Beiyiovo/stm32-infusion-monitor/README.md

# 基于单片机的输液状态 WiFi 监测装置

> 毕业设计 · 电子工程学院 · 物联网工程
> 状态：**硬件全功能打通，收尾中**（2026-10-27：13 段固件 + App v3，称重已达标 ±0.1g；PCB 待打样）

用 STM32 采集输液液体的**温度**与**剩余重量**，OLED 实时显示，超阈值时蜂鸣器 + LED 分级报警，
再通过 WiFi 把数据送到手机上查看。

---

> 📦 **接收方先看 [`交付说明.md`](交付说明.md)**——那里写清了目录结构、复现步骤、验证程度与已知限制。
> 本 README 是面向开发者的技术说明。

## 一、课题指标

| # | 要求 | 指标 | 实现手段 | 状态 |
|---|---|---|---|---|
| 1 | 液体温度采集 | 25~42℃，≤±0.5℃ | DS18B20（12 位） | ✅ 上板验证（34.2→35.2℃ 连续变化；探头接触故障已排除） |
| 2 | 液体重量采集 | ≤±2g | 1kg 悬臂梁 + HX711（24 位） | ✅ **达标**：741.6 counts/g 砝码标定，复核最大偏差 ±0.1 g（余量 20 倍） |
| 3 | 报警 | 按键自定义阈值 + 蜂鸣器 + LED | 4 键 UI + 黄/红两级 + 进阶阈值页 | ✅ 上板验证（常规/进阶阈值可改，声光动作正确） |
| 4 | 显示 | 实时显示温度与重量 | 0.96" OLED（SSD1306，I2C） | ✅ 上板验证（88 字中文界面：温度/重量/滴速） |
| 5 | WiFi 上传 | 手机查看 | ESP32-C3（AT 固件）TCP Server + 安卓 App | ✅ 上板验证（热点+TCP+App 收到数据） |
| 6 | 滴速采集 | 滴/min | 红外对射（分体式）+ 外部中断计数 | ⏳ 模块已接入，开机自检通过；整机滴速计数待最终联调 |

### 称重标定进度（2026-10-27，砝码组）

| 项 | 值 |
|---|---|
| 零点 ZERO | 765410（空秤实测；整机每次开机自动去皮重采） |
| 换算系数 SCALE | **741.6 counts/g**（KEY4 实测 742.35，按复测 -0.1 g 微调） |
| 标定基准 | 标准砝码组 5/10/20/20/50 g（锚定点 = 50+20+20+10 = 100 g） |
| 线性度 | 50g → 740.0、100g → 741.0 counts/g（0.14%） |
| 复核 | 5 / 10 / 50 / 105 g 全过，最大偏差 ±0.1 g（指标 ±2 g，余量 20 倍） |
| 历史教训 | 10-24 用水初标 802.0，秤架重装后实测 742（差 8%）——**装盒后必须重标** |

**复标公式**：`新系数 = 旧系数 × (装置读数 ÷ 砝码真实重量)`（`11_calib` 固件可直接输出）

**显示微调说明**：W = counts ÷ K，显示要往上、系数就往下；±0.1 g 已是 0.1g 分辨率的最小一格，到达噪声地板后不再追调。

## 二、硬件构成

| 器件 | 型号 / 规格 | 作用 | 备注 |
|---|---|---|---|
| 主控 | STM32F103C8T6 最小系统板 | 采集、显示、报警、数据打包 | 蓝板，**无板载 CH340** |
| 无线 | ESP32-C3 核心板（CORE-ESP32，4MB） | WiFi + TCP Server | 烧 AT 固件 V4.1.1.0 |
| 温度 | DS18B20 防水探头 | 液体温度 | 精度规格本身 ±0.5℃ |
| 称重 | 1kg 悬臂梁 + HX711 | 剩余药量 | 0.05%FS 估算 ≈ 0.5g |
| 滴速 | 红外对射（分体式）+ 遮光罩 | 数滴/分钟 | 夹滴壶两侧；槽型光耦装不上 |
| 显示 | 0.96 寸 OLED，I2C，4 针 | 人机界面 | 需 4.7kΩ 上拉 |
| 报警 | 有源蜂鸣器模块 + 红/黄 LED | 分级报警 | 蜂鸣器 VCC 必须 3.3V |
| 输入 | 轻触按键 6×6×5 ×4 | 设置/加/减/确认 | 内部上拉，另一端接 GND |

引脚分配与逐脚接线见 [`文档/502引脚分配与逐脚连线表.docx`](文档/)。

---

## 三、目录结构

```
.
├─ README.md            ← 本文件
├─ 代码/                ← Keil MDK 工程（分阶段，每段可单独编译烧录）
│   ├─ build.bat        ← 一键编译：build.bat 01_uart
│   └─ 01_uart/         ← 阶段 1：串口 + 心跳
├─ 文档/                ← 需求、选型、采购、接线、验证方案
├─ 测试记录/            ← 标定数据、串口日志、实物照片
├─ _工具/               ← 生成文档的 Python 脚本（改文档先改脚本）
└─ AGENTS.md            ← 开发过程记录（决策、踩坑、进度）
```

---

## 四、快速开始

### 编译

```powershell
代码\build.bat 01_uart
```

需要 Keil MDK 5.42（ARMCLANG V6.23）。产物：`代码\01_uart\Objects\502_01_uart.bin`。
> 本工程实测可在**含中文的路径**下编译（0 Error 0 Warning）。

### 烧录

蓝板无板载 CH340，只能串口 ISP：

1. USB-TTL 接 `TXD→PA10`、`RXD→PA9`、`GND→GND`
2. BOOT0 拨到 **1**，复位
3. 烧 `502_01_uart.bin`，**波特率 9600**（115200 实测从未成功）
4. 烧完 BOOT0 拨回 **0**，复位
5. 串口助手 115200 8N1 看打印

### 接线

按 `文档/502引脚分配与逐脚连线表.docx` 的「逐脚连线表」接，
接之前先过一遍「12 条硬约束」——尤其 I2C 上拉、蜂鸣器 3.3V、ESP32 独立供电。

---

## 五、设计决策（为什么这么做）

| 决策 | 选择 | 理由 |
|---|---|---|
| 主控方案 | STM32 + ESP32（AT 固件），不用 ESP32 单主控 | 可复用上一项目（个人健康助手）已验证的驱动框架；ESP32 不必重烧固件 |
| 数据怎么走 | ESP32 做 TCP Server，手机与它同一热点，安卓 App 直连 | 不依赖外网，答辩现场稳；上报层已隔离成单独文件，需要时整体换 MQTT |
| 称重量程 | 1kg（非 5kg） | 按 500ml 袋设计；0.05%FS 下 1kg≈0.5g、5kg≈2.5g，后者会吃掉整个 ±2g 余量 |
| 滴速传感器 | 红外对射（分体式） | 滴壶直径约 20mm，槽型光耦（约 5mm 槽）卡不进去，必须让光路横穿壶体 |
| 报警分级 | 黄灯预警 / 红灯+蜂鸣 | 课题任务书要求"分级报警" |

---

## 六、已知限制（诚实清单）

- **局域网直连 ≠ 云平台**：手机必须与 ESP32 在同一热点，离开就看不到；若验收按字面要求"上传平台"，需切 MQTT
- **现场 WiFi 有坑**：校园网要 Portal 认证，ESP32 过不去 → 演示要用手机热点或实验室路由器
- **开机自动去皮有 ±0.x g 残差**（时有时无）—— 必要时 K4 长按手动去皮
- 称重 ±0.1 g（达标）、温度已实测；**滴速 ±3 滴/min 尚无最终联调数据**
- 滴速在"液滴成线"时数不到 —— 光学方法的原理性局限，不是 bug

---

## 七、进度

| 阶段 | 内容 | 状态 |
|---|---|---|
| 01 | 串口 + 心跳 | ✅ 编译通过 |
| 02 | OLED 显示 | ✅ 编译通过 |
| 03 | DS18B20 温度 | ✅ 编译通过 |
| 04 | 4 键输入 | ✅ 编译通过 |
| 05 | 两级告警（黄/红） | ✅ 编译通过 |
| 06 | HX711 称重 | ✅ 编译通过 |
| 07 | 红外对射滴速 | ✅ 编译通过 |
| 08 | ESP32 AT + TCP 上报 | ✅ 编译通过（AT 序列未上板验证） |
| 09 | 整机固件 v1（**历史版本，已被 13 取代**） | ✅ 编译通过 |
| 10 | **接线自检**（一次上电验全部接线，不依赖称重） | ✅ **已上板跑通**（2026-10-22 收到心跳 `[HB]`） |
| 11 | **称重标定**（按键定零点 / 算换算系数） | ✅ 编译通过 |
| 12 | 面包板逐模块验证 | ✅ 完成（2026-10-27 全部模块上板验证通过） |
| 13 | 安卓 App（独立工程） | ✅ **已编译出 APK**（2026-10-22，`代码\android\apk\502-输液监测-debug.apk`） |

> ⚠️ 除 `10_selftest` 已在真机上跑出心跳外，其余各段仍只有"编译通过"，**没有逐项硬件验证**。
> Flash 占用：整机 `09_main` = Code 17924 + RO 2020 ≈ **19.9KB / 32KB**（61%），余量够。

---

## 八、当前状态（2026-10-27 更新）

✅ **已完成**：13 段固件全部编译通过并逐项上板验证（自检 / OLED / 温度 / 四键 / 分级报警 / 称重 / 热点+TCP+App）；
称重砝码标定达标（±0.1 g）；App v3（克重主视觉 + 趋势图 + 剩余时间估算）；
交付物打包（交付说明 / 固件 / 硬件 / 测试记录）；全部提交已推送 GitHub。

⏳ **进行中 / 待办**：

| 事项 | 状态 |
|---|---|
| 滴速整机联调 | 红外模块已接入（开机自检 + 电平监测通过），整机滴速计数待最终联调 |
| PCB 打样 | 已布完线，DRC 0 错误，待下单；**装盒后称重必须重标**（742→741.6 的教训） |
| 云平台 / 小程序（C3） | 决策未定：局域网 TCP 已稳；上云需切 `report_mqtt.c`（约 2~3 天） |
| 交付包客户化整理 | 进行中 |

（2026-10-22 版的五步推进清单已全部完成，历史版本见 git 记录。）

## 九、文档索引

| 文档 | 内容 |
|---|---|
| `文档/项目交接说明.docx` | 课题原文、需求分析、选型对比、技术风险 |
| `文档/502采购清单(可勾选).xlsx` | 买什么、为什么不能复用、到货怎么验、预算 |
| `文档/502引脚分配与逐脚连线表.docx` | 引脚分配、逐器件连线、12 条硬约束、排错对照 |
| `文档/502可行性验证方案.docx` | 8 阶段验收、称重/温度标定步骤、指标判定表 |
| `文档/代码移植计划.md` | 代码分段计划与依赖关系 |
| `AGENTS.md` | 开发过程记录：决策、踩坑、更正 |

---

## 十一、功能说明 v2.0（2026-10-22）

### 1. 四个按键

| 键 | 短按 | 长按 3 秒 |
|---|---|---|
| **KEY1** | 运行界面 ⇄ 系统面板 | — |
| **KEY2** | 静音 10 分钟 / 取消静音（**设置界面里改为「减一」**） | — |
| **KEY3** | 进入设置；设置里切换参数项（温度上限→重量下限→滴速上限） | 恢复默认阈值 |
| **KEY4** | 设置里：当前参数 **+1 档** | 称重去皮（HX711） |

设置界面的完整操作：`K3` 切换项目 → `K4` 加 / `K2` 减 → `K1` 退出。
开机/复位时蜂鸣器响 3 秒、红黄灯同时亮 3 秒，作为上电自检提示。

### 2. 红/黄灯与蜂鸣器

| 条件 | 等级 | 红灯 | 黄灯 | 蜂鸣器 |
|---|---|---|---|---|
| 全部正常 | OK | 灭 | 灭 | 静音 |
| 温度 41.5~42.0℃ | WARN | 灭 | **1Hz 慢闪** | 静音 |
| **温度 < 32.0℃** | WARN | 灭 | **1Hz 慢闪** | 静音 |
| 重量 50~100 g | WARN | 灭 | **1Hz 慢闪** | 静音 |
| 温度 ≥ 42.0℃ | ALARM | **2Hz 闪** | 灭 | **响 3 秒后自停** |
| 重量 < 50 g | ALARM | **2Hz 闪** | 灭 | **响 3 秒后自停** |
| **滴速 ≥ 120 滴/分** | ALARM | **4Hz 快闪** | 灭 | 响 3 秒（快闪区分于普通报警） |

- 蜂鸣器只在**从正常/预警 进入 报警的那一刻**响 3 秒，之后靠灯提示，不会一直吵
- KEY2 静音后蜂鸣器不再响，灯照常；10 分钟后自动恢复

### 3. OLED 显示

**开机自检页（约 3 秒）**

```
   开机自检
TEMP  OK
HX711 --
IR    --
NET   OK
v2.0 3s...
```

**主页**（默认，显示温度/重量/滴速）

```
   输液监测
温度   34.2C
重量  480.0g
滴速     60
```

报警时标题行自动变成「报警 温度过高」/「预警 温度过低」，正文数据不变。

**系统状态页**（KEY1 进入）：静音 是/否、网络 已连/待机/异常、状态 正常/预警/报警

**参数设置**（KEY3 进入）：温度上限 / 重量下限 / 滴速上限三行，`>` 标当前项

### 4. 上报帧

```
T=34.2,W=480,D=60,L=0,R=0
```

`L`：0 正常 / 1 预警 / 2 报警；`R`：位掩码 1=温度过高 2=温度过低 4=药液将尽 8=滴速过快
16=重量异常 32=滴速过慢（v2.2 进阶预警，只黄不红）。
App 会按 `L` 变色、按 `R` 显示原因（旧版 App 遇到 16/32 显示为通用预警）。

---

### 5. v2.1 / v2.2 更新（2026-10-27，覆盖上文对应描述）

| 项 | v2.2 行为 |
|---|---|
| 开机提示 | 「滴滴」两声（80ms×2）+ 红黄灯亮 1.5 秒（原 3 秒长鸣） |
| 报警蜂鸣 | 进入报警响 **3 声短促哔**（120ms×3）后自停；预警仍只闪黄灯不响 |
| 按键 K3 | **松手判定**：运行页短按进「参数设置」、**长按 2 秒进「设置2」**；设置页内短按下一项、长按 2 秒恢复全部默认 |
| 进阶阈值「设置2」 | 温度下限（默认 20.0℃，可调 15.0~38.0℃）/ 重量上限（默认 1000g）/ 滴速下限（默认 0=关）；只做黄色预警，不红不响 |
| 上报 R 位 | 新增 16=重量异常、32=滴速过慢 |
| 字库 | 88 字（补「待」「慢」） |
| 称重滤波 | 10Hz 非阻塞采样 + 15 点去极值中均值 |

---

## 十二、致谢

硬件框架与部分驱动沿用作者上一项目《基于 STM32 的个人健康助手》的已验证成果。
