Beiyiovo/stm32-infusion-monitor/00_客户必读.md

# ⭐ 客户必读（从这里开始）

> **基于单片机的输液状态 WiFi 监测装置** · 谢玲 2352500401 · 交付版本 v2.2（2026-10-28）
>
> 📄 **要看排版好的总说明书，直接打开 `00_客户交付说明书.docx`（10 页，含按键表、参数表、文件夹导览、验证清单、FAQ）。**
> 本文件是同一份内容的纯文本速查版。
>
> 本文件是交付包的入口。3 分钟看完，你就知道每个文件夹是什么、怎么把装置跑起来、
> 哪些功能已经实测达标、哪些还没有。

---

## 一、这套装置是什么（30 秒版）

```
液袋 → 称重传感器(1kg) → HX711 ─┐
     温度探头(DS18B20) ──────────┤→ STM32F103C8T6 ─→ OLED(0.96" 中文界面)
     红外数滴 ───────────────────┘        │
                                          ├→ 蜂鸣器 + 红/黄灯（两级报警）
                                          └→ ESP32-C3 → WiFi 热点 → 手机 App
```

- **测什么**：液体温度（25~42℃）、剩余重量（±2g 指标）、滴速（滴/分）
- **怎么报警**：超阈值红灯闪 + 蜂鸣 3 声；接近阈值黄灯慢闪；阈值可用按键改
- **怎么看**：OLED 本地看；手机连热点 `502-Infusion`（密码 `12345678`）用 App 看

---

## 二、目录地图（每个文件夹一句话）

| 位置 | 是什么 | 你什么时候用 |
|---|---|---|
| `交付说明.md` | **交付总说明**（结构/复现/验证程度/限制） | 第二个看 |
| `文档/502使用说明与文件导览.docx` | **Word 版手册**：按键功能 × 界面矩阵、代码地图、文件夹导览 | 查按键/查文件时 |
| `README.md` | 开发者视角的技术文档（设计决策、功能细节） | 想深入时看 |
| `固件/` | 13 个阶段的 .bin/.hex，**不装 Keil 也能烧** | 复现时用 |
| `代码/` | 全部 Keil 工程（01_uart…13_ui）+ 安卓 App 工程 | 改代码时用 |
| `代码/android/apk/` | **现成的手机 App 安装包**（debug 版） | 装到手机 |
| `文档/` | 10 份设计文档（交接/采购/引脚/验证/PCB…） | 按需查阅 |
| `文档/502面包板连线与调试指南.docx` | **42 根线逐根接线表** | 复现接线时 |
| `测试记录/` | 实测数据（标定、串口、问题清单） | 查证据 |
| `硬件/` | 原理图网表 + PCB 图 | 打样/改板时 |
| `CHANGELOG.md` | 每个问题的「现象→原因→修复→验证」 | 查历史 |
| `AGENTS.md` | 开发过程完整记录（决策、踩坑、教训） | 想知道"为什么这么做" |
| `_工具/` | 生成文档/字库的 Python 脚本 | 改文档后重新生成 |

---

## 三、5 分钟跑起来

1. **接线**：照 `文档/502面包板连线与调试指南.docx` 逐根接（先读开头的 12 条硬约束）
2. **烧固件**：把 `固件/13_整机v2(当前).bin` 烧进 STM32（ST-Link 或串口 ISP 均可，
   串口法：BOOT0=1 → 复位 → 烧 → BOOT0=0 → 复位；烧录工具 `代码/flash_any.bat`）
3. **本地看**：上电 → OLED「滴滴」两声自检 → 主页显示温度/重量/滴速
4. **手机看**：WiFi 连 `502-Infusion`（12345678）→ 装 `代码/android/apk/502-输液监测-debug.apk`
   → App 点「连接设备」（192.168.4.1:8080）

---

## 四、验证到什么程度（诚实清单，2026-10-27）

| 功能 | 状态 |
|---|---|
| 温度采集 | ✅ 上板验证（34.2→35.2℃ 连续变化） |
| **称重采集** | ✅ **达标**：741.6 counts/g 砝码标定，五点复核最大偏差 **±0.1g**（指标 ±2g） |
| 分级报警（红/黄/蜂鸣/阈值自定义） | ✅ 上板验证 |
| OLED 中文显示 | ✅ 上板验证（88 字字库） |
| WiFi + TCP + 手机 App | ✅ 上板验证（热点 + App v3 收数） |
| 滴速采集 | ⏳ 红外模块已接入（开机自检通过）；整机滴速计数待最终联调 |
| PCB | 🔄 已布线 DRC 0 错，待打样 |

**没验证的没有写成"已达标"**——细节见 `交付说明.md` 第四节和 `测试记录/502测试记录.docx`。

---

## 五、常见问题（FAQ）

| 问题 | 答案 |
|---|---|
| 烧不进去？ | 串口法波特率用 **9600/38400**（115200 实测从未成功）；ST-Link 法无需拨 BOOT0 |
| 温度读不到？ | 先查探头三根线（VCC 3.3V / GND / **DQ→PA0**）+ 4.7kΩ 上拉；本套件 10-27 出过一次 DQ 接触不良 |
| 重量不准？ | 开机自动去皮有 ±0.x g 残差属正常，**K4 长按 2 秒手动去皮**；换称架/装盒后必须重标（`11_calib`） |
| 想改报警阈值？ | 运行页 K3 短按 = 常规（温度上限/重量下限/滴速上限）；**K3 长按 2 秒 = 进阶**（温度下限/重量上限/滴速下限） |
| 静音？ | K2 短按静音 10 分钟 |
| 校园网能直接用吗？ | 热点模式不依赖外网，任何环境可用；上云（MQTT）是预留能力，切换见 `交付说明.md` 第七节 |
| 液滴成线数不到滴速？ | 光学方法原理性局限，报告里已如实说明 |

---

## 六、素材位（拍摄后放进 `交付素材/`）

`交付素材/` 目录已建好并有**拍摄清单**（拍什么、拍多久、怎么命名、放哪里）。
拍完放进去即可，不需要改任何文档——清单里写好了每条素材对应文档的哪个章节。

---

*本交付包 2026-10-27 由开发过程直接打包；git 历史完整保留（含每个 bug 的修复过程）。*
