Beiyiovo/stm32-infusion-monitor/交付说明.md

# 交付说明（先看这个）

> **502 输液状态监测装置** · 谢玲 2352500401 · 2026-10-27
>
> 本文件夹是这套装置的**完整交付物**：源代码、可烧录固件、全部设计文档、
> 测试记录、原理图网表与 PCB 图。用它可以从零复现整个装置。

---

## 一、30 秒了解这套东西

```
液袋 → 称重传感器(1kg) → HX711 ─┐
     温度探头(DS18B20) ──────────┤→ STM32F103C8T6 ─→ OLED(0.96" 中文)
     红外数滴 ───────────────────┘        │
                                          ├→ 蜂鸣器 + 红/黄双色灯（分级报警）
                                          └→ ESP32-C3(AT) → WiFi 热点 → 手机 App
```

- **测什么**：液体温度、剩余重量、滴速
- **怎么报警**：超阈值时蜂鸣器响 + 红灯闪；预警时黄灯慢闪（阈值可按键自定义）
- **怎么看**：OLED 本地看，手机 App 远程看（同一热点内 TCP）

---

## 二、目录结构

| 目录 | 里面是什么 | 怎么用 |
|---|---|---|
| **`固件/`** | 13 个阶段的 `.bin` / `.hex` | 不装 Keil 也能直接烧（推荐先烧 `10_接线自检`） |
| **`代码/`** | 13 个 Keil 工程 + 安卓 App 工程 | 用 Keil 打开 `*.uvprojx`；App 工程用 Android Studio |
| **`文档/`** | 10 份 Word 文档 | 交接说明、采购清单、引脚表、验证方案、面包板连线、PCB 规范… |
| **`测试记录/`** | 实测记录 Word | 含串口原始数据、标定数据、问题与修复清单 |
| **`硬件/`** | 原理图网表 + PCB 图 | 立创EDA 专业版工程可据此重建 |
| **`_工具/`** | 生成文档与字库的 Python 脚本 | 改文档后重新生成用 |

---

## 三、从零复现（照着做）

### 第 1 步：接线

打开 `文档/502面包板连线与调试指南.docx`，按 42 根线的表接面包板。

### 第 2 步：烧录

```powershell
代码\flash_any.bat          # 自动编译 + 找串口 + 烧录
```

或者直接烧现成的：把 `固件/13_整机v2(当前).bin` 用任意 STM32 烧录工具写入。

**串口 ISP 接法**：USB-TTL 的 TXD→PA10、RXD→PA9、GND→GND，BOOT0=1 烧完拨回 0。

### 第 3 步：验证

```powershell
代码\serial.bat             # 打开串口助手（115200）
```

先烧 `固件/10_接线自检.bin`，一次验完 I2C、温度、按键、声光、红外。

### 第 4 步：手机端

1. 手机 WiFi 连 `502-Infusion`（密码 `12345678`）
2. 安装 `代码/android/apk/502-输液监测-debug.apk`
3. 打开 App → 点「连接设备」（地址 `192.168.4.1:8080`）

---

## 四、验证到什么程度（诚实清单）

| 功能 | 状态 |
|---|---|
| 温度采集 | ✅ 上板验证（34.2~35.2℃ 连续变化） |
| 称重采集 | ✅ **达标**：741.6 counts/g（砝码组标定），复核最大偏差 ±0.1 g（余量 20 倍） |
| 滴速采集 | ⏳ 红外模块已接入（开机自检+电平监测）；整机滴速计数待最终联调 |
| 分级报警 | ✅ 上板验证（阈值可改、声光动作正确） |
| OLED 显示 | ✅ 上板验证（中文界面：温度/重量/滴速） |
| WiFi + App | ✅ 上板验证（热点、TCP、App 收到数据） |
| PCB | 🔄 已布完线，DRC 0 错误，待打样 |

**未验证的地方没有写成"已达标"**，详见 `测试记录/502测试记录.docx` 第五节。

---

## 五、硬件清单

| 件 | 型号/规格 | 数量 |
|---|---|---|
| 主控 | STM32F103C8T6 最小系统板 | 1 |
| 无线 | ESP32-C3 CORE（AT 固件 V4.1.1.0） | 1 |
| 显示 | 0.96" OLED SSD1306（I2C，0x3C） | 1 |
| 温度 | DS18B20 防水探头 | 1 |
| 称重 | 1 kg 电阻应变式 + HX711 模块 | 1 |
| 数滴 | 红外对射/槽型模块 | 1 |
| 报警 | 有源蜂鸣器 + 红/黄 LED | 1 套 |
| 输入 | 6×6 轻触按键 | 4 |
| 其他 | 4.7kΩ×3、220Ω×2、杜邦线、面包板 | — |
| 烧录 | CH340 USB-TTL | 1 |

---

## 六、几个关键约定（改代码前必读）

| 项 | 值 | 在哪改 |
|---|---|---|
| WiFi 热点名 / 密码 | `502-Infusion` / `12345678` | `代码/_common/report_tcp.h` |
| TCP 端口 | 8080 | 同上 |
| 称重换算系数 | `741.6f` counts/g | `代码/_common/hx711.h` |
| 温度阈值 | 预警 41.5℃ / 报警 42.0℃ / 过低 20.0℃（进阶页可调 15~38℃） | `代码/_common/alert502.h` |
| 进阶阈值 | 重量上限默认 1000g / 滴速下限默认 0=关（运行页 K3 长按 2 秒进「设置2」） | `代码/_common/alert502.h` |
| 重量阈值 | 预警 100g / 报警 50g | 同上 |
| 滴速阈值 | 120 滴/分 | 同上 |
| OLED 字库 | 88 字，`_工具/gen_cnfont.py` 生成 | 加字后重新生成 |

---

## 七、已知限制（答辩时要自己先说）

1. **"远程"其实是同一局域网** —— 手机与 ESP32 连同一热点，不是真正的云平台。
   上报层已隔离（`report_tcp.c`），换 `report_mqtt.c` 即可上云，约 2~3 天工作量。
2. **滴速在"成线"时数不到** —— 流速过快时液滴连成液柱，光学方法无离散跳变。
3. **开机自动去皮有 ±0.x g 残差** —— 必要时 K4 长按手动去皮；称重复核偏差 ±0.1 g（±2g 指标达标）。
4. **iOS 无原生 App** —— 协议层开放，任何 TCP 客户端可读；后续可改 ESP32 内置 HTTP 服务做网页版。

---

## 八、文档索引

| 想了解 | 看哪份 |
|---|---|
| **按键功能 / 代码在哪 / 文件夹导览** | `文档/502使用说明与文件导览.docx` |
| 整体交接、进度、决策 | `文档/项目交接说明.docx` |
| 怎么接线（面包板） | `文档/502面包板连线与调试指南.docx` |
| 每个引脚接哪 | `文档/502_STM32逐脚接线顺序表.docx` |
| 买什么 | `文档/502采购清单(可勾选).xlsx` |
| 怎么验证 | `文档/502可行性验证方案.docx` |
| 画 PCB | `文档/502_PCB设计与布线规范.docx` |
| 网络标签怎么起名 | `文档/502网络标签总表.docx` |
| 实测数据 | `测试记录/502测试记录.docx` |
| 改了什么 bug | `CHANGELOG.md` |

---

*本交付物由谢玲整理，代码与文档在 2026-10 期间逐版迭代，全部测试数据来自真实硬件。*
