Beiyiovo/stm32-infusion-monitor/测试记录/串口原始记录.md

# 串口原始记录（摘录）

## 1. 接线自检（10_selftest，2026-10-22）

```
  502 接线自检 v1.0
  串口 115200 8N1
==============================================
[1] 板载 LED 应已点亮（PC13，低电平点亮）
[2] I2C 发现设备: 0x1E
[2] I2C 发现设备: 0x5E
[2] OLED(0x3C) 在线 ✔
[3] DS18B20 = 34.2℃ ✔
[5] 声光自检：蜂鸣器响一声，红/黄灯各闪一次
[6] 红外对射：用手挡一下光路，看下面是否打印电平变化
------------------------------------------------
[IR] 初始电平 = 1（通光时）
[HB] 运行中 3 s
[TEMP] 34.2℃
```

## 2. ESP32 与 TCP 链路（13_ui 开机，2026-10-22）

```
  502 整机固件 v2.0
[NET] 等 ESP32 启动（2s）...
[NET] AT 正常 ✔
[NET] 设为 AP 模式...
[NET] 建热点 502-Infusion ...
[NET] 多连接模式...
[NET] 开 TCP Server :8080 ...
[NET] 就绪：手机连热点 502-Infusion，访问 192.168.4.1:8080
[BOOT] TEMP=1 HX711=0 NET=1
[NET] 客户端 #0 已连接
```

## 3. 称重标定（11_calib，2026-10-24）

```
[CAL] ★ ZERO = 764832
[CAL] 标定重量 → 200 g
[CAL] 标定重量 → 500 g
[KEY] KEY4 事件=2
[CAL] AVG = 1165827, CAL = 500 g
[CAL] SCALE = 801.990 counts/g
[KEY] KEY4 事件=2
[CAL] AVG = 1165792, CAL = 500 g
[CAL] SCALE = 801.920 counts/g
```

## 4. 已知异常（如实记录）

- 第一版标定时误在"水已放上"的情况下按了 KEY1，采到 ZERO=1165808（把水当成了零点），
  该组数据作废，已在固件中加入零点突变告警。
- 复核实测：193 g 手机 → 读数 189.1 g，偏小 2.0%。
