Beiyiovo/stm32-infusion-monitor/文档/代码移植计划.md

# bishei502 代码工程 · 移植计划

> 建立：2026-10-21（2026-10-21 晚更新：改到中文路径下、量程改 1kg）
> 源工程：`T:\AS\bishe501\`（项目1，24 个分段工程，全部已在硬件上跑通）
> 目标：`T:\AS\毕业设计\毕业设计2\代码\`
> ★ 2026-10-21 实测：**这个中文路径下 Keil 能正常编译**（V6.23，0 错 0 警），
>   所以代码不再单独放 `T:\AS\bishei502\`，交付时整个 `毕业设计2\` 文件夹搬走即可。

---

## 一、为什么可以照搬

项目2 与项目1 的**硬件骨架同源**：同一块 STM32F103C8T6、同样的 OLED(I2C)、DS18B20、蜂鸣器、按键、
同样的 ESP32-C3 AT 链路（USART2 / PA2-PA3）。引脚表见 `..\文档\502引脚分配与逐脚连线表.docx`。

**只有 3 处是新的**：PB5 黄灯、PB10/PB11 HX711、PA6 第四按键。

---

## 二、阶段划分（每段单独可烧、单独验）

| 502 阶段 | 从 501 搬哪个 | 要改什么 | 验收判据 | 依赖待定项？ |
|---|---|---|---|---|
| `01_uart` | `01_uart` | ✅ 已建，只改打印内容 | 串口能看到开机计数 | ❌ |
| `02_oled` | `04_oled`（可参考 `11/13/18/19`） | 显示内容改成"温度/重量/状态"布局 | 屏幕亮、字清楚 | ❌ |
| `03_ds18b20` | `05_ds18b20` | 换 PA0 | 室温读数合理，丢掉上电首值 85 | ❌ |
| `04_key` | `24_key_test` | 按键数 3→4，加 PA6 | 4 个键消抖稳定 | ❌ |
| `05_alert` | `08_alert` | 加 PB5 黄灯，做黄/红两级 | 分级报警按预期 | ❌ |
| `06_hx711` | **无，新写** | 24 位读取、去皮、滑动平均 | 按压时数值变化，不是 0xFFFFFF | ❌ |
| `07_at_link` | `02_esp_link` | 仅改注释 | 发 AT 回 OK | ❌ |
| `08_http` 或 `08_mqtt` | **无，新写** | 二选一，见第四节 | 手机能看到页面 / 云端能看到数据 | ✅ **等导师** |
| `09_ui` | 部分参考 `09_main` | 菜单、阈值设置、阈值下发到报警层 | 按键改阈值后报警生效 | ⚠️ 半依赖 |
| `10_main` | `09_main` | 整合全部 | 端到端跑 2 小时 | ✅ 依赖前面全部 |

**前 7 个阶段与"滴速/上传平台"两个待定项完全无关**，货到就能一路推上去。

---

## 三、搬运时必改的 3 个地方（项目1 的踩坑）

1. **宏定义里的引脚**（`bsp_*.h` 或 `main.c` 顶部）—— PB6/PB7/PA0/PB0/PB1/PA2/PA3/PA9/PA10 不变，
   但项目1 里若把 MPU6050/MAX30102 的引脚也写进去了，要删掉。
2. **`-O2` 与 Flash 上限**：项目1 最终 27400 字节 / 32768。项目2 去掉两个大模块后约 20~22KB，
   但如果把整张 HTML 页面写进常量，注意别超。
3. **烧录**：这块蓝板没有板载 CH340，只能 USB-TTL 串口 ISP，且**实测 9600 才稳**。
   参考 `T:\AS\bishe501\flash_any.bat` 的握手探测逻辑，改成扫本工程目录。

---

## 四、`08` 这一层怎么做到"两种方案都能换"

**把"数据上报"做成一个函数（弱符号/函数指针）**，两套实现各自一个 .c 文件：

```
   report.h        →  void report_publish(float t, float w, uint8_t state);
   report_http.c   →  AP 模式：CIPMUX/CIPSERVER，收到 +IPD 就回一张固定 HTML
   report_mqtt.c   →  STA 模式：AT+CWJAP 连路由 + AT+MQTTCONN + AT+MQTTPUB
```

`main.c` 只调 `report_publish()`。**导师定哪一种，就编译哪一个 .c，另一个不加入工程。**

---

## 五、待定项（等导师回复）

| # | 待定 | 影响 |
|---|---|---|
| 1 | 滴速做不做 | 要不要加 `drop_rate.c` + 红外对射（PB12 已预留 3P 排针） |
| 2 | 上传平台还是手机直连 | 决定 `08` 用 http 还是 mqtt |
| 3 | 要不要打 PCB | 决定要不要买排母/洞洞板 |

---

## 六、编译方法

```powershell
T:\AS\毕业设计\毕业设计2\代码\build.bat 01_uart
```

产出：`代码\01_uart\Objects\502_01_uart.bin`（当前 4272 字节，Code 3212 + RO 1052）。
