Beiyiovo/stm32-infusion-monitor/文档/502使用说明与文件导览.docx

502 输液状态 WiFi 监测装置 · 使用说明与文件导览

按键功能 · 代码地图 · 文件夹里都有什么

对应固件 v2.2 · 2026-10-28 · 谢玲 2352500401

先看这里

这份文档回答三个问题：①四个按键分别在什么界面下干什么；②实现代码放在哪个文件夹、

要改东西去哪个文件；③整个「毕业设计2」文件夹里每样东西是干什么用的。

数据与行为描述全部对应当前固件 v2.2（2026-10-27 定稿），与实际代码逐条核对过。

# 一、装置 30 秒介绍

液袋挂在称重台上，装置实时测量三个量：液体温度（DS18B20）、剩余重量（1kg 悬臂梁 + HX711）、滴速（红外对射计数）。OLED 用中文界面本地显示；任何一项越过阈值就声光分级报警（黄灯预警 / 红灯 + 蜂鸣报警）；同时通过 ESP32-C3 开出 WiFi 热点，手机连上热点后用安卓 App 实时查看（TCP 直连，不依赖外网）。

# 二、开机过程（上电后你会看到什么）

阶段 | 时长 | 现象
① 上电提示 | 约 1.5 秒 | 蜂鸣器「滴滴」两声，红黄灯同时亮 1.5 秒（同时完成红外模块自检）
② 开机自检页 | 约 1.5 秒 | 屏幕显示 温度 / 称重 / 网络 三项「通过」或「失败」
③ 运行页 | 持续 | 标题「输液监测」+ 温度 / 重量 / 滴速 三行实时数据；报警时标题行自动变成「报警 原因」或「预警 原因」

注：空秤状态下重量为 0g，低于 50g 报警线，属于正常的「药液将尽」报警——放上液袋或砝码即解除。

# 三、按键功能详解（核心章节）

四个按键的功能与「当前在哪个界面」有关。先记住一条总规则：

按键判定规则

K1 / K2：按下立即生效。

K3 / K4：松手时才判定——按住不到 2 秒算短按，按住满 2 秒算长按（K4 的长按阈值是 0.8 秒）。

K3 的事件在程序里只读取一次，这是 10-27 修复过的重要 bug（详见 CHANGELOG）。

## 3.1 按键总览（四个界面 × 四个键）

按键 | 运行页（主页） | 系统面板页 | 参数设置页 | 设置2（进阶）
K1 短按 | 切到系统面板页 | 回运行页 | 退出，回运行页 | 退出，回运行页
K2 短按 | 静音 10 分钟 / 取消静音 | 静音 10 分钟 / 取消静音 | 当前项 −1 步 | 当前项 −1 步
K3 短按 | 进入「参数设置」 | —（无动作） | 切换到下一参数项 | 切换到下一参数项
K3 长按 2 秒 | 进入「设置2」进阶 | —（无动作） | 恢复全部默认阈值 | 恢复全部默认阈值
K4 短按 | —（无动作） | —（无动作） | 当前项 +1 步 | 当前项 +1 步
K4 长按 ≥0.8 秒 | 称重去皮 | 称重去皮 | 称重去皮（不会误触发 +1） | 称重去皮（不会误触发 +1）

## 3.2 参数项与调节范围

「参数设置页」（常规）三项——日常使用主要改这里：

参数项 | 作用 | 可调范围 | 步进 | 默认值
温度上限 | 温度 ≥ 此值红色报警；低 0.5℃ 内黄色预警 | 40.0 ~ 45.0 ℃ | 0.5℃ | 42.0℃
重量下限 | 低于 2 倍此值黄色预警；低于此值红色报警 | 10 ~ 200 g | 10 g | 50 g
滴速上限 | 滴速 ≥ 此值红色报警（红灯 4Hz 快闪） | 60 ~ 200 滴/分 | 10 | 120

「设置2」（进阶）三项——只做黄色预警，永远不会触发红色报警和蜂鸣，默认值放宽到「基本不误报」：

参数项 | 作用 | 可调范围 | 步进 | 默认值
温度下限 | 低于此值黄色预警「温度过低」 | 15.0 ~ 38.0 ℃ | 0.5℃ | 20.0℃
重量上限 | 高于此值黄色预警「重量异常」；0 = 关闭 | 0 或 50~1000 g | 50 g | 1000 g（实际不报）
滴速下限 | 低于此值黄色预警「滴速过慢」；0 = 关闭 | 0 或 10~100 滴/分 | 10 | 0（关闭）

所有阈值在「设置页内 K3 长按 2 秒」一键恢复默认。数值都会写进上报数据帧，App 端同步可见。

# 四、显示与报警行为

## 4.1 OLED 的三个界面

界面 | 进入方式 | 内容
运行页（默认） | 上电即在此；从其它页 K1 返回 | 温度 / 重量 / 滴速三行；报警时标题行显示原因
系统面板页 | 运行页按 K1 | 静音状态 / 网络状态（异常·待机·已连）/ 当前等级（正常·预警·报警）
参数设置页 | 运行页 K3 短按 | 温度上限 / 重量下限 / 滴速上限，「>」标当前项
设置2（进阶） | 运行页 K3 长按 2 秒 | 温度下限 / 重量上限 / 滴速下限，「----」表示关闭

## 4.2 报警矩阵

条件 | 等级 | 红灯 | 黄灯 | 蜂鸣器
全部正常 | 正常 | 灭 | 灭 | 静音
温度 41.5~42.0℃ | 预警 | 灭 | 1Hz 慢闪 | 不响
重量 50~100 g | 预警 | 灭 | 1Hz 慢闪 | 不响
温度 ≥ 42.0℃ | 报警 | 2Hz 闪 | 灭 | 响 3 声后自停
重量 < 50 g | 报警 | 2Hz 闪 | 灭 | 响 3 声后自停
滴速 ≥ 120 滴/分 | 报警 | 4Hz 快闪 | 灭 | 响 3 声后自停
进阶项越限（重量>上限 / 滴速<下限） | 预警 | 灭 | 1Hz 慢闪 | 不响

蜂鸣器只在「从正常/预警 进入 报警」的那一刻响 3 声（每声 120ms），之后靠灯提示不持续吵；K2 静音 10 分钟后蜂鸣器不再响，灯照常闪。

# 五、代码地图（实现代码放在哪）

全部代码在「毕业设计2\代码\」里，采用分阶段工程：每个 01~13 文件夹是一个可以独立编译烧录的 Keil 工程，共享代码全部抽在「_common」里——改任何共享文件，重新编译对应工程即可生效。

## 5.1 分阶段工程（「代码」下的 01~13）

工程 | 内容 | 状态
01_uart | 串口 + 心跳：最小验证环境（时钟/延时/printf） | ✅
02_oled | SSD1306 驱动 + 中文界面显示 | ✅
03_ds18b20 | 温度采集 | ✅
04_key | 按键扫描 / 消抖 / 事件 | ✅
05_alert | 两级告警（红/黄/蜂鸣） | ✅
06_hx711 | 称重读数 | ✅
07_drop | 红外滴速计数 | ✅（整机联调中）
08_tcp | ESP32 AT + WiFi 热点 + TCP 上报 | ✅
09_main | 整机固件 v1（历史版本，已被 13 取代） | —
10_selftest | 接线自检：一次上电验全部接线 | ✅
11_calib | 称重标定：KEY1 定零点 / KEY4 定系数 | ✅
12_led | 红黄灯 / 蜂鸣器专项测试 | ✅
13_ui | ★ 整机固件 v2.2（当前交付版，改功能改这里） | ✅

## 5.2 共享代码（「代码/_common」目录，被各工程共同引用）

文件 | 干什么
bsp.c / bsp.h | 时钟、延时、millis、按键 1~3 扫描与事件、蜂鸣器、红灯
app502.c / app502.h | 黄灯、KEY4 消抖与短/长按事件
i2c.c + oled.c/h | I2C 与 OLED 驱动（显示缓冲 + 逐页刷新，不阻塞按键）
cnfont*.c/h | 88 字中文字库（由 _工具/gen_cnfont.py 自动生成，勿手改）
ds18b20.c / h | 温度传感器（1-Wire，全程关中断保护时序）
hx711.c / h | 称重 ADC：去皮、换算系数（741.6）、克×10 输出
drop.c / h | 滴速：外部中断计数 + 10 秒窗口结算 + 电平自检
alert502.c / h | 分级告警判定 + 蜂鸣状态机 + 全部阈值宏（TH_*）
report_tcp.c / h | ESP32 AT 初始化 + WiFi 热点 + TCP Server + 数据帧

## 5.3 「想改 X → 去改 Y」速查表

想改什么 | 去哪里改
报警阈值默认值 | 代码/_common/alert502.h（TH_TEMP_ALARM、TH_W_WEIGHT、TH_RATE_HIGH、TH_W_HIGH、TH_RATE_LOW 等）
称重换算系数 | 代码/_common/hx711.h（HX711_DEFAULT_SCALE = 741.6f）
WiFi 热点名 / 密码 / 端口 | 代码/_common/report_tcp.h（502-Infusion / 12345678 / 8080）
OLED 增加汉字 | _工具/gen_cnfont.py 的 CHARS 字表 → 重新运行生成
界面布局 / 按键行为 / 主流程 | 代码/13_ui/main.c
报警动作与判定逻辑 | 代码/_common/alert502.c
文档内容 | 先改 _工具/ 下对应生成脚本，再运行重新生成 docx

## 5.4 编译与烧录

编译（命令行）： 代码\build.bat 13_ui ← 产物 代码\13_ui\Objects\502_13_ui.bin
烧录（推荐）： ST-Link + Keil 打开工程按 F8；或 UV4 -f 502_13_ui.uvprojx -j0
烧录（备用）： 代码\flash_any.bat ← 串口 ISP：BOOT0=1 → 复位 → 烧 → BOOT0=0
看串口： 代码\serial.bat（115200，自动找 CH340）

13 个工程当前全部 0 Error / 0 Warning；整机 13_ui 占用 29,480 字节 / 32KB（90%）。

## 5.5 安卓 App

项 | 说明
工程位置 | 代码\android\（Android Studio 打开）
现成安装包 | 代码\android\apk\502-输液监测-debug.apk
连接方式 | 手机 WiFi 连 502-Infusion（12345678）→ App 点「连接设备」（192.168.4.1:8080）
界面 | 克重大字 + 状态色 + 趋势折线 + 剩余时间估算（v3）

# 六、文件夹导览（每样东西都能干什么）

## 6.1 顶层文件

文件 | 干什么用
00_客户必读.md | ★ 交付包入口：3 分钟了解全部内容 + 快速上手 + FAQ
交付说明.md | 交付总说明：目录结构 / 复现步骤 / 验证程度 / 已知限制
README.md | 开发者技术文档：课题指标、设计决策、功能细节
CHANGELOG.md | 修复日志：每个问题按「现象→原因→修复→验证」记录
AGENTS.md | 开发过程完整记录（决策、踩坑、教训、待办）

## 6.2 目录（总大小 41.6 MB，交付预算 2 GB 以内）

目录 | 里面是什么 | 什么时候用
代码\ | 13 个 Keil 工程 + _common 共享代码 + 安卓 App 工程 + 烧录/串口工具 | 开发、改功能、复现
固件\ | 13 套现成 .bin/.hex（中文名），不装 Keil 也能烧 | 直接烧录复现
文档\ | 10 份设计 docx（交接/采购/引脚/接线/验证/PCB…）+ 接线图 PNG | 接线、验收、写论文
测试记录\ | 502测试记录.docx（v1.1，全部实测数据）+ 串口原始记录 | 查证据、答辩
硬件\ | 原理图网表 + PCB 图（立创EDA 可重建） | 打样、改板
交付素材\ | 拍摄清单（照片 P1~P8 / 视频 V1~V5），拍完放这里 | 答辩演示材料
参考文献\ | 课题参考文献 | 写论文
_工具\ | 文档与字库的生成脚本（改文档先改脚本再重新生成） | 维护文档

_工具/ 常用脚本：gen_cnfont.py（字库）、gen_502_testlog.py（测试记录 docx）、gen_502_userguide.py（本文档）、gen_502_bom / gen_502_pinmap / gen_502_wiring / gen_502_verify（采购/引脚/接线/验证文档）。

# 七、5 分钟复现（从零把装置跑起来）

步骤 | 操作 | 判据
1 接线 | 按 文档/502面包板连线与调试指南.docx 逐根接（先读 12 条硬约束） | 对照验收单
2 烧录 | 烧 固件/13_整机v2(当前).bin（ST-Link 或串口 ISP） | Verify OK
3 开机 | 上电：滴滴两声 → 自检页 → 主页 | 温度/称重「通过」
4 报警自测 | 空秤触发「药液将尽」报警，放 100g 砝码解除 | 红灯闪 3 声蜂鸣 → 放砝码解除
5 手机看 | 连热点 502-Infusion → 装 APK → 连接 192.168.4.1:8080 | App 数据与 OLED 一致

# 八、常见问题

问题 | 处理
烧不进去 | 串口法波特率用 9600/38400（115200 实测不通）；ST-Link 法无需拨 BOOT0
温度读不到 | 查探头三根线（VCC 3.3V / GND / DQ→PA0）+ 4.7kΩ 上拉；10-27 出过一次 DQ 接触不良
重量有 ±0.x g 漂移 | 开机自动去皮的正常残差，K4 长按手动去皮；换称架/装盒后必须重新标定（11_calib）
K3 没反应 | K3 只在运行页进设置（面板页无功能）；确认固件为 v2.2 以上（10-27 修复过事件消费 bug）
滴速显示「未接」 | 红外模块 OUT 接 PB12；正常接入后开机自检/运行监测会自动识别
App 连不上 | 手机必须连装置热点 502-Infusion；地址 192.168.4.1:8080

502 输液状态监测装置 · 使用说明与文件导览 v1.0 · 第 页
