Beiyiovo/stm32-infusion-monitor/测试记录/502测试记录.docx

502 输液状态监测装置 · 测试记录

本文件记录 2026-10-22 ~ 10-27 期间的真实测试过程与数据

v1.1 · 谢玲 2352500401

阅读说明

本记录中的数据全部来自实际硬件的串口输出与人工观察，**不是设计预期值**。

未完成的测试项在最后一节如实列出，未做推断。

# 一、测试环境

项 | 配置
主控 | STM32F103C8T6 最小系统板（排母插装）
无线 | ESP32-C3 CORE 开发板（AT 固件 V4.1.1.0，排母插装）
显示 | 0.96" OLED，SSD1306，I2C，地址 0x3C
温度 | DS18B20（三线，4.7kΩ 上拉）
称重 | 1 kg 电阻应变式传感器 + HX711 模块
数滴 | 红外对射模块（分体式，3 针，LM393 比较器输出，2026-10-27 接入）
烧录 | ST-Link V2（SWD，Keil UV4 -f 命令行，2026-10-27 起）；备用：CH340 串口 ISP
软件 | Keil MDK 5.42 / ARMCLANG V6.23 · Android App（自研）

# 二、测试记录

编号 | 日期 | 项目 | 操作 | 结果 | 结论
T-01 | 10-22 | 接线自检 10_selftest | 烧录后复位，观察串口与屏幕 | I2C 扫到 0x1E/0x5E；OLED(0x3C) 在线 ✔ | I2C 总线与 OLED 接线正确
T-02 | 10-22 | 温度采集 | 手捂探头观察读数变化 | 34.2 → 35.2℃ 连续变化 ✔ | DS18B20 单总线通信正常
T-03 | 10-22 | LED 专项 12_led | 三个相位各 2 秒 | 红、黄单独亮均正常；同时亮正常 | 两路 LED 与限流电阻接线正确
T-04 | 10-22 | ESP32 上电握手 | 烧 13_ui / 08_tcp 观察串口 | AT ✔ / CWMODE ✔ / CWSAP ✔ / CIPMUX ✔ / CIPSERVER ✔ | AT 固件与串口接线（PA2→GPIO6、PA3→GPIO7）正确
T-05 | 10-22 | 手机接入 | 手机连热点 502-Infusion 后打开 App | 串口打印「客户端 #0 已连接」，App 收到数据帧 | TCP 链路端到端打通
T-06 | 10-24 | 称重标定 11_calib | 空秤 KEY1 → 放 500ml 水 → KEY2×2 → KEY4 | ZERO=764832；SCALE=801.990 / 801.920 counts/g（两次偏差 0.009%） | 称重链路可用，重复性良好
T-07 | 10-24 | 称重复核 | 用 193 g 手机实测 | 读数 189.1 g，偏小 2.0% | 标定基准含容器重量，需砝码复标
T-08 | 10-24 | 四键功能 | K1/K2/K3/K4 逐项操作 | 切页、静音、进设置、加减、长按去皮均正常 | 按键扫描与消抖逻辑正确
T-09 | 10-27 | 称重 RAW 逐级排查 | 空秤 → 放50g → 取下 → 放100g，逐级读 OLED | 空秤 765400±100；+50g ≈ +37000；+100g ≈ +74100；回零偏差 200 counts（±0.27g） | 传感器与机械状态健康，线性度 0.14%
T-10 | 10-27 | 称重砝码标定 11_calib | 空秤 KEY1 → 放 100g（50+20+20+10）→ KEY4 | ZERO=765410；K=742.35 counts/g（三次复核一致）；修复显示 bug 后 W≈100.0g | 标定链路完整可用（含 hx711_set_offset 修复）
T-11 | 10-27 | 砝码五点复核 | 放 5g / 10g / 50g / 全五枚 105g 逐一读 W | 五点全部通过，最大偏差 ±0.1 g | 称重 ±2g 指标**达标**（余量 20 倍）
T-12 | 10-27 | 系数微调 | 复测显示少 0.1g → 742.35×0.999 | 系统系数 741.6，复测 100g 显示 ≈100.0 | ±0.1g 为 0.1g 分辨率最小一格，到噪声地板不再追调
T-13 | 10-27 | 整机 v2.1/v2.2 功能 | 复位观察开机提示/报警音/设置页/静音/去皮 | 开机滴滴两声+灯1.5s；报警3声短促哔；设置/设置2/静音/去皮正常 | v2.2 功能定稿
T-14 | 10-27 | 温度故障排除 | 温度时有时无 → 检查探头接线 | DS18B20 DQ 线接触不良，重插恢复；顺带 1-Wire 加关中断保护 | 硬件接触问题；软件已加固
T-15 | 10-27 | K3 修复确认 | 主页 K3 短按/长按（外部 AI 定位软件根因后） | 短按进参数设置、长按2秒进设置2，恢复正常 | key3_pressed 事件消费 bug 已修
T-16 | 10-27 | GitHub 推送 | Watt Toolkit 开启后 git push | 107c5eb..5a766ff 全部推送成功 | 远端与本地同步

# 三、称重标定实测数据

## 3.1 原始数据（串口实录）

[BOOT] 502 称重标定固件
[CAL] ★ ZERO = 764832
[CAL] 标定重量 → 200 g
[CAL] 标定重量 → 500 g
[KEY] KEY4 事件=2
[CAL] AVG = 1165827, CAL = 500 g
[CAL] SCALE = 801.990 counts/g
[KEY] KEY4 事件=2
[CAL] AVG = 1165792, CAL = 500 g
[CAL] SCALE = 801.920 counts/g

## 3.2 数据处理

项 | 数值 | 说明
零点 offset | 764832 | 空秤，20 次平均
加载后原始值 | 1165827 | 500 ml 水（含容器，约 510 g）
两次系数差 | 0.070 counts/g | 相对偏差 0.009%，重复性好
系统采用值 | 802.0 counts/g | 取中间值写入 hx711.h
复核（193 g 手机） | 189.1 g | 偏小 2.0%，与容器未计入吻合

偏差说明

误差来源已经定位：标定时把 500 ml 水当作 500 g，但容器本身约 10 g，

真实质量约 510 g，导致系数偏大 2%。

复标公式：新系数 = 旧系数 × (装置读数 ÷ 砝码真实重量)

## 3.3 复标（2026-10-27，标准砝码组）

项 | 数值 | 说明
零点 ZERO | 765410 | 空秤 KEY1，已喂给驱动
锚定点 | 100 g（50+20+20+10） | 五枚组合里杠杆最长、相对误差最小
实测系数 | 742.35 counts/g | KEY4 自动算出，三次复核一致
线性度 | 740.0 / 741.0 counts/g | 50g 与 100g 两点，偏差 0.14%
五点复核 | 5/10/50/105 g 全过，偏差 ≤±0.1 g | 指标 ±2 g，余量 20 倍
系统采用值 | 741.6 counts/g | 按复测 -0.1 g 微调（742.35×0.999）

复标说明

RAW 逐级实录（OLED 屏读）：空秤 765400±100 → 放 50g 约 802400（+37000）→

取下 765200（回零偏差 200 counts ≈ ±0.27g）→ 放 100g 约 839500（+74100）。

±0.1 g 已是 0.1g 显示分辨率的最小一格，到达噪声地板，不再追调。

★ 装盒/打板后机械结构改变，系数一定变化（10-24 水标 802 → 重装后 742 就是实证），必须重标。

# 四、测试中发现的问题与修复

以下问题均在实测中暴露并已修复，修复后重新编译验证（13 个固件 0 Error 0 Warning）。

问题 | 原因 | 修复
K4 完全无反应 | app502.c 的 key4_event() 未调用 key4_scan()，扫描从不执行 | 在 key4_event() 开头补 key4_scan()
OLED 显示「半个字」 | 每帧未清显存，切换界面后旧内容残留在未重写的页 | 三个绘制函数开头加 oled_clear()
红灯闪不到 2Hz | alert502_update() 只在每秒的采集块里调用，LED 翻转被限速 | 移到主循环每轮调用
11_calib 的 KEY2 无效 | key_any_just_pressed() 读后即清，同一循环调两次 | 只读一次存入变量再比较
KEY4 定系数无响应 | 只判 event==1（短按），按久了返回 2（长按）被丢弃 | 改为事件非 0 即接受，并打印事件码
开机重量显示 764.8 g | 上电时零点 offset=0，raw/scale 直接当重量 | 开机自动去皮（50 次平均）
串口助手打开即崩溃 | 脚本含 ✓ 字符，GBK 控制台无法编码 | 启动时把 stdout/stderr 重设为 UTF-8
标定屏 W 显示 1130 g（10-27） | 11_calib 自己算的零点没喂给驱动，hx711_grams 内 offset=0，W=raw/K | 新增 hx711_set_offset()，KEY1 后喂入
K1 面板「待机」显示成「机」（10-27） | 「待」不在 86 字字库字表里 | gen_cnfont.py 补「待/慢」重新生成（88 字）
K3 全无响应（10-27） | key3_pressed() 内部是消费型 key_get_event(3)，先调它把事件吃掉 | K3 只读一次存 e3 全篇复用（外部 AI 定位修复）
标定程序按键不灵敏（10-27） | 主循环阻塞等 HX711（约100ms）+ 每200ms整屏刷新 | 非阻塞就绪采样 + 逐页刷新
报警蜂鸣太吵（10-27） | 进入报警持续响 3 秒 | 改 3 声短促哔（120ms×3，AL_BEEP_COUNT 可配）
温度时有时无（10-27） | 探头 DQ 线接触不良（硬件）；1-Wire 无中断保护 | 重插探头线；ds18b20 start/read 全程关中断

# 五、尚未完成的测试项

项 | 当前状态 | 后续计划
滴速整机联调 | 红外已接入，开机自检+电平监测通过 | 整机跑滴速计数 + App 显示联调
称重 | ✅ 已达标 ±0.1g（2026-10-27 砝码标定） | 打板装盒后必须重标（机械状态改变会变系数）
PCB 打样 | 已布完线，DRC 0 错误 | 待打样后复测
云平台/小程序（C3） | 局域网 TCP 已稳 | 上云需切 report_mqtt.c（约 2~3 天），决策未定

502 输液状态监测装置 · 测试记录 v1.1 · 第 页
