Beiyiovo/stm32-infusion-monitor/文档/502网络标签总表.docx

502 · 网络标签总表（画原理图用）

不用拉线：同名网络标签自动连通。这里写清每个标签挂在哪几个脚上

v1.0 · 2026-10-22 · 配合《502原理图与PCB设计要点》使用

怎么用（30 秒）

在立创EDA 里：快捷键 N（或左侧工具栏"网络标签"）放置标签，输入名称即可。

两个脚挂同一个名字，就自动连在一起 —— 原理图上不用画长线，画出来也清爽。

3V3 与 GND 建议直接用"电源符号"（VCC/GND 符号），比网络标签更规范。

# 一、网络标签总表（19 条）

网络标签 | 类型 | 挂这个标签的所有引脚
3V3 | 电源 | STM32 右排第3、左排第20；OLED VCC；DS18B20 红线；蜂鸣器 VCC；HX711 VCC；红外 VCC；3 个 4.7kΩ 的一端
GND | 电源 | STM32 右排第1、第2、左排第19；OLED GND；DS18B20 黑线；蜂鸣器 GND；HX711 GND；红外 GND；红/黄 LED 负极；4 个按键的公共端；USB-TTL GND；ESP32 GND
I2C_SCL | 信号 | STM32 PB6（左排第14）；OLED SCL；4.7kΩ 一端
I2C_SDA | 信号 | STM32 PB7（左排第15）；OLED SDA；4.7kΩ 一端
DS_DQ | 信号 | STM32 PA0（右排第16）；DS18B20 黄线；4.7kΩ 一端
BUZZ | 信号 | STM32 PB0（右排第8）；蜂鸣器 I/O
LED_R | 信号 | STM32 PB1（右排第7）；220Ω 一端（另一端接红 LED 正极）
LED_Y | 信号 | STM32 PB5（左排第13）；220Ω 一端（另一端接黄 LED 正极）
KEY1 | 信号 | STM32 PA1（右排第15）；按键 1 一端
KEY2 | 信号 | STM32 PA4（右排第12）；按键 2 一端
KEY3 | 信号 | STM32 PA5（右排第11）；按键 3 一端
KEY4 | 信号 | STM32 PA6（右排第10）；按键 4 一端
HX_SCK | 信号 | STM32 PB10（右排第6）；HX711 SCK
HX_DT | 信号 | STM32 PB11（右排第5）；HX711 DT
IR_OUT | 信号 | STM32 PB12（左排第1）；红外模块 OUT
USART2_TX | 信号 | STM32 PA2（右排第14）；ESP32 GPIO6（模块 RX）
USART2_RX | 信号 | STM32 PA3（右排第13）；ESP32 GPIO7（模块 TX）
USART1_TX | 信号 | STM32 PA9（左排第6）；USB-TTL RXD
USART1_RX | 信号 | STM32 PA10（左排第7）；USB-TTL TXD

★ 交叉线怎么挂标签（最容易搞混的地方）

TX/RX 的命名规则：标签名按 STM32 这边看。

USART2_TX = STM32 发出去的线 → 所以它接的是 ESP32 的 GPIO6（模块的 RX）。

USART2_RX = STM32 接收的线 → 接 ESP32 的 GPIO7（模块的 TX）。

USB-TTL 同理：USART1_TX 接模块的 RXD，USART1_RX 接模块的 TXD。

# 二、STM32 每个脚挂什么标签（40 位）

序 | 位置 | 板丝印 | 芯片脚 | 网络标签 | 备注
1 | 右排 1 | GND | GND | GND
2 | 右排 2 | GND | GND | GND
3 | 右排 3 | 3V3 | 3V3 | 3V3
4 | 右排 4 | R | RESET | — | 不接
5 | 右排 5 | B11 | PB11 | HX_DT
6 | 右排 6 | B10 | PB10 | HX_SCK
7 | 右排 7 | B1 | PB1 | LED_R
8 | 右排 8 | B0 | PB0 | BUZZ
9 | 右排 9 | A7 | PA7 | — | 不接
10 | 右排 10 | A6 | PA6 | KEY4
11 | 右排 11 | A5 | PA5 | KEY3
12 | 右排 12 | A4 | PA4 | KEY2
13 | 右排 13 | A3 | PA3 | USART2_RX
14 | 右排 14 | A2 | PA2 | USART2_TX
15 | 右排 15 | A1 | PA1 | KEY1
16 | 右排 16 | A0 | PA0 | DS_DQ
17 | 右排 17 | C15 | PC15 | — | 不接
18 | 右排 18 | C14 | PC14 | — | 不接
19 | 右排 19 | C13 | PC13 | — | 板载 LED，不用
20 | 右排 20 | Vbt | VBAT | — | 不接
21 | 左排 1 | B12 | PB12 | IR_OUT
22 | 左排 2 | B13 | PB13 | — | 不接
23 | 左排 3 | B14 | PB14 | — | 不接
24 | 左排 4 | B15 | PB15 | — | 不接
25 | 左排 5 | A8 | PA8 | — | 不接
26 | 左排 6 | A9 | PA9 | USART1_TX
27 | 左排 7 | A10 | PA10 | USART1_RX
28 | 左排 8 | A11 | PA11 | — | 不接
29 | 左排 9 | A12 | PA12 | — | 不接
30 | 左排 10 | A15 | PA15 | — | 不接
31 | 左排 11 | B3 | PB3 | — | 不接（JTAG）
32 | 左排 12 | B4 | PB4 | — | 不接（JTAG）
33 | 左排 13 | B5 | PB5 | LED_Y
34 | 左排 14 | B6 | PB6 | I2C_SCL
35 | 左排 15 | B7 | PB7 | I2C_SDA
36 | 左排 16 | B8 | PB8 | — | 不接
37 | 左排 17 | B9 | PB9 | — | 不接
38 | 左排 18 | 5V | 5V | — | ★ 绝对不接
39 | 左排 19 | GND | GND | GND
40 | 左排 20 | 3V3 | 3V3 | 3V3

# 三、各模块那一头挂什么标签

模块 | 模块引脚 | 网络标签
OLED | VCC | 3V3
OLED | GND | GND
OLED | SCL | I2C_SCL
OLED | SDA | I2C_SDA
DS18B20 | 红线 | 3V3
DS18B20 | 黑线 | GND
DS18B20 | 黄线 | DS_DQ
蜂鸣器 | VCC | 3V3
蜂鸣器 | GND | GND
蜂鸣器 | I/O | BUZZ
按键 1 | 一端 | KEY1
按键 2 | 一端 | KEY2
按键 3 | 一端 | KEY3
按键 4 | 一端 | KEY4
按键 1~4 | 另一端 | GND
红 LED | 正极（经 220Ω） | LED_R
红 LED | 负极 | GND
黄 LED | 正极（经 220Ω） | LED_Y
黄 LED | 负极 | GND
HX711 | VCC | 3V3
HX711 | GND | GND
HX711 | SCK | HX_SCK
HX711 | DT | HX_DT
称重传感器 | 红 E+ | 接 HX711 的 E+
称重传感器 | 黑 E− | 接 HX711 的 E−
称重传感器 | 白 A+ | 接 HX711 的 A+
称重传感器 | 绿 A− | 接 HX711 的 A−
红外模块 | VCC | 3V3
红外模块 | GND | GND
红外模块 | OUT | IR_OUT
ESP32-C3 | GPIO6（RX） | USART2_TX
ESP32-C3 | GPIO7（TX） | USART2_RX
ESP32-C3 | GND | GND
ESP32-C3 | 电源脚 | ★ 不接，自己走 Type-C
USB-TTL | RXD | USART1_TX
USB-TTL | TXD | USART1_RX
USB-TTL | GND | GND
USB-TTL | VCC | ★ 不接

# 四、画原理图的顺序建议

- ① 先把 5 个模块的排母符号摆出来（STM32 2×1×20P、ESP32 2×1×16P、OLED 1×4P、HX711 1×4P×2、红外 1×3P、蜂鸣器 1×3P）
- ② 给每个要用的脚挂网络标签（照第二节、第三节）
- ③ 放 5 个电阻（3 个 4.7kΩ、2 个 220Ω），两端也挂对应标签
- ④ 放电源符号：3V3 与 GND
- ⑤ 检查：原理图的网络统计里，每个标签的节点数应与第一节一致

画完怎么自检

第一节的"挂这个标签的所有引脚"就是**节点数**。画完在立创EDA 里点某个标签看它连了几个脚，

对不上就说明漏挂了。这是最快查出漏接的方法。
