Beiyiovo/stm32-infusion-monitor/文档/502_STM32逐脚接线顺序表.docx

502 · STM32 逐脚接线顺序表

按实物板丝印：右排 20 个从上到下 → 左排 20 个从上到下（共 40 位）

v2 · 2026-10-22 · 已按用户实测丝印更正（v1 漏了 R、整体错位一格）

实物板丝印顺序（先对一遍）

这块板的实际顺序（用户 2026-10-22 核对）：

右排：GND GND 3V3 R B11 B10 B1 B0 A7 A6 A5 A4 A3 A2 A1 A0 C15 C14 C13 Vbt

左排：B12 B13 B14 B15 A8 A9 A10 A11 A12 A15 B3 B4 B5 B6 B7 B8 B9 5V GND 3V3

★ 注意：这里第 4 位是 R（复位）、最后一位是 Vbt（电池），网上很多图没有这两个，别照抄。

接的时候按丝印找（B1、A0 这种字），不要按位置数错。

# 一、按顺序接线（40 个位置）

序 | 位置 | 板丝印 | 芯片脚 | 接什么 | 必接?
1 | 右排 第 1 个 | GND | GND | 面包板负极轨（公共地） | 必接
2 | 右排 第 2 个 | GND | GND | 面包板负极轨（和上一根接同一条） | 必接
3 | 右排 第 3 个 | 3V3 | 3V3 | 面包板正极轨（全系统电源） | 必接
4 | 右排 第 4 个 | R | RESET | 不接（板上有复位按键） | 不接
5 | 右排 第 5 个 | B11 | PB11 | HX711 的 DT（DOUT） | 必接
6 | 右排 第 6 个 | B10 | PB10 | HX711 的 SCK | 必接
7 | 右排 第 7 个 | B1 | PB1 | 红 LED 正极（中间串 220Ω），负极接 GND | 必接
8 | 右排 第 8 个 | B0 | PB0 | 蜂鸣器模块的 I/O（低电平响） | 必接
9 | 右排 第 9 个 | A7 | PA7 | 不接（悬空） | 不接
10 | 右排 第 10 个 | A6 | PA6 | 按键 4 的一端（另一端接 GND） | 必接
11 | 右排 第 11 个 | A5 | PA5 | 按键 3 的一端（另一端接 GND） | 必接
12 | 右排 第 12 个 | A4 | PA4 | 按键 2 的一端（另一端接 GND） | 必接
13 | 右排 第 13 个 | A3 | PA3 | ESP32 的 GPIO7（模块 TX）★ 交叉 | 必接
14 | 右排 第 14 个 | A2 | PA2 | ESP32 的 GPIO6（模块 RX）★ 交叉 | 必接
15 | 右排 第 15 个 | A1 | PA1 | 按键 1 的一端（另一端接 GND） | 必接
16 | 右排 第 16 个 | A0 | PA0 | DS18B20 黄线（并 4.7kΩ 到 3V3） | 必接
17 | 右排 第 17 个 | C15 | PC15 | 不接（板上接 32.768k 晶振） | 不接
18 | 右排 第 18 个 | C14 | PC14 | 不接（同上） | 不接
19 | 右排 第 19 个 | C13 | PC13 | 不接（板载 LED，板上已焊） | 不用
20 | 右排 第 20 个 | Vbt | VBAT | 不接（电池备份脚） | 不接
21 | 左排 第 1 个 | B12 | PB12 | 红外计数模块的 OUT | 必接
22 | 左排 第 2 个 | B13 | PB13 | 不接 | 不接
23 | 左排 第 3 个 | B14 | PB14 | 不接 | 不接
24 | 左排 第 4 个 | B15 | PB15 | 不接 | 不接
25 | 左排 第 5 个 | A8 | PA8 | 不接 | 不接
26 | 左排 第 6 个 | A9 | PA9 | USB-TTL 的 RXD ★ 交叉 | 必接
27 | 左排 第 7 个 | A10 | PA10 | USB-TTL 的 TXD ★ 交叉 | 必接
28 | 左排 第 8 个 | A11 | PA11 | 不接（USB D−） | 不接
29 | 左排 第 9 个 | A12 | PA12 | 不接（USB D+） | 不接
30 | 左排 第 10 个 | A15 | PA15 | 不接 | 不接
31 | 左排 第 11 个 | B3 | PB3 | 不接（JTAG 的 JTDO，被占用） | 不接
32 | 左排 第 12 个 | B4 | PB4 | 不接（JTAG 的 JNTRST，被占用） | 不接
33 | 左排 第 13 个 | B5 | PB5 | 黄 LED 正极（中间串 220Ω），负极接 GND | 必接
34 | 左排 第 14 个 | B6 | PB6 | OLED 的 SCL（并 4.7kΩ 到 3V3） | 必接
35 | 左排 第 15 个 | B7 | PB7 | OLED 的 SDA（并 4.7kΩ 到 3V3） | 必接
36 | 左排 第 16 个 | B8 | PB8 | 不接 | 不接
37 | 左排 第 17 个 | B9 | PB9 | 不接 | 不接
38 | 左排 第 18 个 | 5V | 5V | ★ 绝对不接！板子已由 Micro USB 供电 | 不接
39 | 左排 第 19 个 | GND | GND | 面包板负极轨 | 必接
40 | 左排 第 20 个 | 3V3 | 3V3 | 面包板正极轨（与右排第 3 个同一条） | 必接

# 二、底部独立的 SWD 小排针（4 针）

板子底部中间还有一个 4 针小排针，是 SWD 调试口，本项目全部不接（我们用串口 ISP 烧录）。

丝印 | 位置 | 怎么处理
3V3 | SWD 小排针 | 不接
SWDIO（PA13） | SWD 小排针 | 不接（留给 ST-Link / 调试）
SWCLK（PA14） | SWD 小排针 | 不接
GND | SWD 小排针 | 不接

# 三、三个最容易接错的地方

脚 | 有几处 | 在哪 | 注意
GND | 3 处 | 右排第 1、2 个 + 左排第 19 个 | 三个都要接到负极轨
3V3 | 2 处 | 右排第 3 个 + 左排第 20 个 | 两处都接正极轨（内部连通）
5V | 1 处 | 左排第 18 个 | ★ 绝对不接，会和 Micro USB 供电打架

★ 这三条看错会烧板子

① 5V（左排第 18 个）绝对不要接线。板子已经由 Micro USB 供电。

② GND 有三处（右排 1、2 与左排 19），全部接到负极轨。

③ 3V3 有两处（右排 3 与左排 20），都接正极轨。

# 四、接完这 40 个位置，模块那端怎么接

- OLED：VCC→3V3、GND→GND、SCL→B6、SDA→B7；SCL/SDA 各要一个 4.7kΩ 到 3V3
- DS18B20：红→3V3、黑→GND、黄→A0；DQ 要一个 4.7kΩ 到 3V3
- 蜂鸣器：VCC→3V3（不是 5V）、GND→GND、I/O→B0
- 按键 ×4：一端→A1/A4/A5/A6，另一端→GND
- LED ×2：正极经 220Ω → B1（红）/ B5（黄），负极→GND
- HX711：VCC→3V3、GND→GND、SCK→B10、DT→B11；传感器 4 线接 E+/E−/A+/A−
- 红外模块：VCC→3V3、GND→GND、OUT→B12
- ESP32：GPIO6←A2、GPIO7→A3、GND↔GND；电源自己走 Type-C
- USB-TTL：RXD←A9、TXD→A10、GND→GND；VCC 不接

这版改了什么

v1 的错误：我按网上常见的 Blue Pill 引脚图排，把 B1 当成第 4 个，漏掉了 R，

导致第 4 位以后整体错一格、Vbt 也没列。v2 已按实物丝印逐个核对。

以后凡是"位置/顺序"类信息，以你板子上的丝印为准，我不再凭常见图推断。

502 STM32 逐脚接线顺序表 v2 · 第 页
