Beiyiovo/stm32-infusion-monitor/文档/502逐器件接线总表.docx

502 逐器件接线总表（全引脚版）

每个元器件单独一节：它的每一个脚接哪里、哪些不用接、哪些绝对不能接

v1.0 · 2026-10-22 · 按此表逐个接，接完在"必接"列打勾

先读这四句

① 用法：从第一节 STM32 开始，一个器件一节，接完一个再接下个。每节最后都有核对项。

② 表里"必接"= 不接就不工作；"不接"= 明确不要接（接了可能烧）；"—"= 无所谓。

③ 所有 3V3 都从面包板正极轨取、所有 GND 都从负极轨取，不要一个模块一个来源。

④ 本表完全沿用项目1 已验证的接法（I2C 上拉、蜂鸣器 3V3、ESP32 独立供电），

只有 HX711 与红外模块是本项目新增、尚未上板验证。

# 一、STM32F103C8T6（主控）—— 全部 40 个脚

板上排针旁的丝印是 A0/B6 这种简写，对应芯片的 PA0/PB6。按丝印找脚，别按位置数。

芯片脚 | 板丝印 | 用途 | 接到 | 必接?
PA0 | A0 | ★ 温度数据 DQ | DS18B20 黄线（中间加 4.7kΩ 到 3V3） | 必接
PA1 | A1 | KEY1 设置 | 按键 1 的一端（另一端接 GND） | 必接
PA2 | A2 | USART2_TX | ESP32 的 GPIO6（RX）★ 交叉 | 必接
PA3 | A3 | USART2_RX | ESP32 的 GPIO7（TX）★ 交叉 | 必接
PA4 | A4 | KEY2 加 | 按键 2 的一端（另一端接 GND） | 必接
PA5 | A5 | KEY3 减 | 按键 3 的一端（另一端接 GND） | 必接
PA6 | A6 | KEY4 确认/去皮 | 按键 4 的一端（另一端接 GND） | 必接
PA7 | A7 | 空闲 | 不接 | —
PA8 | A8 | 空闲 | 不接 | —
PA9 | A9 | USART1_TX | USB-TTL 的 RXD ★ 交叉 | 必接
PA10 | A10 | USART1_RX | USB-TTL 的 TXD ★ 交叉 | 必接
PA11 | A11 | 空闲（USB D−） | 不接 | —
PA12 | A12 | 空闲（USB D+） | 不接 | —
PA13 | — | SWDIO | 在板上独立的 4 针 SWD 小排针上，不接 | 不接
PA14 | — | SWCLK | 同上，不接 | 不接
PA15 | A15 | 空闲（JTDI） | 不接 | —
PB0 | B0 | ★ 蜂鸣器 | 蜂鸣器模块的 I/O（低电平响） | 必接
PB1 | B1 | ★ 红 LED | 红 LED 正极经 220Ω（负极接 GND） | 必接
PB2 | B2 | BOOT1 | 不接（板上有跳线） | 不接
PB3 | B3 | 空闲（JTDO） | 不接，★ 不要用 | —
PB4 | B4 | 空闲（JNTRST） | 不接，★ 不要用 | —
PB5 | B5 | ★ 黄 LED | 黄 LED 正极经 220Ω（负极接 GND） | 必接
PB6 | B6 | ★ I2C_SCL | OLED 的 SCL（中间接 4.7kΩ 到 3V3） | 必接
PB7 | B7 | ★ I2C_SDA | OLED 的 SDA（中间接 4.7kΩ 到 3V3） | 必接
PB8 | B8 | 空闲 | 不接 | —
PB9 | B9 | 空闲 | 不接 | —
PB10 | B10 | ★ HX711 SCK | HX711 的 SCK | 必接
PB11 | B11 | ★ HX711 DT | HX711 的 DT / DOUT | 必接
PB12 | B12 | ★ 红外 OUT | 红外计数模块的 OUT | 必接
PB13 | B13 | 空闲 | 不接 | —
PB14 | B14 | 空闲 | 不接 | —
PB15 | B15 | 空闲 | 不接 | —
PC13 | C13 | 板载 LED | 板上自带，不用外接 | 不用
PC14 | C14 | 晶振脚 | 板上已接 32.768kHz 晶振，不接 | 不接
PC15 | C15 | 晶振脚 | 同上，不接 | 不接

## STM32 的电源与特殊脚

丝印 | 芯片脚 | 用途 | 接到 | 必接?
3V3 | 3V3 | ★ 整个系统的电源输出 | 接面包板正极轨，所有模块 VCC 都从这取 | 必接
GND | GND | ★ 公共地 | 接面包板负极轨 | 必接
GND | GND | ★ 第二根地（板上有两根） | 同上，接到同一条负极轨 | 必接
5V | 5V | ★ 不要接任何东西 | 板子自己由 Micro USB 供电，5V 脚不外供 | 不接
VBAT | VB | 电池备份 | 不接 | 不接
R | R | 复位 | 不接（板上已有复位键） | 不接

STM32 三个容易接错的地方

★ 千万注意：5V 脚只进不出，不要把 5V 接到任何 IO 上。

★ PA13/PA14 在板上是独立的 4 针 SWD 小排针，不在 40 针排母上 —— 找的时候别找错。

★ PB3/PB4 默认被 JTAG 占用，本方案避开不用。

# 二、0.96 寸 OLED（I2C，4 针）

4 个脚全用。VCC 接 3V3；两条信号线各要一个 4.7kΩ 上拉。

引脚（按丝印） | 接到 | 必接? | 说明 / 坑
VCC | 3V3 | 必接 | ★ 不能接 5V
GND | GND | 必接 | —
SCL | PB6 | 必接 | ★ 这条线上要有 4.7kΩ 到 3V3
SDA | PB7 | 必接 | ★ 这条线上要有 4.7kΩ 到 3V3

# 三、DS18B20 温度探头（3 线）

防水探头三根线：红=电源、黑=地、黄=数据。

引脚（按丝印） | 接到 | 必接? | 说明 / 坑
红线 VDD | 3V3 | 必接 | —
黑线 GND | GND | 必接 | —
黄线 DQ | PA0 | 必接 | ★ 黄线与 3V3 之间加 4.7kΩ
（屏蔽层/多余线） | 不接 | — | 若探头带屏蔽网，悬空即可

# 四、有源蜂鸣器模块（3 针）

★ 这是项目1 踩过的坑：VCC 接 3V3，不是 5V。

引脚（按丝印） | 接到 | 必接? | 说明 / 坑
VCC | 3V3 | 必接 | ★★ 项目1 实测：接 5V 时 S8550 PNP 关不断，会一直响
GND | GND | 必接 | —
I/O（有的丝印 SIG） | PB0 | 必接 | 低电平触发

# 五、轻触按键 ×4

每个按键两个脚，一个接 GPIO，另一个接 GND。

引脚（按丝印） | 接到 | 必接? | 说明 / 坑
按键 1 一端 | PA1 | 必接 | 另一端 → GND
按键 2 一端 | PA4 | 必接 | 另一端 → GND
按键 3 一端 | PA5 | 必接 | 另一端 → GND
按键 4 一端 | PA6 | 必接 | 另一端 → GND
4 个按键的另一端 | GND | 必接 | 可以共用一条地线
（不需要外部上拉） | — | — | STM32 内部 40kΩ 上拉已够（项目1 实测）

# 六、红色 / 黄色 LED

长脚是正极，短脚是负极；正极必须串 220Ω。

引脚（按丝印） | 接到 | 必接? | 说明 / 坑
红 LED 长脚（+） | PB1 经 220Ω | 必接 | ★ 必须串电阻
红 LED 短脚（−） | GND | 必接 | —
黄 LED 长脚（+） | PB5 经 220Ω | 必接 | ★ 必须串电阻
黄 LED 短脚（−） | GND | 必接 | —

# 七、HX711 模块（MCU 侧 4 针）

用 3.3V 供电，DT 接 PB11、SCK 接 PB10。

引脚（按丝印） | 接到 | 必接? | 说明 / 坑
VCC | 3V3 | 必接 | ★ 用 3.3V，DOUT 电平天然匹配
GND | GND | 必接 | 必须共地
DT（有的丝印 DOUT） | PB11 | 必接 | 数据，代码带超时
SCK | PB10 | 必接 | 时钟

# 八、称重传感器（1kg 悬臂梁，4 线）

四根线接 HX711 的 E+/E−/A+/A−，不直接接 STM32。

引脚（按丝印） | 接到 | 必接? | 说明 / 坑
红线 E+ | HX711 的 E+ | 必接 | ★ 颜色以传感器说明为准
黑线 E− | HX711 的 E− | 必接 | —
白线 A+ | HX711 的 A+ | 必接 | ★ 若加负载读数变负 → 交换 A+/A−
绿线 A− | HX711 的 A− | 必接 | —

# 九、红外计数模块（15mm 槽型，3 针）

VCC/GND/OUT 三根，OUT 接 PB12。

引脚（按丝印） | 接到 | 必接? | 说明 / 坑
VCC | 3V3 | 必接 | 模块标 3.3~5V；本项目用 3.3V
GND | GND | 必接 | —
OUT（有的标 DO） | PB12 | 必接 | 若模块是开漏输出且板上无上拉，加 10kΩ 到 3V3
（AO 脚，如果有） | 不接 | — | 模拟输出不用

# 十、ESP32-C3 核心板

★ 只接 3 根线（GPIO6 / GPIO7 / GND），电源自己走 Type-C。

引脚（按丝印） | 接到 | 必接? | 说明 / 坑
GPIO6（模块 RX） | PA2 | 必接 | ★ 交叉：STM32 的 TX 接模块的 RX
GPIO7（模块 TX） | PA3 | 必接 | ★ 交叉：STM32 的 RX 接模块的 TX
GND | GND | 必接 | ★ 必须共地，否则收不到数据
5V / 3V3（模块电源脚） | ★ 不接主板 | 不接 | 自己用 Type-C 接 5V 适配器
其余 GPIO | 不接 | — | 全部悬空

# 十一、USB-TTL（CH340）

只接 3 根（TXD / RXD / GND），VCC 不接。

引脚（按丝印） | 接到 | 必接? | 说明 / 坑
TXD | PA10 | 必接 | ★ 交叉：模块 TX → STM32 RX
RXD | PA9 | 必接 | ★ 交叉：模块 RX → STM32 TX
GND | GND | 必接 | 不接会乱码
3V3 / VCC | 不接 | 不接 | ★ 双电源顶牛会烧

# 十二、电源（一共两套）

引脚（按丝印） | 接到 | 必接? | 说明 / 坑
5V 适配器 A | STM32 的 Micro USB 口 | 必接 | 全系统 3V3 的唯一来源
3V3 排针 | 面包板正极轨 | 必接 | 所有模块 VCC 从这里取
GND 排针 | 面包板负极轨 | 必接 | 所有模块 GND 到这里
5V 适配器 B | ESP32-C3 的 Type-C 口 | 必接 | 独立供电，只与主板共地

# 十三、电阻电容：一共 5~6 个，全部列清楚

元件 | 数量 | 装在哪两个点之间 | 作用
4.7kΩ | 1 | OLED 的 SCL —— 3V3 | I2C 上拉（★ 必须有）
4.7kΩ | 1 | OLED 的 SDA —— 3V3 | I2C 上拉（★ 必须有）
4.7kΩ | 1 | DS18B20 的 DQ —— 3V3 | 单总线上拉（★ 必须有）
220Ω | 1 | PB1 —— 红 LED 正极 | 限流
220Ω | 1 | PB5 —— 黄 LED 正极 | 限流
10kΩ | 1（备用） | 红外 OUT —— 3V3 | 只有模块开漏且无上拉时才装
100µF | 1（可选） | 3V3 —— GND | 去耦，抗蜂鸣器/ESP32 干扰

# 十四、哪些是项目1 验证过的、哪些是新加的

结论 | 依据 | 要求
I2C 必须加 4.7kΩ 上拉 | 项目1 实测：缺上拉时屏幕全黑，加后正常 | ★ 必做
蜂鸣器 VCC 必须 3.3V | 项目1 实测：接 5V 时 S8550 PNP 关不断，一直响 | ★ 必做
ESP32 独立供电、只共地 | 项目1 实测：接主板 3V3 会掉压重启（WiFi 尖峰 350mA） | ★ 必做
按键不需要外部上拉 | 项目1 实测：内部 40kΩ 上拉够用 | 可省
I2C 用软件模拟、约 25kHz | 项目1 实测：硬件 I2C 扫不到设备；软件 I2C 放慢后正常 0x3C | ★ 已写进代码
烧录用 9600 波特率 | 项目1 实测：115200 从未成功 | ★ 记住
DS18B20 要 4.7kΩ 上拉 | datasheet 要求；项目1 按此接法可用 | ★ 必做
HX711 用 3.3V 供电 | 本项目新增，未在项目1 验证过 | ⚠ 待实测
红外模块 3.3V 供电 | 本项目新增，未验证；若不灵敏可试 5V（OUT 需确认电平） | ⚠ 待实测

一句话：能用现成结论的，绝不重新试错

上面标 ★ 的 6 条，都是项目1 在真实硬件上踩出来的结论，本项目原样照搬，不重新发明。

标 ⚠ 的 2 条（HX711、红外模块）没有上板验证过，到货后按《面包板接线与通电验收单》先验。

# 十五、接线顺序（照这个来，别一次全插）

- ① 3V3 与 GND 引到面包板两条电源轨 → 万用表量 3.2~3.4V
- ② USB-TTL（PA9/PA10/GND）→ 烧 01_uart 看心跳
- ③ OLED + 两个 4.7kΩ → 烧 02_oled，屏亮
- ④ DS18B20 + 4.7kΩ → 烧 03_ds18b20，温度正常
- ⑤ 4 个按键 → 烧 04_key，四键都有反应
- ⑥ 蜂鸣器 + 两个 LED（含 220Ω）→ 烧 05_alert，声光对
- ⑦ 红外模块 → 烧 07_drop，挡 20 次 = 20 滴
- ⑧ ESP32（3 根线）→ 烧 08_tcp，AT 全 OK
- ⑨ HX711 + 传感器（到货后）→ 烧 06_hx711 / 11_calib 标定
