Beiyiovo/stm32-infusion-monitor/文档/面包板接线与通电验收单.docx

502 面包板接线与通电验收单

照着接、接完就量、量完再上电 —— 每一步都有判据

v1.0 · 2026-10-22 · 适用：手头已有 STM32/OLED/DS18B20/蜂鸣器/LED/按键/ESP32

先读这三句

① 现在的物料缺口：**称重传感器 + 砝码还没到** → 今天可以接完除 HX711 以外的全部电路，

并跑通 01~05、07 六个固件。HX711（06）与整机（09）等传感器到了再验。

② 每接完一个模块，**先断电再动线**，上电前用万用表量一次 3V3 与 GND 不短路。

③ 判据写死的部分不要"差不多就行"——面包板接触不良是最常见的假故障。

# 一、今天要用的东西

类别 | 清单 | 数量 | 备注
主控 | STM32F103C8T6 最小系统板 | 1 块 | ★ 无板载 CH340，烧录靠 USB-TTL
显示 | 0.96 寸 OLED（I2C 4 针） | 1 个 | 新买的
温度 | DS18B20 防水探头 | 1 个 | 项目1 剩的第 2 个
报警 | 有源蜂鸣器模块 + 红/黄 LED | 各 1~2 | 蜂鸣器 VCC 必须 3V3
输入 | 轻触按键 | 4 个 | 内部上拉，另一端接 GND
无线 | ESP32-C3 核心板 | 1 块 | 烧 AT 固件后才能用
滴速 | 红外对射模块（带比较器小板） | 1 套 | ★ 本文第三节重点
基础 | 面包板 830 / 杜邦线 / 4.7kΩ×3 / 220Ω×2 | — | 上拉与限流
工具 | USB-TTL（CH340）+ 万用表 | 各 1 | 烧录与量电压
缺 | 称重传感器 + HX711 + 砝码 | — | 未到，今天跳过

# 二、接线顺序（★ 一定按这个顺序，别一次全插上去）

原则：先把"电源轨"立起来并量准，再一个模块一个模块加。每加一个就上电验一次，出问题立刻知道是谁。

步 | 接什么 | 接到哪 | 接完立刻自检
1 | 两条电源轨 | STM32 的 3V3 排针 → 面包板红线（正极轨）；GND → 蓝线（负极轨） | 万用表量：红蓝之间 3.2~3.4V；电阻档量不短路
2 | USB-TTL 调试口 | TXD→PA10，RXD→PA9，GND→GND（VCC 不接） | 烧 `01_uart`，串口 115200 能看到 "[RUN] 第 N 次心跳"
3 | OLED + 上拉 | VCC→3V3，GND→GND，SCL→PB6，SDA→PB7；SCL、SDA 各经 4.7kΩ 到 3V3 | 烧 `02_oled`，屏亮并显示「输液监测」
4 | DS18B20 + 上拉 | 红→3V3，黑→GND，黄(DQ)→PA0；DQ 经 4.7kΩ 到 3V3 | 烧 `03_ds18b20`，串口打印室温，不是 85℃
5 | 4 个按键 | PA1/PA4/PA5/PA6 各接一键，另一端全部接到 GND 轨 | 烧 `04_key`，按哪个键串口打哪个号
6 | 蜂鸣器 + 红/黄 LED | 蜂鸣器 VCC→3V3，GND→GND，I/O→PB0；红 LED 串 220Ω 到 PB1，黄 LED 串 220Ω 到 PB5 | 烧 `05_alert`，KEY1 切工况看灯与响声
7 | 红外对射（滴速） | 模块 VCC→3V3，GND→GND，DO→PB12（详见第三节） | 烧 `07_drop`，手挡一次计数 +1
8 | ESP32-C3 链路 | PA2→GPIO6，PA3→GPIO7，GND↔GND；ESP32 自己 Type-C 供电 | 烧 `08_tcp`，串口依次出现 AT/CWMODE/CWSAP/CIPMUX/CIPSERVER 全 OK
9 | HX711（等传感器到） | VCC→3V3，GND→GND，SCK→PB10，DT→PB11 | 烧 `06_hx711`，读数随按压变化

# 三、★ 滴速（红外对射）专项 —— 这是最容易翻车的一块

## 3.1 先说清楚：这套东西到底行不行

可行，而且这就是商用输液监测仪的做法：一对红外发射/接收管横跨滴壶，液滴落下时遮断光路，接收端输出翻转一次，计一次数。前提是三个条件同时满足：光路对准、遮光到位、壶体是透明塑料。

条件 | 为什么必须满足 | 不满足会怎样
两头正对、间距 15~25mm | 滴壶直径约 20mm，光路要横穿壶体 | 光打不到接收头 → 永远不翻转
夹在滴嘴与液面之间 | 只有这一段才有"离散的滴" | 夹在壶下方的软管上 → 那里是连续液柱，数不到
遮光罩包住两侧 | 环境光/日光灯会让接收管误判 | 数值乱跳，滴速虚高

## 3.2 三种可能的来料，接法不一样

你买到的形态 | 长什么样 | 怎么接
A. 带比较器小板（最常见） | 一块小 PCB，上有 VCC/GND/DO/AO 四个针，两个头（发射/接收）用线连到板上 | 板 VCC→3V3，GND→GND，**DO→PB12**；两个头插到板上的对应插座
B. 两个裸头（3 针） | 发射头 2 针、接收头 3 针（VCC/GND/OUT），没有小板 | 接收头 OUT 需经 10kΩ 上拉到 3V3 再进 PB12；发射头串 220Ω 限流
C. 反射式（单板，一个头） | 一个板上有发射+接收，靠反射检测（E18-D80NK 这类） | ★ 不适合：滴壶是透明的，反射式基本检不到液滴，建议换 A

## 3.3 接完怎么验（不看代码，先用万用表）

步 | 做什么 | 应该看到 | 不对怎么办
1 | 手机摄像头对准发射头（人眼看不见红外） | 屏幕上有一个紫白色亮点 | 没亮点 = 发射头没供电或坏了
2 | 万用表直流档量接收头 OUT 对 GND | 无遮挡时是一个稳定值（约 0V 或 3.3V） | 在 1~2V 之间飘 = 没比较器，见形态 B
3 | 用手在光路中挡一下，再放开 | OUT 在两种电平之间明确跳变 | 不跳 = 光路没对准 / 距离太远
4 | 手电筒直射接收头 | 加了遮光罩后 OUT 不应乱跳 | 乱跳 = 遮光不够，包黑胶布
5 | 烧 `07_drop`，手挡 20 次 | 串口累计 = 20 | 多计 = 抖动/干扰；少计 = 遮挡太短或中断没进

三条必须知道的实话

① 有效电平要先量出来再写死：有的模块遮光输出低，有的输出高，代码里按实测改 `drop.c` 的触发沿。

② 液滴"成线"（流速很快）时物理上没有离散滴，任何光学方法都数不到 —— 报告里如实写适用区间。

③ **兜底方案**：滴速还能由重量反推（每分钟减少的克数 ÷ 每滴克数）。本项目称重精度 ±2g，单滴约 0.05g，所以重量法只能算"分钟级平均"，不能算单滴；两条独立途径互为校验，答辩时是加分项。

# 四、上电前静态检查（每次改完线都做，2 分钟）

# | 检查项 | 怎么量 | 判据

1 | 3V3 与 GND 不短路 | 电阻档，量红蓝两轨 | 不为 0Ω
2 | 所有 GND 连通 | 通断档，逐段量 | 全部导通
3 | I2C 两条上拉在位 | 电阻档量 3V3 到 SCL / SDA | 各约 4.7kΩ
4 | DS18B20 上拉在位 | 量 3V3 到 PA0 | 约 4.7kΩ
5 | 蜂鸣器接的是 3V3 | 目视 + 量电压 | 3.2~3.4V，不是 5V
6 | ESP32 的电源不来自主板 | 通断档量主板 3V3 与 ESP32 VCC | 不通
7 | 按键另一端接的是 GND | 通断档 | 按下时 GPIO 对 GND 导通

# 五、通电后按这个顺序跑（每个固件对应一个模块）

代码\build.bat 01_uart → 串口有心跳 → 电源/调试口 OK
代码\build.bat 02_oled → 屏幕亮 → I2C/上拉 OK
代码\build.bat 03_ds18b20 → 室温读数合理 → 单总线 OK
代码\build.bat 04_key → 4 个键都有响应 → 按键 OK
代码\build.bat 05_alert → 黄/红/蜂鸣器对得上 → 告警逻辑 OK
代码\build.bat 07_drop → 挡 20 次 = 20 滴 → 滴速硬件 OK
代码\build.bat 08_tcp → AT 全 OK + 手机连上 → 网络 OK
（06_hx711 / 09_main 等称重传感器到了再跑）

烧录参数（很重要）

烧录用串口 ISP：BOOT0 拨到 1 → 复位 → 9600 波特率烧 → BOOT0 拨回 0 → 复位。

★ 这块板实测 115200 从来没烧成功过，别试。

# 六、常见故障对照

现象 | 最可能原因 | 先查什么
串口全是乱码 | 波特率不对 / USB-TTL 没共地 | 先 9600 再 115200；确认 GND
OLED 全黑 | 缺 4.7kΩ 上拉 / SDA SCL 接反 | 量上拉；交换 SDA/SCL
DS18B20 读 85℃ | 上拉缺失 / DQ 没接上 | 量 PA0 到 3V3 的电阻
按键不灵 | 另一端接到 3V3 了（应接 GND） | 万用表通断
蜂鸣器一直响 | VCC 接了 5V | 改接 3V3
滴速不动 | 光路没对准 / 发射头没亮 | 手机摄像头看发射头
滴速乱跳 | 遮光不足 / 电源噪声 | 包黑胶布，3V3 并联 100µF
AT 无回应 | PA2/PA3 没交叉 / 没共地 | 量通断，确认 GPIO6/7

# 七、今天的记录（手填）

模块 | 固件 | 结果（通过/不通过） | 现象/数据 | 时间
电源 + 串口 | 01_uart
OLED | 02_oled
DS18B20 | 03_ds18b20
按键 | 04_key
告警 | 05_alert
滴速 | 07_drop
ESP32 | 08_tcp
