Beiyiovo/stm32-infusion-monitor/文档/502可行性验证方案.docx

502 输液状态 WiFi 监测装置 · 可行性验证方案

8 个阶段 · 每阶段先定判据再动手 · 不达标就停，不许改数据

版本 v1.0 · 2026-10-21 · 适用：面包板阶段到成品验收

这份方案怎么用（先读这 4 句）

① 这份方案只为回答 4 个「还不知道」的问题，不是流程表演：

温度能不能做到 ±0.5℃？　称重能不能做到 ±2g？

STM32 手拼 HTTP 能不能稳定出网页？　两级报警与阈值设置能不能满足课题？

② 每个阶段都写明「判据」。判据没达到，下一个阶段不许开始 —— 否则后面所有数据都不可信。

③ 全文没有"预计达标"这种话。达标与否只由实测数据决定，结论只有：已达成 / 部分达成 / 未达成。

# 零、四个未知数与对应的验证阶段

未知数 | 为什么不确定 | 由哪个阶段回答
温度 ±0.5℃ | DS18B20 datasheet 规格就是 ±0.5℃，等于指标本身，没有余量 | 阶段 4
称重 ±2g | 受传感器线性度/迟滞、HX711 噪声、挂具去皮三者叠加影响 | 阶段 3
App 能不能稳 | TCP 字节流会粘包/半包；手机后台会被杀；现场 WiFi 可能连不上 | 阶段 7
两级报警 | 阈值可改 + 黄/红分级 + 消音，逻辑不难但用例多，容易漏 | 阶段 5

★ 顺序不能乱：先单模块（阶段 2）→ 再标定（阶段 3、4）→ 再联网（阶段 6）→ 最后联调（阶段 7）。跳过标定直接联调，出问题时无法区分是传感器、代码还是接线。

# 阶段 0 · 到货验收（约 2 小时）

目的：把坏件挡在焊接之前。每件单独验、单独记录，不要"装上去再说"。

器件 | 怎么验 | 判据 | 不通过怎么办
称重传感器 | 万用表量 E+/E− 阻抗；手指按压，量 A+/A− 电压变化 | 阻抗约 1kΩ；按压有 mV 级变化 | 完全不动 = 断线，退
HX711 | 3.3V 供电，量 DOUT；再给 SCK 10 个脉冲 | 上电 DOUT 高，脉冲后拉低一次 | 常低/常高 = 坏件，换
ESP32-C3 | USB-TTL 接 GPIO6/7，发 AT | 回 OK | 无回应：先确认固件与接线
OLED | I2C 扫描 0x3C 或直接点亮 | 有应答且能点亮 | 先查 4.7kΩ 上拉
蜂鸣器模块 | 3.3V 供电，I/O 接 GND | 响 | 不响 = 买成无源，换
红/黄 LED | 3.3V 串 220Ω 点亮 | 亮、颜色对 | 换一只
按键 | 万用表通断档 | 按下通、松开断 | 常通 = 卡死，换
标准砝码 | 在能借到的电子秤上核对 | 100g 读数在 99~101g | 偏差大就换
红外对射 | 3.3V 供电，万用表量接收头 OUT；手挡一次、放开一次 | 两种状态电平能明确区分 | 电平不变 = 发射头没亮或接反

# 阶段 1 · 上电前静态检查（约 30 分钟）

目的：避免第一次上电就烧板子。这一步花的半小时，省的是后面几天的排错。

检查项 | 怎么量 | 判据 | 记录
3V3 与 GND 是否短路 | 万用表电阻档，量面包板正负轨 | 电阻不为 0Ω（大于 100Ω 以上） | ______ Ω
5V 与 GND 是否短路 | 同上，量 STM32 的 5V 脚 | 同上 | ______ Ω
所有 GND 是否连通 | 通断档，逐段量 | 全部导通 | ☐ 通过
两个 4.7kΩ 上拉是否在位 | 电阻档量 3V3 到 SCL / SDA | 约 4.7kΩ | ______ kΩ
DS18B20 上拉是否在位 | 量 3V3 到 PA0 | 约 4.7kΩ | ______ kΩ
上电后 3V3 实测电压 | 万用表直流档 | 3.2~3.4V | ______ V
ESP32 的 5V 是否只进它自己 | 目视 + 通断 | 主板 3V3 与 ESP32 无连接 | ☐ 通过

# 阶段 2 · 分模块点亮（约 1 天）

目的：一次只加一个东西。每加一个，先断电接线、再上电验证，任何一步不过就停在这。

顺序 | 加什么 | 最小验证代码做什么 | 判据
1 | 调试串口（USB-TTL） | USART1 每 500ms 打印一行开机计数 | 串口助手能看到递增数字
2 | OLED | 初始化 + 显示 "502 OK" + 计数 | 屏幕亮、字清楚、刷新不闪
3 | DS18B20 | 读 ROM ID 与温度，串口打印 | 读到 28 开头 ID；室温 20~30℃ 合理
4 | 4 个按键 | 按下打印键值 + 消抖 20ms | 每个键都能稳定触发一次
5 | 蜂鸣器 + 两个 LED | 按键分别触发：响 / 红灯闪 / 黄灯闪 | 行为与预期一致，无一直接常响
6 | HX711 | 读 24 位原始值，串口打印 | 数值随按压变化，不是 0xFFFFFF/-1
7 | 红外对射（数滴） | PB12 外部中断计数，串口每 10 秒打印一次滴数 | 手挡 20 次，计数正好 20
8 | ESP32 链路 | 发 AT，确认回 OK；再发 AT+CIPMUX=1 | 回 OK 与 OK

HX711 读不到数时的排查顺序

阶段 2 最容易出问题的是第 6 步（HX711）。如果读到 0x7FFFFF、0xFFFFFF 或 −1，按顺序查：

① 传感器 E+/E− 是否接到模块（不是接到 STM32）；② HX711 与 STM32 是否共地；

③ SCK 是否真的在 PB10（用示波器/逻辑分析仪看有无脉冲）；④ 代码是否给了 25 个脉冲（见阶段 3）。

# 阶段 3 · 称重标定（最难，预留 1~2 天）

## 3.1 为什么这条路最难（先把账算清）

误差来源 | 量级（估算） | 会不会吃掉 ±2g
HX711 噪声（10Hz，取 10 点平均后） | 约 0.1~0.5g | 不会，但会让人以为读数在漂
1kg 传感器的线性度 + 迟滞（按 0.05%FS 估） | 约 0.5g | 吃掉约 1/4 余量，必须实测
零点漂移 / 去皮不准（挂具受力变化） | 可能 1~5g | ★ 最可能超差的一项
线缆拉扯、桌面振动 | 不定，可达数 g | ★ 机械问题必须先在结构上解决

★ 表中「0.05%FS」是廉价悬臂梁传感器的常见规格量级，本项目的传感器具体型号未定，到货后须以实物规格书为准。上表是估算，不是实测。

## 3.2 基准从哪来（这一条决定 ±2g 能不能被证明）

- 用标准砝码（100g 起，普通商用等级即可）：只要质量已知，普通砝码的允差远小于 ±2g。
- 或借实验室电子天平（0.1g 分辨）做二级基准，给砝码复核。
- ★ 不要拿「500ml 矿泉水 ≈ 500g」当基准：瓶子自重、水温、是否满装都会带来远超 2g 的误差。
- ★ 不要拿「手按压的感觉」当基准：这只证明"有反应"，不证明"准"。

## 3.3 标定步骤（照做，每步都记数）

步 | 操作 | 记录什么 | 判据
1 | 空载静置 30 秒，连续采 100 点平均 | 零点原始值 raw0 | —
2 | 把挂具（输液袋架子/挂钩）装上，再采 100 点平均 | 挂具原始值 raw_hanger | 与 raw0 差值稳定、可重复
3 | 软件去皮：显示归零 | 去皮后读数 | 显示 0.0g，且 30 秒内漂移 ≤1g
4 | 依次加载 100g / 200g / 500g / 800g，每档稳定 10 秒后采 20 点平均 | 每档读数 | 各档误差 ≤2g
5 | 卸载回空载，再采 100 点 | 回零读数 | 回零误差 ≤2g
6 | 同一砝码重复加载 3 次 | 3 次读数 | 极差 ≤2g（重复性）
7 | 同一质量分别"从轻加到重"与"从重减到轻"各测一次 | 两个读数 | 差值 ≤2g（迟滞）
8 | 四点做线性拟合，看残差 | 拟合斜率/截距/残差 | 最大残差 ≤2g

## 3.4 判定表（手填，不许事后补）

指标 | 要求 | 实测 | 判定
满量程误差（100g/200g/500g/800g） | ≤ ±2g | ____________ | ☐ 达成 ☐ 未达成
回零误差 | ≤ 2g | ____________ | ☐ 达成 ☐ 未达成
重复性（3 次极差） | ≤ 2g | ____________ | ☐ 达成 ☐ 未达成
迟滞（加/减载差） | ≤ 2g | ____________ | ☐ 达成 ☐ 未达成
2 小时零点漂移 | ≤ 2g（暂定，课题未规定） | ____________ | ☐ 达成 ☐ 未达成

## 3.5 不达标怎么办（按顺序试，别一次改三处）

症状 | 先改什么 | 再不行
零点一直漂 | 机械：传感器固定螺栓拧紧、挂具刚性、线缆不拉传感器 | 改软件：上电自动去皮 + 每 60s 缓慢跟踪零点
读数抖动大 | 采样率设 10Hz，滑动平均 10~20 点 | 改 80Hz + 双端屏蔽线
线性/迟滞超差 | 换 500g 传感器（量程缩到实际使用的一半以内） | 换更高等级传感器（成本上升，需说明）
挂具重量吃掉量程 | 选 1kg 量程时挂具 ≤ 0.25kg | 改 2kg（余量变薄，须重新标定）

# 阶段 4 · 温度标定（约半天）

DS18B20 的规格就是 ±0.5℃（−10~+85℃ 区间），正好等于课题指标，没有任何余量 —— 所以这一条必须实测，不能假设。

步 | 操作 | 记录 | 判据
1 | 室温静置 10 分钟，DS18B20 与电子体温计同时测同一杯水 | 两个读数 | 差值 ≤0.5℃
2 | 温水约 37℃（用手感+体温计控制），搅拌后同时测 | 两个读数 | 差值 ≤0.5℃
3 | 温水约 42℃（不要超过 45℃，避免烫坏探头） | 两个读数 | 差值 ≤0.5℃
4 | 把探头提出水面再放回，重复 3 次 | 每次读数 | 波动 ≤0.5℃

三个容易把温度标定做废的细节

测水温时要搅拌：不搅拌时杯底和杯口能差 1~2℃，会把"标定误差"和"水温不均"混在一起。

探头不要贴杯壁、不要露出水面。

若三点都稳定偏差同一个方向（例如恒偏 +0.3℃），可以在代码里做定点补偿；

★ 补偿后必须重做本阶段验证 —— 补偿本身也是一种"改数据"，要能被验证。

# 阶段 5 · 报警逻辑与阈值设置（约半天）

课题要求：支持按键自定义温度阈值和重量阈值；超过阈值时蜂鸣器报警 + LED 闪烁。本项目再加一层分级：接近阈值黄色预警，超限红色报警。

用例 | 构造条件 | 预期表现 | 实际
T1 | 温度 30℃、重量 800g（正常） | 不响、两灯都不亮、OLED 显示正常 | ☐
T2 | 温度 41.6℃（超黄线 41.5，未到红线 42.0） | 黄灯闪 + 可选短鸣；OLED 标"预警" | ☐
T3 | 温度 42.3℃（超红线） | 蜂鸣器响 + 红灯闪；OLED 标"报警" | ☐
T4 | 重量 80g（低于黄线 100g） | 黄灯闪 + 预警 | ☐
T5 | 重量 40g（低于红线 50g） | 蜂鸣器响 + 红灯闪 | ☐
T6 | 按键把温度红线从 42.0 改成 40.0 | 40.5℃ 就触发红色报警（说明阈值真的生效） | ☐
T7 | 按键把重量红线从 50 改成 200 | 300g 就触发（同上） | ☐
T8 | 报警时按"消音"键 | 响声停 10 秒，但红灯继续闪（项目1 的做法） | ☐
T9 | 断电重启 | 阈值回到默认值，或按设计保存（二者必须与文档一致） | ☐

★ 阈值"掉电保不保存"课题没要求。本项目默认不保存（上电回默认值），如果要保存需另加 Flash 写入，会引入擦写寿命与误写风险 —— 先不做，文档写清楚即可。

# 阶段 6 · 滴速（红外对射数滴）

课题要求测滴速。方案：红外对射夹在滴壶两侧，液滴下落时遮断光路，PB12 产生跳变，用外部中断计数，再按时间窗换算成"滴/分钟"。

## 6.1 先定"一滴"在电气上长什么样

现象 | PB12 上的电平 | 说明
无液滴通过 | 稳定高（或稳定低） | ★ 到底哪一种必须实测：手挡一次、放开一次，看电平怎么变
一滴落下遮断光路 | 电平翻转一次 | 一次完整跳变算一滴
连续成线（流速很快） | 长期停在翻转态 | ★ 物理上就没有离散滴，数不到 —— 原理性局限，必须写进报告
环境光直射 | 随机跳变 | ★ 必须加遮光罩，否则读数全是噪声

## 6.2 验证步骤

步 | 做 | 判据
1 | 无遮挡、手挡各测一次，记录两种状态的电平 | 能明确区分"通光 / 遮光"
2 | 秒表 + 手动挤压滴壶，人工造 20 滴 | 中断计数 = 20
3 | 连续 60 秒计数，换算滴/min | 与人工数的一致（±1 滴）
4 | 调到约 60 滴/min，连续 3 分钟 | 每分钟读数波动 ≤ ±3 滴/min
5 | 手机手电筒直射滴壶 | 加了遮光罩后误计数 = 0
6 | 夹住管路断流 | 滴速显示 0，无假计数

三个容易糊弄、但答辩一定会问的点

① 滴速 = 时间窗内滴数 × 60 ÷ 窗口秒数。窗口建议 10 秒：跟得上变化，也不至于抖。

② 液滴"成线"时物理上不存在离散滴，任何光学方法都数不到 —— 报告里要如实写，别假装能测。

③ 换算 ml/h 需要"每毫升多少滴"，输液器标称常见 20 滴/ml，但要以实物型号为准，别照抄。

# 阶段 7 · WiFi 与手机 App（约 1~2 天）

## 7.1 链路是怎么走的

环节 | 用什么 | 说明
传感器 → STM32 | DS18B20 / HX711 / 红外对射 | 采集温度、重量、滴速
STM32 → ESP32 | USART2（PA2/PA3，115200） | AT 指令 + 数据帧
ESP32 → 手机 | ESP32 做 TCP Server（AP 或 STA），手机连同一热点 | ★ 不用路由器也能演示
手机 → ESP32 | App 建立 TCP 连接，发一条握手/查询 | ESP32 回 +IPD 事件给 STM32
STM32 → 手机 | 自定义文本帧（如 T=36.5,W=480,D=60,S=0） | 约 40 字节，App 按分隔符解析

数据格式示例：T=36.5,W=480,D=60,S=0\n （温度/重量/滴速/报警状态），App 按逗号与等号拆分。

## 7.2 分步验证（每步都有判据，不要一次做完）

步 | 做 | 判据
1 | STM32 发 AT，ESP32 回 OK | 串口看到 OK
2 | 配 AP：AT+CWMODE=2 + AT+CWSAP；或配 STA：AT+CWJAP 连手机热点 | 手机能连上，或 ESP32 拿到 IP
3 | AT+CIPMUX=1 + AT+CIPSERVER=1,8080 | 两条都回 OK
4 | 用手机上的 TCP 调试 App 连 192.168.x.x:8080 | 串口出现 +IPD 事件
5 | STM32 回一行固定字符串 "hello 502" | 手机调试 App 里看到这行
6 | 填入真实数据帧 | App 解析出的数值与 OLED 一致
7 | App 连续收 10 分钟 | 不死机、无粘包错乱、ESP32 不掉线
8 | 断开 App 再重连 | 能自动恢复推送，STM32 不卡死
9 | 整套断电重启 | 自动恢复热点与服务，无需人工干预

局域网 TCP 的 4 个坑（含一条必须自己先说的实话）

① TCP 是字节流，会**粘包/半包** —— App 端必须按换行符切帧，不能"收到一次就读一次"。

② 必须先查现场有没有可用 WiFi：**校园网要 Portal 认证，ESP32 过不去** → 用手机热点或实验室路由器。

③ 手机 App 退到后台可能被系统杀掉 → 演示时要保持前台，或申请前台服务。

④ 本方案是**局域网直连**，不是云平台；若导师按字面验收，要切 MQTT（第 8 层已隔离，换一个文件）。

# 阶段 8 · 端到端联调 + 连续运行

项 | 怎么测 | 判据
模拟输液消耗 | 用装水的袋子/瓶子挂在传感器上，缓慢放水 | 重量单调下降，无跳变
报警联动 | 放水到黄线、红线 | 分级报警按预期触发
网页同步 | 手机每 10 分钟看一次页面 | 数值与 OLED 一致（差 ≤1 个刷新周期）
2 小时连续 | 记录每 10 分钟一次 | 无死机、无复位、零点漂移 ≤2g
24 小时连续（可选） | 同上，机器不用管 | 无死机；记录漂移曲线
断网恢复 | 拔掉 ESP32 电源 30 秒再插 | 网页自动恢复，STM32 不死等

★ 项目1 的教训：所有"连续运行"都写在清单里，但真正跑过的只有部分。本项目的 2 小时测试必须实际跑完并留下串口日志（用项目1 的 serial_log.bat）。

# 阶段 9 · 指标验收表（对着课题要求逐条判）

# | 要求 | 指标 | 设计手段 | 实测 | 判定

1 | 液体温度采集 | 25~42℃，≤±0.5℃ | DS18B20 12 位 + 定点补偿 | ______ | ☐达成 ☐部分 ☐未达成
2 | 液体重量采集 | ≤±2g | 1kg 悬臂梁 + HX711 + 滑动平均 | ______ | ☐达成 ☐部分 ☐未达成
3 | 滴速采集 | 滴/min，±3 滴/min（自定） | 红外对射 + 外部中断 + 10s 窗口 | ______ | ☐达成 ☐部分 ☐未达成
4 | 报警（阈值可设） | 按键可改 + 蜂鸣 + LED | 4 键 UI + 黄/红两级 | ______ | ☐达成 ☐部分 ☐未达成
5 | 显示 | OLED 实时显示温度/重量/滴速 | SSD1306 I2C 128×64 | ______ | ☐达成 ☐部分 ☐未达成
6 | WiFi 上传 | 手机 App 可查看 | ESP32 TCP Server + 安卓 App 直连 | ______ | ☐达成 ☐部分 ☐未达成

★ 写结论时的规矩（这是导师最会追问的地方）

判定只允许三种写法：已达成 / 部分达成 / 未达成。禁止"基本满足""总体良好"。

「部分达成」必须在旁边写清：哪一项到了、哪一项没到、差多少。

「WiFi 上传」要标明：本方案是**局域网直连**（手机与 ESP32 同一热点），不是公网云平台 ——

若导师按字面要求"上传平台"，需切 MQTT（第 8 层已隔离，换一个 .c 文件即可），约 2~3 天。

# 附录 A · 记录表模板（打印出来手填）

日期 | 阶段 | 测了什么 | 数据/现象 | 结论 | 签名

# 附录 B · 一句话总结（贴在工作台前）

没量过的，不写"达标"；
没跑过的，不写"稳定"；
改过的数据，等于没做。

毕业设计 2 · 可行性验证方案 v1.0 · 第 页
