Beiyiovo/stm32-infusion-monitor/文档/502引脚分配与逐脚连线表.docx

502 输液状态 WiFi 监测装置 · 引脚分配与逐脚连线表

主控 STM32F103C8T6（项目1 闲置板） + ESP32-C3（AT 固件，WiFi/网页）

版本 v1.0 · 2026-10-21 · 依据：课题 5 条硬要求 + 项目1 已实测接线

先看这里（30 秒）

本表是「照着一张表就能接完」的施工图，接之前先看第 5 节 12 条硬约束。

★ 与项目1 相同的部分（DS18B20 / OLED / 蜂鸣器 / LED / 按键 / ESP32 / 调试口）引脚完全没变，

可以从项目1 的代码直接搬；新增只有 3 处：PA6 第四按键、PB5 黄灯、PB10/PB11 HX711。

★ 所有引脚都避开了 JTAG（PB3/PB4）和 SWD（PA13/PA14），不需要改 AFIO 重映射。

# 一、一页速查：每个器件接几根线

器件 | 接到哪些脚 | 要几根线 | 作用
DS18B20 温度探头 | 3V3 · GND · PA0 | 3 根 + 1 个 4.7kΩ | 1-Wire，量杯内液体温度
0.96 寸 OLED | 3V3 · GND · PB6(SCL) · PB7(SDA) | 4 根 + 2 个 4.7kΩ | I2C，显示温度/重量/状态
有源蜂鸣器模块 | 3V3 · GND · PB0 | 3 根 | 低电平触发，超限报警
红色 LED | PB1 → 220Ω → LED → GND | 2 根 + 1 个 220Ω | 红色报警
黄色 LED | PB5 → 220Ω → LED → GND | 2 根 + 1 个 220Ω | 黄色预警
轻触按键 ×4 | PA1 / PA4 / PA5 / PA6 + GND | 5 根 | 设置/加/减/确认（长按去皮）
红外对射（滴速） | 3V3 · GND · PB12 | 3 根 | 数滴：每滴遮断一次光路，中断计数
HX711 模块 | 3V3 · GND · PB11(DT) · PB10(SCK) | 4 根 | 称重 ADC
称重传感器 | 接 HX711 的 E+ / E− / A+ / A− | 4 根 | ★ 颜色以实物说明为准
ESP32-C3 核心板 | PA2 → GPIO6 · PA3 ← GPIO7 · GND | 3 根（+ 自己的电源） | WiFi + 网页
USB-TTL（CH340） | TXD → PA10 · RXD → PA9 · GND | 3 根 | 烧录 + 调试打印
5V 适配器 ×2 | STM32 Micro USB / ESP32 Type-C | 2 路 | ★ 两套电源，只共地

合计占用 18 个 GPIO（无预留，PB12 已用于滴速），F103C8T6 的 I/O 余量充足（蓝板上 PD0/PD1 被 8MHz 晶振占用，不参与分配）。

# 二、引脚分配总表

引脚 | 功能 | 方向 / 配置 | 接到哪里 | 硬约束
PA0 | DS18B20 数据 | 输入上拉 IPU | DS18B20 黄线 | 外部 4.7kΩ 上拉到 3V3
PA1 | KEY1 设置/进入 | 输入上拉 IPU | 按键 1 一端 | 另一端接 GND，按下=低
PA2 | USART2_TX | 复用推挽 AF_PP | ESP32-C3 右排22 (GPIO6) | ★ TX 接对方 RX
PA3 | USART2_RX | 浮空/上拉输入 | ESP32-C3 右排23 (GPIO7) | ★ RX 接对方 TX
PA4 | KEY2 加 | 输入上拉 IPU | 按键 2 一端 | 另一端接 GND
PA5 | KEY3 减 | 输入上拉 IPU | 按键 3 一端 | 另一端接 GND
PA6 | KEY4 确认/长按去皮 | 输入上拉 IPU | 按键 4 一端 | 另一端接 GND
PA9 | USART1_TX | 复用推挽 AF_PP | USB-TTL 的 RXD | 调试打印 + 串口 ISP 烧录
PA10 | USART1_RX | 浮空输入 | USB-TTL 的 TXD | 同上
PB0 | 蜂鸣器 | 推挽输出 | 蜂鸣器模块 I/O | 低电平响；模块 VCC 接 3V3
PB1 | 红 LED（红色报警） | 推挽输出 | 220Ω → 红 LED 长脚 | 高电平亮
PB5 | 黄 LED（黄色预警） | 推挽输出 | 220Ω → 黄 LED 长脚 | 高电平亮
PB6 | I2C_SCL | 复用开漏 AF_OD / 普通 OD | OLED SCL | 外部 4.7kΩ 上拉到 3V3
PB7 | I2C_SDA | 复用开漏 AF_OD / 普通 OD | OLED SDA | 外部 4.7kΩ 上拉到 3V3
PB10 | HX711 SCK | 推挽输出（默认低） | HX711 SCK | 上电先输出低电平
PB11 | HX711 DOUT | 上拉输入 IPU | HX711 DT/DOUT | ★ 代码必须超时，否则传感器没接时死等
PB12 | 红外对射信号（数滴） | 输入上拉 IPU + 外部中断 | 红外接收头 OUT（3 线模块） | ★每滴产生一次下降沿 → 中断计数；模块 3V3 供电
PC13 | 板载 LED | 推挽输出 | 板上已有 | 做心跳/联网状态指示

# 三、没用的引脚怎么处理

引脚 | 状态 | 处理
PA7 / PA8 | 完全空闲 | 留排针，备用（可给第二按键组/继电器）
PA11 / PA12 | 完全空闲（USB DMA 脚，当普通 IO 用） | 备用
PA15 | 空闲（JTDI，需关 JTAG 才能当 IO） | 不推荐占用
PB3 / PB4 | JTDO / JNTRST —— 上电默认被 JTAG 占用 | ★ 本项目避开不用
PB13 / PB14 / PB15 | 完全空闲（SPI2） | 备用，可给滴速第二路/温湿度扩展
PA13 / PA14 | SWDIO / SWCLK | ★ 保留给 SWD 下载调试，不许占用
PB2 | BOOT1 | ★ 保持低电平，不接东西
BOOT0 | 启动模式选择 | ★ 烧录时置 1、运行置 0

★ 为什么不会碰到 JTAG 的坑

PB3 / PB4 上电默认是 JTAG 的 JTDO / JNTRST；要当普通 IO 必须先关 JTAG（AFIO->MAPR）。

本项目不需要它们，所以避开了 —— 少一个坑。

# 四、逐脚连线表（按元器件，照这个接）

## DS18B20 防水探头（3 线）

器件管脚 | 接到 | 备注
红色（VDD） | 3V3 电源轨 | —
黑色（GND） | GND 轨 | —
黄色（DQ） | PA0 | ★ 同时在 DQ–3V3 之间并 4.7kΩ 上拉电阻

## 0.96 寸 OLED（4 针）

器件管脚 | 接到 | 备注
VCC | 3V3 电源轨 | ★ 不要接 5V
GND | GND 轨 | —
SCL | PB6 | ★ 加 4.7kΩ 上拉到 3V3
SDA | PB7 | ★ 加 4.7kΩ 上拉到 3V3

## 有源蜂鸣器模块（3 针）

器件管脚 | 接到 | 备注
VCC | 3V3 电源轨 | ★★ 项目1 实测：接 5V 时 S8550 PNP 关不断，会一直响
GND | GND 轨 | —
I/O（信号） | PB0 | 低电平触发

## 红色 LED

器件管脚 | 接到 | 备注
长脚（+） | PB1 经 220Ω | ★ 必须串电阻，直接接会烧 IO
短脚（−） | GND 轨 | —

## 黄色 LED

器件管脚 | 接到 | 备注
长脚（+） | PB5 经 220Ω | 同上
短脚（−） | GND 轨 | —

## 轻触按键 ×4

器件管脚 | 接到 | 备注
按键1 一端 | PA1 | 内部上拉已开，★不需要外部电阻
按键2 一端 | PA4 | 同上
按键3 一端 | PA5 | 同上
按键4 一端 | PA6 | 同上
4 个按键的另一端 | GND 轨（可共用一条地线） | 按下读到低电平

## 红外对射（滴速 · 分体式）

器件管脚 | 接到 | 备注
发射头 VCC | 3V3 电源轨 | ★ 若模块未带限流电阻，阳极串 220Ω
发射头 GND | GND 轨 | —
接收头 VCC | 3V3 电源轨 | 带比较器的模块直接 3V3
接收头 GND | GND 轨 | —
接收头 OUT（DO） | PB12 | ★ 先无遮挡量一次、手挡一次，确认有效电平再写代码
机械固定 | 夹在滴壶【壶体两侧】，光路穿过壶内滴嘴与液面之间 | ★ 必须加遮光罩：环境光/日光灯会让它误计数

## HX711 模块 —— MCU 侧（4 针）

器件管脚 | 接到 | 备注
VCC | 3V3 电源轨 | ★ 用 3.3V：DOUT 电平天然匹配 STM32，不用电平转换
GND | GND 轨 | 必须共地
DT / DOUT | PB11 | 数据输出
SCK | PB10 | 时钟输入（10~50kHz 都可以，不用快）

## HX711 模块 —— 传感器侧（4 针）

器件管脚 | 接到 | 备注
E+ | 传感器激励线（常见红色） | ★ 颜色各厂不同，以传感器附带说明/模块丝印为准
E− | 传感器激励线（常见黑色） | —
A+ | 传感器信号线（常见白色或绿色） | ★ 若加负载读数变小 → 交换 A+/A−
A− | 传感器信号线（常见绿色或白色） | —

## ESP32-C3 核心板（只接 3 根）

器件管脚 | 接到 | 备注
右排 22 = GPIO6（模块 RX） | PA2（STM32 TX） | ★ 交叉：TX→RX
右排 23 = GPIO7（模块 TX） | PA3（STM32 RX） | ★ 交叉：RX→TX
GND | GND 轨 | ★ 必须共地，这是"能收到数据"的前提
5V / 3V3 | ★ 不接主板！ | 自己 Type-C 独立供电（WiFi 尖峰 350mA，主板 3V3 带不动）

## USB-TTL（CH340，烧录/调试）

器件管脚 | 接到 | 备注
TXD | PA10（STM32 RX） | ★ 交叉
RXD | PA9（STM32 TX） | ★ 交叉
GND | GND 轨 | ★ 不接 GND 会出现乱码
3V3 / VCC | ★ 不接 | 主板自己由 Micro USB 供电，不要双电源顶牛

# 五、电源树与地

电源 / 地 | 路径 | 约束
5V 适配器 A（USB 口） | STM32 板 Micro USB → 板载 AMS1117 → 3V3 排针 → 面包板正极轨 | 全系统唯一的 3V3 来源
3V3 轨 | OLED · DS18B20 · 蜂鸣器 · 红/黄 LED · HX711 | 估算总电流约 65mA（未实测），AMS1117 够用
5V 适配器 B（USB 口） | ESP32-C3 自己的 Type-C 口 | ★ 独立供电，绝不接主板 3V3（WiFi 尖峰 350mA）
GND 轨 | STM32 GND + 面包板负极 + 所有模块 GND + ESP32 GND | ★ 必须全部连通，这是"能收到数据"的前提

各部分电流估算（不含 ESP32，它自己独立供电）：

供电对象 | 取电方式 | 估算电流
OLED | 3V3 轨 | 约 20mA
DS18B20 ×1 | 3V3 轨 | 约 1.5mA
有源蜂鸣器 | 3V3 轨 | 约 30mA（响的时候）
红/黄 LED | 3V3 轨经 220Ω | 各约 5mA
HX711 + 桥路 | 3V3 轨 | 约 3~10mA
红外对射（滴速） | 3V3 轨 | 约 5~15mA
ESP32-C3 | ★ 自己的 Type-C 5V | 约 80mA 平均，尖峰 350mA
合计（不含 ESP32） | STM32 板载 AMS1117 承担 | 约 70~80mA，AMS1117 完全够

# 六、12 条硬约束自查（接线前逐条打勾）

# | 约束 | 违反了会怎样 | 说明

1 | I2C 两条上拉（4.7kΩ ×2 → 3V3） | 缺了 OLED 一定点不亮 | 项目1 为此卡过一整天
2 | DS18B20 的 4.7kΩ 上拉 | 缺了常读 85℃ 或读不到 | datasheet 要求，内部 40kΩ 只够短距离
3 | 蜂鸣器模块 VCC = 3V3 | 接 5V 会关不断、一直响 | 项目1 实测
4 | ESP32 只接 3 根线，电源独立 | 把 3V3 接上去会掉压重启 | WiFi 尖峰 350mA
5 | 所有 GND 汇成一个网络 | 不共地 → 收不到数据 / 读数乱跳 | 最容易被忽略的一条
6 | TX/RX 两处都交叉 | 不交叉 → AT 无回应、串口无输出 | PA2→GPIO6、PA3←GPIO7、PA9←TXD、PA10→RXD
7 | HX711 用 3V3 供电 | 接 5V 则 DOUT 输出 5V，需确认引脚耐压 | 用 3V3 可完全绕开这个问题
8 | 按键不加外部上拉、另一端接 GND | 接 3V3 会短路 | 内部 IPU 已开
9 | 两个 LED 都要串 220Ω | 不串电阻会烧 IO 或 LED | —
10 | 上电前用万用表量 3V3 与 GND 之间不短路 | 短路会烧 AMS1117 | 每次改线都要量
11 | BOOT0 运行=0、烧录=1 | BOOT0 悬空会随机启动失败 | 烧完记得拨回 0
12 | ESP32 的 AT 口在 GPIO6/7，不是 Type-C | Type-C 走 UART0，发 AT 没反应 | 项目1 实测结论

# 七、和项目1 的差异（别照着老接线图接错）

项目1 的接法 | 本项目接法 | 为什么改
PB6/PB7 挂 OLED + MPU6050 + MAX30102 | PB6/PB7 只挂 OLED | 本项目不用心率血氧和计步
3 个按键（PA1/PA4/PA5） | 4 个按键（+PA6） | 多一个确认/去皮键
只有红色 LED（PB1） | 红 PB1 + 黄 PB5 | 课题要黄/红两级分级报警
没有 HX711 | PB10 = SCK，PB11 = DT | 课题要求称重
没有滴速 | PB12 = 红外对射信号（外部中断） | 2026-10-22 导师确认滴速要做
ESP32 做 TCP Server，手机 App 直连 | 不变：手机与 ESP32 同一热点，App 直连 8080 | 上报层已隔离，可整体换 MQTT
DS18B20 PA0 / 蜂鸣器 PB0 / ESP32 PA2-PA3 / 调试 PA9-PA10 | 完全不变 | 可直接复用项目1 驱动
ESP32 用 Type-C 供电并共地 | 同样，但只接 GPIO6/7/GND 三根 | AT 口不在 Type-C 上

# 八、常见接线错误 → 现象对照（排错先查这张表）

现象 | 最可能的原因 | 先查什么
OLED 全黑 / I2C 扫描无应答 | 缺 4.7kΩ 上拉 / SDA、SCL 接反 / 没共地 | 先量上拉，再交换 SDA/SCL 试
DS18B20 一直读 85℃ | 上电首值没丢 / 上拉缺失 / 供电不足 | 丢弃第一次读数，补 4.7kΩ
HX711 读数固定 0x7FFFFF 或 -1 | 传感器没接 / 没共地 / 引脚接错 | 量 E+/E− 阻抗应约 1kΩ
重量读数一直漂 | 挂具没固定 / 激励不稳 / 没做去皮 | 上电自动去皮 + 滑动平均
蜂鸣器一直响 | VCC 接了 5V，或 PB0 上电默认电平不对 | 改 3V3，上电先把 PB0 拉高（不响）
串口全是乱码 | 波特率不对 / USB-TTL 没共地 | 先 9600 试，再 115200
ESP32 发 AT 无回应 | TX/RX 没交叉 / 用错接口（Type-C）/ 固件不是 AT | 接 GPIO6/7，确认固件
手机连上热点但网页打不开 | STM32 没回 HTTP / 端口不是 80 / 手机用了流量 | 先确认 +IPD 有数据进来

# 九、上拉电阻与限流电阻的数值

位置 | 阻值 | 怎么算 / 为什么
I2C SCL、SDA（各 1 个） | 4.7kΩ | 3.3V 系统标准值；400kHz 下上升沿够快，漏电流又可接受
DS18B20 DQ | 4.7kΩ | 1-Wire 标准上拉，datasheet 推荐
红色 LED 限流 | 220Ω | (3.3V − 2.0V) / 220Ω ≈ 5.9mA，亮度够且不超 IO 的 20mA
黄色 LED 限流 | 220Ω | 同上（黄光 Vf 略高，电流略小，正常）
按键 | 不需要 | STM32 内部上拉 40kΩ，短按 10ms 以上足够稳定

诚实声明（哪些是实测、哪些是推断）

本表里的引脚号、交叉关系、上拉数值，全部来自项目1 已实测跑通的接法（除 HX711 与黄灯为新增）。

HX711 部分依据 datasheet 的时序与增益说明（第 25 个脉冲 = 通道 A、增益 128），尚未在本项目实测。

「±2g 能达到」不是本表的结论，必须按《502可行性验证方案》做完标定才有结论。

毕业设计 2 · 引脚分配与逐脚连线表 v1.0 · 第 页
