Beiyiovo/stm32-infusion-monitor/文档/项目交接说明.docx

# 毕业设计 2

基于单片机的输液状态 WiFi 监测装置设计

项目交接说明

研究者：谢玲　2352500401　电子工程学院 · 物联网工程

开工：2026 年 10 月 21 日　｜　本文件：2026-10-21 晚

★ 本项目只做硬件功能实现，不写论文

# 一、项目概述

1.1　一句话说明

用单片机采集输液液体的温度和剩余重量，在 OLED 上显示，超阈值时蜂鸣器 + LED 报警，

并通过 WiFi 让手机浏览器能远程看到数据。

1.2　课题要求（用户原文，逐条照录）

（一）5 条硬要求

# | 要求 | 指标

1 | 温度采集 | 采集输液液体温度，范围 25~42℃，精度 ≤±0.5℃
2 | 液体重量采集 | 压力称重传感器，精度 ≤±2g
3 | 报警功能 | 按键自定义温度阈值和重量阈值，超阈值时蜂鸣器 + LED 闪烁
4 | 显示功能 | OLED 实时显示当前温度和重量
5 | WiFi 上传 | 将数据通过 WiFi 上传平台

（二）主要任务（原文）

临床输液过程中液体温度、剩余药量和滴速三个参数共同决定输液安全性和舒适度，

单一传感器监测存在盲区。本课题基于单片机集成三种传感器实现输液状态多参数监测。

通过 WiFi 建立监测页面，手机远程查看；设计黄/红两级分级报警逻辑：

某项参数接近阈值时黄色预警提醒关注；超限时红色报警紧急处理；

完成软硬件调试与毕业设计论文撰写。

1.3　★ 两处规格需要说明

问题 | 情况 | 当前处理
★ 滴速在 5 条要求里没有，但主要任务说它是三个参数之一 | 已向用户确认，回答「还不确定」 | ★ 先按「不做」设计，但在引脚和代码里预留扩展位置
「完成论文撰写」与用户要求「不写论文」冲突 | 用户明确：只做硬件功能 | ★ 以用户要求为准，不写论文

# 二、已确认的三个决策（2026-10-21）

A2　WiFi 方案 = ESP32 内建网页

用户选择：手机浏览器打开网页查看，不用装专用 App。

★ 注意：这与「项目1」的做法不同 ——

项目1：ESP32 烧 AT 固件，只做 TCP 透传，手机用专用 Android App

本项目：要输出【网页】，AT 固件做不到直接输出网页

★ 所以引出了第三章的主控选型问题。

A3　报警阈值 = 用默认值（可改、按键也能自定义）

参数 | 黄色预警 | 红色报警
温度 | > 41.5 ℃ | > 42.0 ℃
重量 | < 100 g | < 50 g

★ 这些数值在代码里做成可改的宏，同时按键支持自定义。

A1　滴速 = 暂不确定，先按不做设计但预留扩展

用户回答：还不确定。

处理方式（不阻塞、不堵死后路）：

· 硬件：引脚分配里预留 1 个 GPIO + 3 个排针位给红外对射传感器

· 软件：预留 drop_rate 模块接口，函数体先留空

· 后面想加 = 插线 + 填函数，不用改架构

★ 如果之后确认要做，需要加：红外对射/光电传感器（约 5~15 元）+ 滴壶固定结构。

# 三、★ 主控选型：三条路（等用户选）

★ 这是当前最大的分叉点，选错会多花很多时间。

3.1　三条路的对比（每行一个方案）

方案 | 主控 | WiFi + 网页怎么实现 | 工作量 / 成本
★ X1 （推荐） | STM32F103C8T6 （复用项目1） | ESP32 保持 AT 固件，用 AT+CIPSERVER； STM32 里手工拼 HTTP 响应报文（约 200~300 行） | 工作量：中 （复用项目1 全部框架） 成本：只买传感器 + HX711，约 15 元
X2 | STM32F103C8T6 | ESP32 重烧 Arduino / ESP-IDF； ESP32 自己跑 HTTP 服务器，STM32 只发数据 | 工作量：大 （要写两套程序 + 重烧 ESP32） 成本：同上
Z | ESP32-C3 单独做主控 （不要 STM32） | ESP32 内建 HTTP 服务器， 直接输出网页 | 工作量：小（一套程序） 但项目1 的代码用不上 成本：买 1 个 ESP32，约 15~25 元

3.2　推荐 X1 的四条理由

① 复用项目1 全部已验证框架

AT 指令收发、串口环形缓冲、OLED 驱动、按键消抖、蜂鸣器、软件 I2C ——

这些都在项目1 的真实硬件上跑通过，直接搬过来。

② ESP32 不用重烧固件

项目1 那个 AT 固件是 6 月烧好的，重烧有变砖风险，能不重烧就不重烧。

③ ★ Flash 反而更宽松

项目 | Flash 占用
项目1 最终（含心率血氧 + 计步） | 27400 字节 / 32768
本项目去掉 MAX30102 心率血氧算法 | 约 −8000 字节
本项目去掉 MPU6050 计步 | 约 −2000 字节
本项目加上 HX711 驱动 | 约 +500 字节
本项目加上 HTTP 报文处理 | 约 +1500 字节
本项目加上网页字符串 | 约 +1000~2000 字节
★ 预计合计 | 约 20000~22000 字节（余量充足）

④ 成本最低

主控复用项目1 的 STM32，只买称重传感器 + HX711，约 15 元。

3.3　★ X1 的缺点（如实说明）

· STM32 里要自己拼 HTTP 报文（纯文本字符串拼接，200~300 行）

· 网页只能很简单（不能上复杂 JS 框架），但显示数值 + 自动刷新够用

# 四、现有可复用资源（来自项目1 采购清单）

4.1　★ 可直接用的（不用再买）

器件 | 项目1 数量 | 本项目用途
DS18B20 防水探头 | 2 个 | 测液体温度
0.96 寸 OLED（I2C SSD1306） | 1 个 | 显示温度 + 重量
有源蜂鸣器模块 + 红色 LED | 1 套 | 报警
轻触按键 6×6×5 | 6 个 | 阈值设置（需 3~4 个）
电阻电容套装 | 1 套 | 含 4.7kΩ 上拉（项目1 血泪教训）
面包板 830 孔 | 1 块 | 搭建
杜邦线（公对公 / 公对母） | 各 1 扎 | 接线
5V 电源适配器 | 2 个 | 供电
数字万用表 | 1 台 | 调试
电烙铁 + 焊锡 + 助焊剂 + 吸锡器 + 镊子 | 各 1 | 焊接
洞洞板 5×7cm | 1 套 | 可选
铜柱 + 螺丝 M3 | 1 套 | 固定
电子体温计 | 1 支 | 温度标定基准
游标卡尺 | ❌ 没有 | 暂时不买，靠淘宝页面尺寸

4.2　★ 需要确认数量的

器件 | 项目1 买了 | 要确认什么
STM32F103C8T6 开发板（带 CH340） | 2 块 | 还剩几块空闲？
ESP32-C3（CORE-ESP32） | 1 个 | 项目1 占用中，本项目要再买吗？
排母座 2.54mm | 若干 | 还剩多少？

4.3　★ 必须新买的（初步）

器件 | 估计单价 | 说明
称重传感器（悬臂梁式） | 8~15 元 | 量程待定，5kg 最常见
HX711 称重 ADC 模块 | 5~8 元 | 24 位 ADC，常与传感器打包卖
ESP32-C3（若项目1 占用） | 15~25 元 | 待确认
红外对射传感器（仅做滴速时） | 5~15 元 | 待 A1 改「做」

★ 粗略估算：如果主控和 ESP32 都能复用，新增采购约 15~25 元；

如果需要买 ESP32，约 30~50 元。

# 五、★★★ 待用户确认（阻塞采购和选型）

★ 下面 4 条不确认，不能出采购清单和连线表。

# | 问题 | 选项 | 选了的后果

B1 | STM32F103C8T6 还剩几块空闲？ | A. 有 1 块空闲 B. 2 块都在用 / 不确定 | A → 主控不用买 B → 要么再买 STM32（12~18 元）， 要么考虑方案 Z
B2 | ESP32-C3 有几个？ | A. 只有 1 个（项目1 占用） B. 还有备用 | A → 要买 1 个（15~25 元） B → 不用买
B3 | 排母座还剩多少？ | A. 够用 B. 要补 C. 拍照给你看 | 影响是否要下单
B4 | 主控走哪条路？ | A. X1（STM32 + ESP32，复用项目1） B. Z（ESP32 单独） C. 你帮我定 | A → 工作量中，复用最多 B → 一套程序最干净， 但项目1 代码用不上

5.1　其他待确认（不阻塞，但影响细节）

# | 问题 | 影响

A4 | 输液袋最大多少 ml？（常见 500ml / 1000ml） | 决定称重传感器量程： 500ml 约 550g，1000ml 约 1050g
A5 | 温度传感器用 DS18B20 还是换 PT100？ | DS18B20 精度刚好卡线（见第六章） PT100 要加 30 元
C1 | 交付物：只要硬件跑通 / 要代码 + 演示 / 还要打 PCB？ | 决定要不要画原理图和 PCB
C2 | 时间节点？ | 决定推进节奏

# 六、技术风险预判（客观，未验证）

★ 下面都是「可能出问题」的地方，不是「一定会出问题」。标注了依据和应对。

风险 | 依据 | 应对
★ 温度精度卡线 | 要求 ≤±0.5℃；DS18B20 datasheet 在 −10~85℃ 区间规格就是 ±0.5℃ → 没有余量 | 用电子体温计标定，记录偏差补偿； 偏差太大再换 PT100（+30 元）
★ 称重精度需实测 | 要求 ≤±2g；5kg 悬臂梁 + HX711 典型能做到 ±1~2g， 但典型值不等于保证值 | 到货后用已知重量（500ml 水约 500g）标定验证
输液袋挂具引入误差 | 去皮（tare）不准会直接叠加到重量误差上 | 上电自动去皮 + 按键手动去皮
★★ I2C 上拉电阻 | 项目1 曾因缺 4.7kΩ 上拉卡一整天（已写入项目1 记忆） | 面包板阶段就先接上，PCB 必须画
★ MDK-Lite 32KB 上限 | 项目1 最终 27400 字节，接近上限 | 用 -O2 编译并监控 map；本项目预计更小

# 七、下一步计划

7.1　第 1 步：等用户回答 B1~B4

7.2　第 2 步：依次产出 4 份文档

顺序 | 产出 | 内容
1 | 项目可行性分析 + 选型对比 | 为什么选这个方案、风险在哪、成本多少
2 | 采购清单 | 含单价、淘宝搜索关键词、标注哪些可复用
3 | 引脚分配 + 逐脚连线表 | 按元器件组织，每个脚接哪里（像项目1 那样）
4 | 可行性验证方案 | 含上拉电阻等硬约束的检查清单，逐项打勾

7.3　第 3 步：建代码工程目录

建议：T:\AS\bishei502\（纯 ASCII 路径，Keil 要求）

按项目1 的分阶段方式：01_uart → 02_xxx → … → 最终整合

7.4　第 4 步：写代码前先查官方例程

· HX711 的官方数据手册与 Arduino/STM32 例程（时序、增益选择、去皮）

· ESP32 AT 固件的 AT+CIPSERVER 用法（项目1 已用过，可查项目1 的 at_test.bat）

· 手工 HTTP 响应报文的最小实现（Content-Length、Connection: close）

7.5　工作方法（用户明确要求）

① 必须先验证方案可行性，不盲目动手

② 重复验证各元件之间的连线正确性和稳定性（项目1 的教训）

③ 必须基于客观事实分析难度和成本，不拔高、不美化

④ 用好每一分资源，现有元器件优先复用

⑤ 新元器件尺寸不明时，先查淘宝商详页，再决定要不要买游标卡尺

⑥ 写代码前先找官方例程，取其精华

# 八、本文件的可靠性说明

【可验证的事实】

· 课题 5 条要求 + 主要任务 —— 用户 2026-10-21 原文提供

· 现有元器件清单 —— 从项目1 的 501采购清单(可勾选).xlsx 逐项读出

· 项目1 的 Flash 占用 27400 字节 —— 来自 Keil map 实测

· I2C 上拉电阻缺失导致卡一整天 —— 项目1 实测记录

· DS18B20 的 ±0.5℃ 规格 —— 器件 datasheet

【推测（未验证）】

· 本项目预计 Flash 约 20000~22000 字节 —— 基于模块增删估算，实际要编译后看

· X1 方案「STM32 拼 HTTP 报文约 200~300 行」—— 经验估算，未实测

· 称重精度「典型 ±1~2g」—— 常见方案的经验值，未实测

· 新增采购「约 15~25 元」—— 按淘宝常见价格估算，未核价

【我不知道的】

· STM32 / ESP32 / 排母座的实际库存（待用户确认）

· 滴速到底做不做（用户未定）

· 学校的评审标准（这个项目不写论文，但可能有课程验收标准）

· 交付物范围（只要硬件跑通，还是要打 PCB）

# 九、B1~B4 答复与定稿（2026-10-21 晚）

第五节列的 4 个问题（阻塞采购）当晚已答完。本节把答复、定稿结论，以及答复过程中暴露出来的一个真问题（库存判断错了）一并写清，供后续随时复核。

## 9.1 四项答复

# | 问题 | 用户答复 | 落定结论

B1 | STM32F103C8T6 还剩几块空闲 | A. 有 1 块空闲 | 主控不买，用闲置那块
B2 | ESP32-C3 有几个 | A. 只有 1 个（项目1 占用） | 必须买 1 块同型号
B3 | 排母座还剩多少 | A. 够用 | 够；且面包板阶段用不到
B4 | 主控走 X1 还是 Z | C. 你帮我定 | 定为 X1

## 9.2 选型定稿：X1

X1 = STM32F103C8T6（复用项目1 框架）+ ESP32-C3（保持 AT 固件）+ STM32 手拼 HTTP 响应。

方案 | 定稿 | 核心理由 / 为什么不是它
X1 | ✅ 采用 | 复用项目1 已验证的 AT 收发、串口环形缓冲、OLED、按键、蜂鸣器、软件 I2C；Flash 反而更宽（去掉心率血氧/计步约 8KB，新增 HX711+HTTP 约 3KB）
X2 | ✗ | 要重烧 ESP32 为 Arduino/ESP-IDF，等于两套程序都要自己写，工作量最大
Z | ✗ | ESP32-C3 单独做主控看起来很省事，但项目1 全部代码作废，且同样要买板子 —— 没有成本优势

★ X1 的代价照实写：① STM32 里要手工拼 HTTP 报文；② 网页只能是简单静态页（数值 + 自动刷新）。

## 9.3 答复暴露的真问题：库存判断是错的

第四节 4.1 曾把 OLED、蜂鸣器列为"可以直接用"。核对数量后发现在采购清单里它们**各只买了 1 件**，并且都已装在赖振雄自己的毕设板上 —— 拆下来就毁掉另一个毕设。

器件 | 项目1 数量 | 现状 | 本项目结论
ESP32-C3（CORE-ESP32） | 1 块 | 已装在自己板上，烧着 AT 固件 | 买 1 块新板 + 烧同一份固件
0.96 寸 OLED | 1 个 | 已装在自己板上 | 买 1 个
有源蜂鸣器模块 | 1 套 | 已装在自己板上 | 买 1 套
红色 LED | 1 个 | 已装 | 买（分级报警还要黄色）
轻触按键 | 6 个（用掉 3） | 剩 3 个 | 补 1~2 个（本项目要 4 个）
STM32F103C8T6 | 2 块 | 1 块闲置 | ✅ 用闲置那块

★ 一个意外的好消息：AT 固件整套文件仍在本地 T:\TE\ESP32-C3-MINI-1-AT-V4.1.1.0\（esp-at.bin / at_customize.bin / factory_MINI-1.bin / ota_data_initial.bin），新板烧固件不需要联网。

## 9.4 预算修订

项目 | 原估算 | 修订后 | 原因
新购器件合计 | 约 ¥15 | 约 ¥59~115 | ESP32/OLED/蜂鸣器/黄灯/按键都要买
新增项：标准砝码 | （原清单没有） | ¥10~25 | 没有已知质量基准，±2g 无法被证明
重量传感器量程 | 5kg（最常见） | 1kg 全桥 | 1kg 按 0.05%FS≈0.5g；5kg≈2.5g，会吃掉 ±2g 全部余量

## 9.5 配套文档（都在 毕业设计2\文档\）

文档 | 作用 | 什么时候用
502采购清单(可勾选).xlsx | 12 项采购 + 可复用核对 + 到货验收 + 下单顺序 | 现在：下单前
502引脚分配与逐脚连线表.docx | 17 个引脚分配、逐器件连线、12 条硬约束 | 到货后：接线时
502可行性验证方案.docx | 8 阶段验收，含称重/温度标定与指标判定表 | 接线后：逐阶段验收
项目交接说明.docx（本文） | 课题要求、决策、选型、风险 | 随时查阅

## 9.6 仍需确认（不影响下单）

# | 问题 | 已按什么假设推进 | 若假设不成立怎么办

A4 | 输液袋最大多少 ml | 按 500ml 袋定 1kg 传感器 | 若实际要用 1000ml → 换 2kg（余量变薄）；3000ml 营养袋 → 必须 5kg
A5 | 温度传感器用 DS18B20 还是 PT100 | 先用 DS18B20（已有） | 实测超 ±0.5℃ → 换 PT100+MAX31865（约 +¥30）
C1 | 交付物范围（只面包板 / 要 PCB） | 先按面包板推进 | 要 PCB 再买排母、洞洞板、打板
C2 | 时间节点 | 未定，按 8 阶段顺序推进 | 时间紧则先做 3/4/5 阶段（达标核心），网页最后

★ 一句必须自己先说清的话

本方案是「手机连 ESP32 热点」的局域网查看，严格说不等于"上传到平台"。

答辩时若被问到，应主动说明；升级路径是 ESP32 转 STA 连路由器 + AT+MQTTCONN 上巴法云

（项目1 已实测该 AT 固件支持 MQTT），属于二期工作，不在本期交付内。
