Beiyiovo/stm32-infusion-monitor/_工具/说明.md

# _工具 说明（毕业设计 2 · 502）

> 这一层是**生成脚本**，不是成品。成品在 `..\文档\`。
> 建立：2026-10-21 · 全部脚本用 `__file__` 定位目录，整个 `毕业设计2\` 文件夹可以整体搬走。

## 一、怎么重新生成

解释器用 DSH 自带的 Python（已装 python-docx / openpyxl / lxml）：

```powershell
$py = 'C:\Users\86156\.dsh\dsh-runtimes\dsh-primary-runtime\dependencies\python\python.exe'
$env:PYTHONIOENCODING = 'utf-8'      # 不加这行，控制台按 GBK 输出中文会报错

& $py 'T:\AS\毕业设计\毕业设计2\_工具\gen_502_bom.py'      # → 文档\502采购清单(可勾选).xlsx
& $py 'T:\AS\毕业设计\毕业设计2\_工具\gen_502_pinmap.py'   # → 文档\502引脚分配与逐脚连线表.docx
& $py 'T:\AS\毕业设计\毕业设计2\_工具\gen_502_verify.py'    # → 文档\502可行性验证方案.docx
```

三个脚本都是**整份覆盖重写**，改内容就改脚本里的数据表再跑，别直接编辑 docx（否则下次重跑会被冲掉）。

## 二、每个文件干什么

| 文件 | 作用 |
|---|---|
| `docx_common.py` | 公共样式库：A4 版心、标题/正文中文字体、带斑马纹的表头、提示框、页码域 |
| `gen_502_bom.py` | 采购清单：4 个工作表（采购清单 / 可复用核对 / 采购顺序 / 到货验收），含下单勾选列与预算合计 |
| `gen_502_pinmap.py` | 引脚分配与逐脚连线表：17 个引脚总表、按器件分组的连线、电源树、12 条硬约束、排错对照 |
| `gen_502_verify.py` | 可行性验证方案：8 个阶段 + 称重/温度标定步骤 + 指标验收表 + 记录表模板 |
| `append_handoff_sec9.py` | 给 `项目交接说明.docx` **追加**第九章（B1~B4 答复与定稿）。⚠️ **只能跑一次**，再跑会重复追加 |
| `fix_handoff_table_width.py` | 修交接说明里原本超宽的那张选型对比表（18.4cm → 17.0cm），可重复执行 |
| `fix_handoff_budget.py` | 把交接说明里的预算数字改成和采购清单一致（¥56~103），可重复执行 |
| `_backup_项目交接说明_20261021.docx` | 追加第九章**之前**的原件备份。要回退就把它复制回 `..\文档\` |

## 三、踩过的坑（下次别再踩）

1. **页面宽度**：A4 版心 17.0cm、Letter 版心 17.19cm。所有表格列宽之和必须 ≤ 版心宽，
   否则右侧会被切到页外 —— 生成后脚本里要核一遍（`sum(widths)`）。
2. **表格行跨页**：不设 `w:cantSplit` 时，一行会被拆到两页，下一页顶部留下**一个空行**。
   已在 `docx_common.add_table` 里对所有行加了 `cantSplit`。
3. **不要用字符画**：中文按双宽算、Consolas 里的框线字符按单宽算，`┌─┴─┐` 必错位。
   电源树/链路图一律改成表格（v1.0 第一版就是字符画，渲染出来是歪的）。
4. **中文字体要两条**：`run.font.name` 只设拉丁字体，中文还得写 `w:eastAsia`，
   否则 Word 里中文回落到宋体、和西文不搭（`docx_common.set_run_font` 已处理）。
5. **交接说明是 Letter 纸 + 微软雅黑**，和 502 三份新文档（A4 + 宋体）不是一套。
   往交接说明里追加内容时要用它自己的字体，别套 `docx_common` 的默认值 ——
   `append_handoff_sec9.py` 里做了 `retouch()` 改写字体。
6. **渲染检查**：用 `office-render` 的 LibreOffice Kit 出图看，能抓出"看着对、其实被切"的问题。
   `--pages 4,5` 只会输出 `page-0001/0002.png`（按顺序编号，不是按原页码）。

## 四、可复核的证据（本次做过的检查）

- 三份文档重开后：表数量 22 / 21 / 19，超宽表格 0 个（脚本 `_recheck` 逐表求和比对版心）
- 渲染：引脚表 6 页、验证方案 6 页、采购清单 1 张工作表，逐页看过，无截断、无空行
- 预算手算复核：必买 7 项 10+5+15+10+4+2+10 = **56**，上限 18+8+25+15+8+4+25 = **103**
