Beiyiovo/stm32-infusion-monitor/PCB/屏幕截图 2026-10-28 151408.png

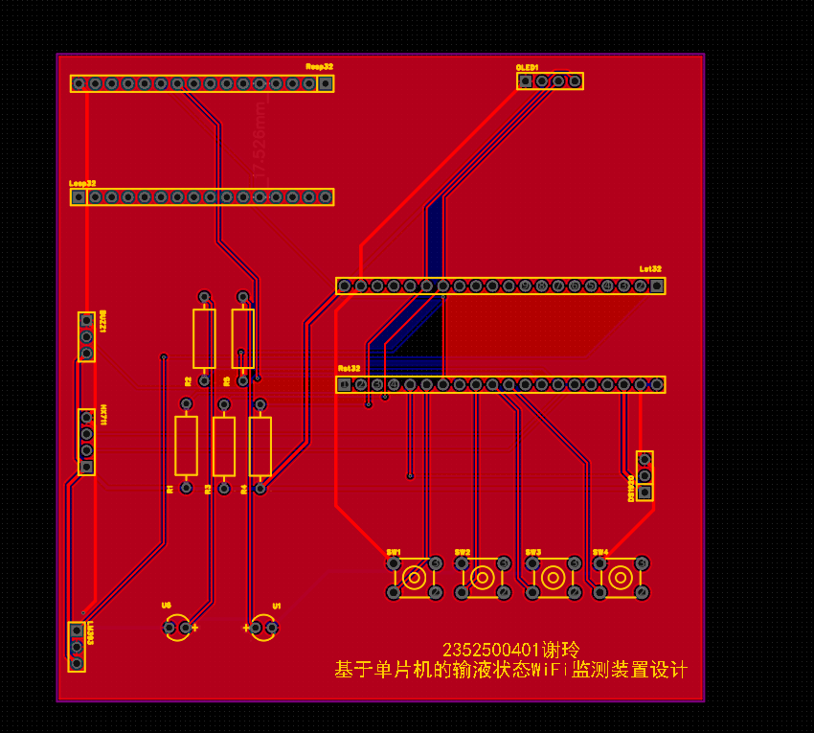
PCB/屏幕截图 2026-10-28 151408.png
