Beiyiovo/stm32-infusion-monitor/文档/_图_字库预览.png

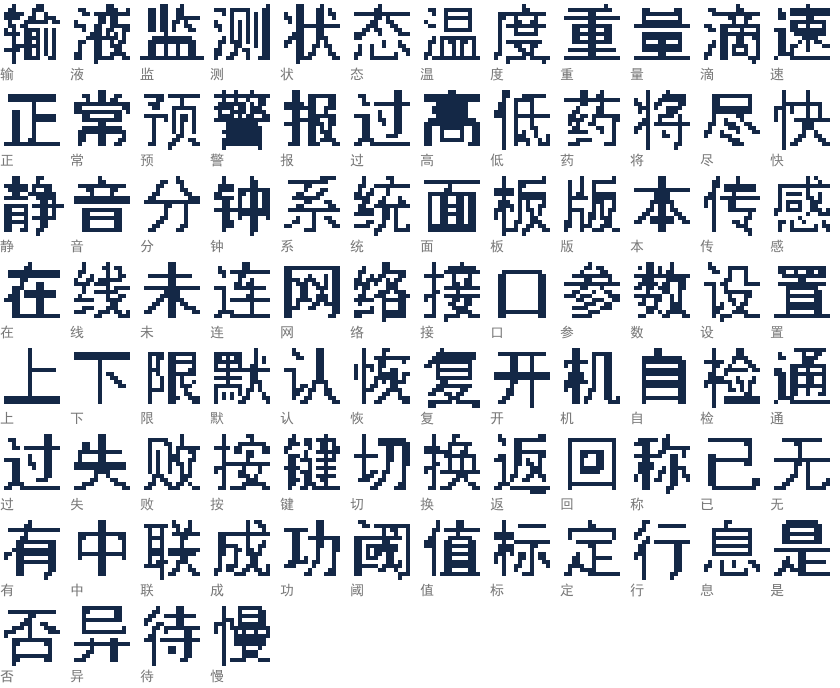
文档/_图_字库预览.png
