Beiyiovo/stm32-infusion-monitor/硬件/PCB_底层视图.png

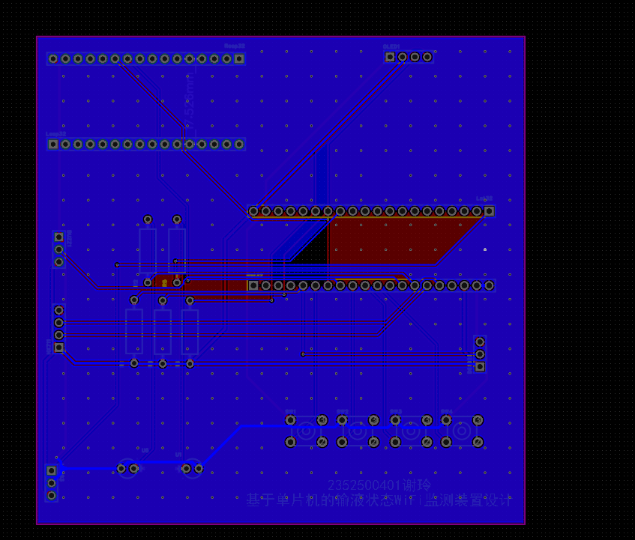
硬件/PCB_底层视图.png
