Beiyiovo/stm32-infusion-monitor/硬件/PCB布局_早期版.png

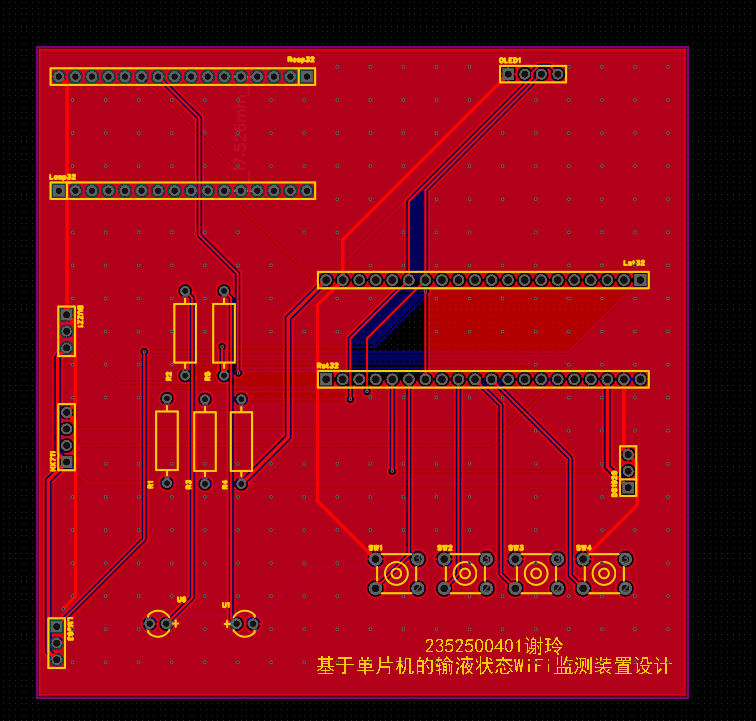
硬件/PCB布局_早期版.png
