Beiyiovo/stm32-infusion-monitor/硬件/PCB成品_顶层.png

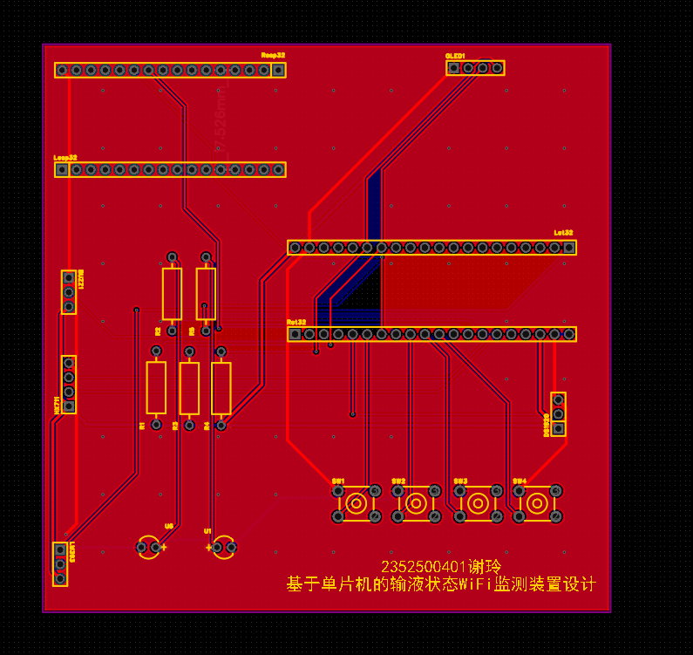
硬件/PCB成品_顶层.png
