Beiyiovo/stm32-infusion-monitor/交付素材/拍摄清单.md

# 交付素材拍摄清单

> 拍完把文件放进本文件夹，按下面的命名规则命名即可。不需要改任何文档。
> 总大小建议控制在 1.5 GB 以内（视频 1080P 约 100 MB/分钟，够用即可，不必 4K）。

## 一、照片（每张 2~5 MB，JPG）

| 编号 | 拍什么 | 要点 | 文件名 |
|---|---|---|---|
| P1 | 整机全貌 | 面包板 + 全部模块 + OLED 亮屏，45° 俯拍 | P1_整机全貌.jpg |
| P2 | 接线特写 | STM32 与各模块的杜邦线走向，能看清线色 | P2_接线特写.jpg |
| P3 | OLED 主页 | 温度/重量/滴速三行清晰可读 | P3_OLED主页.jpg |
| P4 | OLED 报警态 | 标题行「报警 xxx」+ 红灯亮 | P4_OLED报警.jpg |
| P5 | App 主界面 | 手机截屏：克重大数字 + 状态色 | P5_App主界面.png |
| P6 | App 趋势图 | 手机截屏：折线图页面 | P6_App趋势.png |
| P7 | 称重标定 | 盘上放砝码 + OLED 显示 K 值 | P7_标定.jpg |
| P8 | PCB 图 | 立创EDA 的 2D/3D 预览截屏 | P8_PCB图.png |

## 二、视频（每段 20~40 秒，1080P，MP4）

| 编号 | 拍什么 | 要点 | 文件名 |
|---|---|---|---|
| V1 | 开机自检 | 按复位：滴滴两声 → 自检页 → 主页（一段连续拍完） | V1_开机自检.mp4 |
| V2 | 分级报警 | 空秤触发红色报警：红灯闪 + 三声蜂鸣 → 放 100g 解除 | V2_分级报警.mp4 |
| V3 | 阈值设置 | K3 短按改阈值 + K3 长按 2 秒进「设置2」各拍一段 | V3_阈值设置.mp4 |
| V4 | App 实时 | App 收数 + OLED 同步变化同框 | V4_App实时.mp4 |
| V5 | 称重复核 | 放 100g 砝码 → OLED 显示 100.0（体现精度） | V5_称重复核.mp4 |

## 三、可选（有就加）

- [ ] 答辩演练录像（完整讲一遍，10 分钟内）
- [ ] 万用表测 3.3V/5V 轨的短录像（体现供电检查流程）
- [ ] 每个模块的采购链接截图（放 `交付素材/采购链接/`）
