Beiyiovo/stm32-infusion-monitor/文档/明天问导师的问题清单.md

# 问导师的话术（2026-10-22）

> 全文用「我」。把"X 老师"换成老师姓氏。
> 若由别人代为发出，开头加一句：老师您好，我是谢玲，这个课题的负责人。

---

X 老师您好，输液监测装置这边准备开始买件了，有两个地方想请您明确一下，定完我就动手：

**1）滴速这一项做不做？**

任务书里写"集成三种传感器"，但 5 条硬要求只列了温度和重量。我的理解是：滴速要单独加一个红外对射传感器（十几块钱）+ 滴壶的固定结构，才能数出每分钟多少滴。想请您明确——滴速是**必须做出实物**，还是**留好接口、本期不做**就行？

**2）"通过 WiFi 上传平台"具体指什么？**

这里有两种做法，差别比较大：

① 装置自己开热点，手机连上去，用浏览器看实时数据。同一房间内能看，不依赖外网，实现简单。

② 数据发到云平台（比如巴法云、阿里云），手机在任何地方都能看。但要注册平台账号、配 MQTT，调试工作量会明显增加。

请问按 ① 做，算不算满足"上传平台"这一条？还是必须按 ② 做？

麻烦老师了，谢谢！
