Beiyiovo/stm32-infusion-monitor/文档/502面包板连线与调试指南.docx

502 面包板连线与调试指南

42 根线，按顺序接；接完烧一个自检固件就能知道通不通

v1.0 · 2026-10-22 · 调试全程用 USB-TTL

先读这四句

① 接线顺序：先电源（1~4）→ 再各模块电源（5~16）→ 再信号（17~33）→ 电阻（34~38）→ 最后插 USB-TTL（39~42）

② 每接完一组，用万用表量一次红轨与蓝轨：3.2~3.4V，且不短路

③ 面包板电源轨中间是断的（830 孔常见），左右两段必须用短线跨接，否则半边没电

④ ESP32 只接 3 根（GPIO6 / GPIO7 / GND），电源自己走 Type-C

# 一、电源（4 根）

序 | 从 | 到 | 颜色 | 说明
1 | STM32 的 3V3 脚 | 面包板【红色正极轨】 | 红 | 全系统电源
2 | STM32 的 GND 脚（任一） | 面包板【蓝色负极轨】 | 黑 | 公共地
3 | 左半段红轨 | 右半段红轨 | 红 | ★ 830 孔面包板电源轨中间常断开，必须跨接
4 | 左半段蓝轨 | 右半段蓝轨 | 黑 | ★ 同上

# 二、各模块的电源（12 根）

序 | 从 | 到 | 颜色 | 说明
5 | OLED VCC | 红轨 | 红
6 | OLED GND | 蓝轨 | 黑
7 | DS18B20 红线 | 红轨 | 红
8 | DS18B20 黑线 | 蓝轨 | 黑
9 | 蜂鸣器 VCC | 红轨 | 红 | ★ 3V3，不是 5V
10 | 蜂鸣器 GND | 蓝轨 | 黑
11 | HX711 VCC | 红轨 | 红 | 3V3
12 | HX711 GND | 蓝轨 | 黑
13 | 红外模块 VCC | 红轨 | 红 | 3V3
14 | 红外模块 GND | 蓝轨 | 黑
15 | ESP32 的 GND | 蓝轨 | 黑 | ★ 只共地
16 | ESP32 的电源脚 | ★ 哪里都不接 | — | 自己用 Type-C 接 5V 适配器

# 三、信号线（17 根）

序 | 从 | 到 | 颜色 | 说明
17 | OLED SCL | STM32 的 B6 | 黄
18 | OLED SDA | STM32 的 B7 | 黄
19 | DS18B20 黄线（DQ） | STM32 的 A0 | 黄
20 | 蜂鸣器 I/O | STM32 的 B0 | 绿 | 低电平响
21 | 红 LED 正极 → 220Ω | STM32 的 B1 | 橙 | ★ 中间必须串 220Ω
22 | 红 LED 负极 | 蓝轨 | 黑
23 | 黄 LED 正极 → 220Ω | STM32 的 B5 | 橙 | ★ 中间必须串 220Ω
24 | 黄 LED 负极 | 蓝轨 | 黑
25 | 按键 1 一端 | STM32 的 A1 | 蓝 | 另一端 → 蓝轨
26 | 按键 2 一端 | STM32 的 A4 | 蓝 | 另一端 → 蓝轨
27 | 按键 3 一端 | STM32 的 A5 | 蓝 | 另一端 → 蓝轨
28 | 按键 4 一端 | STM32 的 A6 | 蓝 | 另一端 → 蓝轨
29 | HX711 SCK | STM32 的 B10 | 绿
30 | HX711 DT | STM32 的 B11 | 绿
31 | 红外模块 OUT | STM32 的 B12 | 紫
32 | ESP32 GPIO6 | STM32 的 A2 | 白 | ★ 交叉：A2 是发
33 | ESP32 GPIO7 | STM32 的 A3 | 白 | ★ 交叉：A3 是收

# 四、电阻（5 个）

序 | 阻值 | 接在哪两点之间 | 作用
34 | 4.7kΩ | 红轨 ↔ OLED SCL（B6 那条） | I2C 上拉
35 | 4.7kΩ | 红轨 ↔ OLED SDA（B7 那条） | I2C 上拉
36 | 4.7kΩ | 红轨 ↔ DS18B20 的 DQ（A0 那条） | 单总线上拉
37 | 220Ω | B1 ↔ 红 LED 正极 | 限流
38 | 220Ω | B5 ↔ 黄 LED 正极 | 限流

# 五、USB-TTL（4 根，烧录 + 调试）

序 | 从 | 到 | 说明
39 | USB-TTL 的 TXD | STM32 的 A10 | ★ 交叉
40 | USB-TTL 的 RXD | STM32 的 A9 | ★ 交叉
41 | USB-TTL 的 GND | 蓝轨 | 不接会乱码
42 | USB-TTL 的 3V3 / VCC | ★ 不接 | 双电源会顶牛

# 六、烧录流程（★ 这块板只能串口 ISP）

1. USB-TTL 接好：TXD→A10、RXD→A9、GND→蓝轨（VCC 不接）
2. BOOT0 跳线拨到 1（板上有黄色跳线帽，标着 BOOT0）
3. 按一下复位键（RESET）
4. 打开烧录工具 → 选 .bin → 波特率 9600 → 下载
（★ 实测 9600 才稳，115200 从没成功过）
5. 烧完把 BOOT0 拨回 0
6. 再按一下复位 → 程序开始运行
7. 串口助手：115200、8N1、无流控 → 看打印

# 七、上电后怎么验（按这个顺序）

步 | 烧哪个 | 应该看到 | 不对就查
1 | `10_selftest` | I2C 扫到 0x3C、温度正常、按键有反应、手挡红外有电平变化 | 先看这一步：它一次验全部接线
2 | `01_uart` | 串口每秒一行心跳 | 串口线序 / 波特率
3 | `02_oled` | 屏幕显示「输液监测」+ 计数 | 4.7kΩ 上拉 / SDA SCL 是否接反
4 | `03_ds18b20` | 温度 15~45℃ | DQ 上拉 / 是否接 A0
5 | `04_key` | 四个键都有反应 | 按键另一端是否接蓝轨
6 | `05_alert` | KEY1 切换工况，黄/红/蜂鸣器对得上 | 蜂鸣器是否接 3V3
7 | `07_drop` | 手挡 20 次 = 20 滴 | 红外 OUT 是否接 B12 / 是否遮光
8 | `08_tcp` | AT / CWMODE / CWSAP / CIPMUX / CIPSERVER 全 OK | PA2/PA3 是否交叉、是否共地
9 | `06_hx711` | 手压数值变化（要等传感器到） | HX711 供电 / 共地 / DT 接 B11

省时间的做法

★ 先烧 `10_selftest`：它把 I2C、温度、按键、声光、红外五项一次验完。

这一步过了，说明面包板的电源与信号基本都对，后面逐个跑固件才有意义。

# 八、面包板常见假故障（九成是这些）

现象 | 最可能原因 | 怎么查
整块板没反应 | 电源轨没跨接 / 跳线没插到底 | 量红蓝轨电压；换一根杜邦线试
时好时坏 | 面包板孔松了 / 线芯断 | 轻轻拨接线，看是否复现
OLED 黑屏 | 缺 4.7kΩ 上拉 | 量 B6/B7 到红轨是否 4.7kΩ
按键不灵 | 另一端接到了红轨（应接蓝轨） | 万用表通断
蜂鸣器一直响 | VCC 接到了 5V | 改回 3V3
ESP32 无响应 | PA2/PA3 没交叉 / 没共地 | 量通断，确认 GND 接蓝轨
烧录失败 | BOOT0 没拨到 1 / 波特率不是 9600 | 按第六节重来

# 九、现在的物料缺口

今天可以接完并验证：电源、OLED、DS18B20、蜂鸣器、LED、按键、红外、ESP32、USB-TTL。

暂时验不了：HX711 与称重传感器（等货）。那两个到了再烧 06_hx711 / 11_calib。
