Beiyiovo/stm32-infusion-monitor/CHANGELOG.md

# 更新日志 / Changelog

本项目遵循「发现问题 → 记录现象 → 写清原因 → 给出验证」的修复流程。
每条都在真机或可复现的环境里确认过，未验证的会明确标注。

---

## [未发布] 2026-10-27 · v2.1 / v2.2（标定达标 + 功能定稿）

### 新增

- **进阶阈值页「设置2」**（运行页 K3 长按 2 秒进入）：温度下限（默认 20.0℃，可调 15.0~38.0℃）、
  重量上限（默认 1000g）、滴速下限（默认 0=关）——只做黄色预警（上报 R 位 0x10/0x20），
  不触发红色报警/蜂鸣，与常规设置完全不冲突
- **ST-Link V2 烧录链路**：Keil 选 ST-Link Debugger + Reset and Run 后，
  命令行 `UV4 -f xxx.uvprojx -j0` 直接烧录（约 10 秒）；13 个工程的调试器配置已批量生成
- **称重砝码标定达标**：标准砝码组 5/10/20/20/50 g，线性度 0.14%，复核最大偏差 ±0.1 g
  （指标 ±2 g，余量 20 倍）；系统系数 741.6 counts/g
- 滴速红外模块接入：**开机自检 + 运行时电平监测**（新增 `drop_level()`），
  不再要求数到第一滴才显示已接
- 报警蜂鸣改「3 声短促哔」（120ms×3，`AL_BEEP_COUNT` 可配）；
  开机提示改「滴滴两声 + 红黄灯亮 1.5 秒」（原 3 秒长鸣太吵）
- 称重采样重构：10Hz 非阻塞 + **15 点去极值中均值**滤波（排序去两端各 3 个）；
  均值不变，不影响标定系数
- **使用说明与文件导览**（`文档/502使用说明与文件导览.docx`，生成脚本 `_工具/gen_502_userguide.py`）：
  按键功能 × 界面矩阵、参数调节范围、代码地图、文件夹导览、复现步骤与 FAQ

### 修复

#### 1. K3 全无响应（软件原因）
- **现象**：主页 K3 短按/长按都没反应，K1/K2/K4 正常
- **根因**：`key3_pressed()` 内部就是 `key_get_event(3)`——消费型接口，取走事件即清零。
  `handle_keys()` 第一句先调它判设置页，导致后面 UI_RUN 的 `key_get_event(3)` 永远拿到 0
- **修复**：K3 只读一次存 `e3` 全篇复用；长按恢复默认改 2 秒（与 `KEY_LONG_PRESS_MS` 一致）；
  `bsp.h` 给消费型接口补了显式警告注释
- **验证**：编译 0E0W，ST-Link 烧录 Verify OK，用户确认恢复
  （本条由外部协作者定位修复，记录致谢）

#### 2. 11_calib 的 W 显示 1130 g 假数
- **现象**：放 100 g 砝码，屏上 W 显示 1130.7（= raw/K，零点没减）
- **根因**：标定程序自己算的零点只存主程序里，从未喂给驱动，`hx711_grams()` 内 offset 仍为 0
- **修复**：新增 `hx711_set_offset()`，KEY1 算完零点立即喂入；W 恢复正确

#### 3. K1 面板「待机」显示成「机」
- **根因**：「待」不在 86 字字库的字表里
- **修复**：`gen_cnfont.py` 字表补「待/慢」重新生成（88 字）

#### 4. 标定程序按键特别不灵敏
- **根因**：主循环每圈阻塞等 HX711 出数（约 100ms）+ 每 200ms 整屏 I2C 刷新（约 100ms），按键采样被饿死
- **修复**：HX711 就绪才读（非阻塞）+ 逐页刷新（每 40ms 一页）

#### 5. 温度时有时无
- **根因**：探头 DQ 线接触不良（**硬件**）；另外 1-Wire 微秒级时序无中断保护
- **修复**：重插探头线恢复；`ds18b20_start/read` 全程 `__disable_irq()`（每次约 3ms，防 EXTI 干扰）

### 数据（2026-10-27 实测）

- RAW 逐级：空秤 765400±100；50g → +37000；100g → +74100；取下回零偏差 200 counts（±0.27g）
- 标定：ZERO=765410；KEY4 实测 K=742.35（三次复核一致）→ 微调 **741.6**（复测 100g 显示 99.9，-0.1% 修正）
- 13 个工程全部 0 Error / 0 Warning；13_ui = 29,480 B / 32 KB（90%）
- 全部提交已推送 GitHub（5a766ff）

---

## [未发布] 2026-10-22

### 新增

- **11 个分阶段固件工程**（`代码/01_uart` … `代码/11_calib`）
  - 01 串口心跳 · 02 OLED · 03 DS18B20 · 04 按键 · 05 两级告警 · 06 HX711 称重
  - 07 红外数滴 · 08 WiFi+TCP 上报 · 09 整机固件 · 10 接线自检 · 11 称重标定
  - 全部编译通过：0 Error / 0 Warning；最大占用 `09_main` ≈ 20.3 KB / 32 KB
- **通用烧录工具**（从上一项目移植）：`代码/flash_any.bat` + `_flash_any.py`
  - 自动识别工程、编译 → fromelf 转 bin → 找 CH340 → 扫波特率握手 → 烧录
- **串口助手**：`代码/serial.bat` + `_serial_mon.py`；带日志版 `serial_log.bat`
- **9 份文档**（`文档/`）：交接说明、采购清单、引脚连线表、验证方案、接线验收单、
  原理图与PCB要点、网络标签总表、面包板连线指南、PCB设计与布线规范

### 修复

#### 1. 烧录失败：`No module named stm32loader`（2026-10-22）

- **现象**：握手提示「第 2 批就成功（38400）」，但紧接着 4 个波特率全报缺包，烧录失败。
- **原因**：握手阶段是脚本自己用 `pyserial` 发 `0x7F` 读 ACK，不依赖第三方包；
  真正写 Flash 时是 `subprocess` 调用 `python -m stm32loader`，而系统 Python 里没装这个包。
- **修复**：`pip install stm32loader`（装到 0.7.1）+ `_flash_any.py` 增加依赖自检，
  缺包时直接给出安装命令，不再空试 4 个波特率。
- **验证**：用假端口 `COM99` 验证参数格式（`-p/-b/-e/-w/-v/-g`）在 0.7.1 下有效；
  实机烧录后串口收到 `[HB] 运行中 N s`，确认程序在跑。

#### 2. 串口助手崩溃：`UnicodeEncodeError: 'gbk' codec can't encode '\u2713'`（2026-10-22）

- **现象**：打开 COM4 的瞬间抛出编码异常，程序退出。
- **原因**：脚本里用了 `✓`（U+2713），而部分控制台默认 GBK 编码无法表示。
- **修复**：`_serial_mon.py` / `_serial_log.py` 启动时把 stdout/stderr 重设为
  `utf-8 + errors='replace'`。
- **验证**：COM4 正常打开，收到心跳数据。

#### 3. OLED 整屏刷新阻塞主循环（2026-10-22）

- **现象**：`09_main` 每 200ms 调一次 `oled_refresh()`，而整屏刷新约 374ms（上一项目实测），
  主循环几乎全程卡在刷屏里 —— 滴速结算（10 秒窗口）与 TCP 收包被严重饿死。
- **修复**：重绘只写显示缓冲区；送屏改成「一次一页」（每页约 46ms，间隔 40ms 轮转）。
- **验证**：重新编译通过；逻辑上主循环不再有 >50ms 的阻塞点。

#### 4. 浮点 printf 依赖 MicroLib 浮点格式化（2026-10-22）

- **现象**：`06/07/08/09/11` 用了 `%.1f` / `%.0f` / `%.3f`。
- **原因**：工程开了 MicroLib，浮点格式化体积大且个别版本格式串支持不完整。
- **修复**：全部改为整数运算输出（新增 `hx711_grams_x10()` 返回「克×10」整数）。
- **效果**：`06_hx711` Code 7848 → **5388** 字节；`07_drop` 7980 → **5348** 字节。
- **验证**：全工程 `grep %f` 为 0；11 个工程重编 0 Error。

#### 5. 滴速触发沿写死为下降沿（2026-10-22）

- **问题**：不同厂家的槽型/对射模块，遮光时输出可能是高也可能是低。
- **修复**：`drop.h` 增加 `DROP_TRIGGER_RISING` 宏（0=下降沿 / 1=上升沿），实测后改一个数字。

#### 6. Keil 中文路径（结论更正，2026-10-21）

- **原记录**（上一项目）："Keil 工程必须放纯 ASCII 路径"。
- **实测**：Keil MDK 5.42 + ARMCLANG V6.23 在
  `T:\AS\毕业设计\毕业设计2\代码\01_uart\`（**中文路径**）下编译、链接、fromelf 转 bin 全部成功。
- **结论**：本项目代码直接放在中文路径下，交付整包移动即可。

### 已知问题 / 未验证

- 除 `10_selftest` 的心跳外，各传感器功能**尚未在硬件上逐项验证**。
- 称重 ±2g、温度 ±0.5℃、滴速 ±3 滴/min **均无实测数据**。
- ESP32 的 `AT+CIPSERVER` 上报链路未在硬件上跑通。
- 手机端 App 未开始。

---

## [0.1.0] 2026-10-21

### 新增

- 项目开工：课题要求整理、方案对比（X1 / X2 / Z 三条主控路线）
- 选定 **X1**：STM32F103C8T6 + ESP32-C3（AT 固件）
- 采购清单（必买 8 项，约 ¥59~115）、引脚分配表、可行性验证方案
- 仓库初始化（git init，main 分支）
