Beiyiovo/stm32-infusion-monitor/代码/_common/cnfont.c

/**
 ******************************************************************************
 *  cnfont.c —— OLED 中文字库（独立编译单元版）
 ******************************************************************************
 *  ★ 由 _工具/gen_cnfont.py 自动生成
 *  ★ 工程里其实不需要它 —— oled.c 已经 #include 了 cnfont_data.h
 *    保留它只是为了老工程的文件列表不改
 ******************************************************************************
 */
#include "cnfont.h"

const char cnfont_chars[] = "输液监测状态温度重量滴速正常预警报过高低药将尽快静音分钟系统面板版本传感在线未连网络接口参数设置上下限默认恢复开机自检通过失败按键切换返回称已无有中联成功阈值标定行息是否异待慢";

const unsigned char cnfont_data[][32] = {
    {   /* [0] '输' */
        0x00,0x98,0x7C,0xDE,0x18,0x48,0xE0,0xB0,
        0xBC,0xA6,0x26,0xB8,0x10,0xB0,0x20,0x00,
        0x00,0x11,0x11,0xFF,0x19,0x08,0x7F,0x7F,
        0x4A,0x7F,0x00,0x3F,0x40,0x7F,0x00,0x00,
    },
    {   /* [1] '液' */
        0x00,0x60,0x44,0xCC,0x08,0x00,0xC8,0xF8,
        0x38,0x8E,0xFE,0x7C,0x48,0xC8,0xCC,0x00,
        0x00,0x60,0x7C,0x04,0x02,0x03,0xFF,0x7F,
        0x42,0x43,0x6E,0x3B,0x3C,0x67,0x40,0x00,
    },
    {   /* [2] '监' */
        0x00,0x00,0xFC,0xFC,0x00,0xFE,0xFE,0x00,
        0xE0,0x3C,0x1E,0x70,0xD0,0x90,0x10,0x00,
        0x40,0x40,0x7C,0x7E,0x46,0x46,0x7F,0x46,
        0x46,0x7E,0x46,0x46,0x7E,0x7C,0x40,0x40,
    },
    {   /* [3] '测' */
        0x00,0x64,0xC4,0x0C,0x00,0xFC,0x04,0xE4,
        0x04,0xFC,0x00,0xF8,0x00,0xFC,0xFE,0x00,
        0x00,0x70,0x3C,0x06,0x40,0x67,0x3C,0x0F,
        0x10,0x77,0x00,0x0F,0x40,0x7F,0x7F,0x00,
    },
    {   /* [4] '状' */
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
        0x1A,0x02,0x42,0x7F,0x3F,0x02,0x02,0x00,
    },
    {   /* [87] '慢' */
        0x00,0xE0,0x20,0xFE,0x10,0x70,0xC0,0x7E,
        0xEA,0x6A,0x6A,0xEA,0x7E,0x7C,0xC0,0x00,
        0x00,0x00,0x00,0xFF,0x00,0x40,0x47,0x47,
        0x7F,0x37,0x37,0x37,0x4F,0x47,0x41,0x00,
    },
};
