Beiyiovo/stm32-infusion-monitor/代码/11_calib/main.c

/**
 ******************************************************************************
 *  502 标定固件（11_calib）—— 称重零点与换算系数，一次按键搞定
 ******************************************************************************
 *  硬件：HX711 VCC→3V3  GND→GND  SCK→PB10  DT→PB11
 *        传感器 4 线接 HX711 的 E+/E−/A+/A−
 *
 *  流程（屏幕和串口同步显示）：
 *      1) 上电后不放东西，等读数稳定
 *      2) KEY1 短按 → 采 20 次平均作为【零点 offset】
 *      3) 放上 100g 砝码（KEY2 可在 100/200/500g 之间切换）
 *      4) KEY4 短按 → 采 20 次平均，自动算出【换算系数 scale】
 *      5) 把串口打印出来的两行数字抄进代码即可
 *
 *  屏幕显示：
 *      RAW:   -123456
 *      ZERO:  -120000
 *      CAL:   100 g
 *      K:     1012.34 c/g
 *
 *  ★ 2026-10-27：主循环改非阻塞采样（原来阻塞等 HX711 ~100ms/圈，按键特别不灵敏）；
 *    平均样本 20→15（约 1.5 秒/次）。
 *  ★ 2026-10-27 二次修复：
 *    · W 显示 bug——本程序自己算的零点没喂给 hx711 驱动（驱动内零点一直是 0），
 *      导致 W = raw/K，放 100g 显示 ≈1130g 假数。已加 hx711_set_offset() 喂进去。
 *    · 整屏 I2C 刷新（每 200ms 阻塞 ~100ms，按键被吞）改逐页刷新。
 *
 *  ★ 为什么不用买"称重显示模块"：一个传感器只能接一个 HX711，
 *    带显示的成品是独立一套，跟本电路不能共用；本固件已经能显示标定结果。
 ******************************************************************************
 */
#include "bsp.h"
#include "i2c.h"
#include "oled.h"
#include "app502.h"
#include "hx711.h"

static int32_t s_offset = 0;
static float   s_scale  = 0.0f;
static int32_t s_raw    = 0;
static int16_t s_cal_g  = 100;      /* 当前标定用的砝码重量 */
static int32_t s_zero_prev = 0;     /* 上一次的零点，用于异常检测 */

static int32_t avg_raw(uint16_t n)
{
    int32_t  sum = 0;
    uint16_t ok  = 0;
    uint16_t i;
    int32_t  r;

    for (i = 0; i < n; i++) {
        r = hx711_read_raw();   /* 读函数自带等待，出来就是新样本 */
        if (r != HX711_ERR) { sum += r; ok++; }
    }
    if (!ok) return 0;
    return sum / (int32_t)ok;
}

static void draw(void)
{
    char buf[24];

    oled_draw_cn(0, 0, "称重标定");

    snprintf(buf, sizeof(buf), "RAW:%8ld", (long)s_raw);
    oled_draw_str(0, 2, buf);

    snprintf(buf, sizeof(buf), "ZERO:%7ld", (long)s_offset);
    oled_draw_str(0, 3, buf);

    snprintf(buf, sizeof(buf), "CAL:%3d g ", s_cal_g);
    oled_draw_str(0, 4, buf);

    if (s_scale > 0.0f) {
        snprintf(buf, sizeof(buf), "K:%8.2f", (double)s_scale);
        oled_draw_str(0, 5, buf);
        snprintf(buf, sizeof(buf), "W:%6.1f g", (double)hx711_grams(s_raw));
        oled_draw_str(0, 6, buf);
    } else {
        oled_draw_str(0, 5, "K: -- not cal");
        oled_draw_str(0, 6, "                 ");
    }

    oled_draw_str(0, 7, "K1:ZERO K4:CAL");
    /* ★ 2026-10-27：不再整屏刷新（阻塞 ~100ms，按键全被吞），改主循环逐页刷 */
}

int main(void)
{
    uint32_t t_draw = 0;
    uint32_t t_page = 0;
    uint8_t  page   = 0;

    bsp_init();
    app502_init();
    uart1_init();

    printf("\r\n[BOOT] 502 称重标定固件\r\n");
    printf("[CAL] 步骤：空载 → KEY1 定零点 → 放砝码 → KEY4 定系数\r\n");

    hx711_init();
    delay_ms(300);

    i2c_init();
    oled_init();
    oled_clear();

    while (1) {
        /* ★ 2026-10-27 重排：先扫键，HX711 就绪才读（非阻塞）。
         *   原来每圈阻塞等 HX711 出数（~100ms），按键采样太稀 → 按起来特别不灵敏。
         *   ★ key_any_just_pressed() 读后即清，每圈只调一次 */
        uint8_t k  = key_any_just_pressed();
        uint8_t e4 = key4_event();

        /* --- KEY1：定零点 --- */
        if (k == 1) {
            printf("[CAL] 采零点中（空载，别碰）...\r\n");
            s_offset = avg_raw(15);
            hx711_set_offset(s_offset);     /* ★ 喂给驱动：否则 W 显示不减零点 */
            printf("[CAL] ★ ZERO = %ld（已喂给驱动）\r\n", (long)s_offset);
            if (s_zero_prev != 0 && (s_offset - s_zero_prev > 100000 || s_zero_prev - s_offset > 100000)) {
                printf("[CAL] !! 警告：零点比上次差了 %ld counts\r\n",
                       (long)(s_offset - s_zero_prev));
                printf("[CAL] !! 秤上是不是还放着东西？这组零点不可用，取下来重新按 KEY1\r\n");
            }
            s_zero_prev = s_offset;
            buzzer(1); delay_ms(60); buzzer(0);
        }

        /* --- KEY2：切换砝码重量 --- */
        if (k == 2) {
            if      (s_cal_g == 100) s_cal_g = 200;
            else if (s_cal_g == 200) s_cal_g = 500;
            else                     s_cal_g = 100;
            printf("[CAL] 标定重量 → %d g\r\n", s_cal_g);
        }

        /* --- KEY4：定换算系数（短按 1 / 长按 2 都接受） --- */
        if (e4 != 0) {
                int32_t a;
                printf("[KEY] KEY4 事件=%u\r\n", e4);
                a = avg_raw(15);
            if (s_scale == 0.0f && s_offset == 0) {
                printf("[CAL] 提示：还没定零点，先按 KEY1\r\n");
            }
            if (a != 0) {
                s_scale = (float)(a - s_offset) / (float)s_cal_g;
                hx711_set_scale(s_scale);
                printf("[CAL] AVG = %ld, CAL = %d g\r\n", (long)a, s_cal_g);
                {
                    int32_t milli = (int32_t)(s_scale * 1000.0f + 0.5f);
                    printf("[CAL] SCALE = %ld.%03ld counts/g\r\n",
                           (long)(milli / 1000), (long)(milli % 1000));
                    printf("[CAL] 抄进代码：hx711_set_scale(%ld.%03ldf);\r\n",
                           (long)(milli / 1000), (long)(milli % 1000));
                }
                buzzer(1); delay_ms(120); buzzer(0);
                }
            }

        /* --- 采样：HX711 就绪才读（非阻塞），主循环 ~10ms 一圈，按键不丢 --- */
        if (hx711_ready()) {
            int32_t r = hx711_read_raw();
            if (r != HX711_ERR) s_raw = r;
        }

        /* --- 屏幕内容 200ms 重画一次（只写内存缓冲，不碰 I2C） --- */
        if ((millis() - t_draw) >= 200) {
            t_draw = millis();
            draw();
        }

        /* --- ★ 逐页刷新：每 40ms 只发 1/8 屏（原来整屏一次 ~100ms，把按键全吞了） --- */
        if ((millis() - t_page) >= 40) {
            t_page = millis();
            oled_refresh_page(page);
            page = (uint8_t)((page + 1) & 7);
        }

        delay_ms(5);
    }
}
