Beiyiovo/stm32-infusion-monitor/(commit log)

2026-10-21 初始化：502 输液状态 WiFi 监测装置
    - 代码：01_uart 阶段（串口 + 心跳），build.bat 一键编译，实测中文路径可编译
    - 文档：项目交接说明 / 采购清单 / 引脚连线表 / 可行性验证方案 / 代码移植计划
    - 工具：文档生成脚本（python-docx / openpyxl）
    - 测试记录：目录与记录规范（尚未填入真实数据）
    [502采购清单(可勾选).xlsx]
2026-10-21 docs: AGENTS 同步仓库结构（README / 测试记录 / git 状态）
2026-10-22 方案变更：滴速要做 + 安卓 App + 局域网 TCP
    - 导师 2026-10-22 确认：滴速必做；手机端做安卓 App；数据通过 WiFi 送到手机
    - 链路定为局域网为主（ESP32 TCP Server + 手机同热点），上报层预留 MQTT 切换
    - 更正：滴速传感器改红外对射（分体式）——槽型光耦 5mm 槽卡不进 20mm 滴壶
    - 采购清单：必买 8 项 59~115（新增红外对射）
    - 引脚表：PB12 由预留转为正式（外部中断数滴），新增红外对射逐脚连线
    - 验证方案：新增阶段6 滴速；原 WiFi 阶段改为阶段7 App；共 10 阶段
    [502采购清单(可勾选).xlsx]
2026-10-22 代码：02~08 全部写完并编译通过
    - 新增 _common：app502(黄灯/KEY4) hx711 drop alert502 report_tcp lib/stm32f10x_exti.c
    - 08_tcp 用非阻塞温度状态机（避免 ds18b20_get 阻塞 800ms 漏掉滴速与收包）
    - _工具/gen_keil_stage.py：按模板批量生成各阶段 Keil 工程
    - 各阶段 bin：02 10660B / 03 6000B / 04 4328B / 05 5052B / 06 8288B / 07 8376B / 08 17680B
    - 全部 0 Error 0 Warning；尚未在任何真实硬件上运行
    [502采购清单(可勾选).xlsx]
2026-10-22 代码：09_main 整机固件编译通过
    - 整合三路传感器 + 两级告警 + 阈值设置 UI + TCP 上报
    - 温度采集改两段式（start/read），避免阻塞 800ms 丢滴速与收包
    - Flash 占用 Code 17924 + RO 2020 = 19.9KB / 32KB
    - 仍未上板验证
2026-10-22 新增：面包板接线验收单 + 10_selftest 自检固件
    - 文档/面包板接线与通电验收单.docx：9 步接线顺序、滴速专项、静态检查、故障对照
    - 代码/10_selftest：一次上电验全部接线（I2C 扫描/DS18B20/4键/声光/红外电平），不依赖称重传感器
    - 编译 0 Error 0 Warning，bin 14416 B
    [gen_502_wiring.py, gen_keil_stage.py, main.c]
2026-10-22 滴速触发沿可配置 + 选件评估入档
    - drop.h 新增 DROP_TRIGGER_RISING（0=下降沿/1=上升沿），drop.c 按宏选 EXTI 触发沿
    - AGENTS 记录：15mm 槽型光耦模块优先（需滴壶≤14mm）；10kg 称架不可用（0.05%FS≈5g 超指标）
    - 07/08/09 重新编译通过
2026-10-22 定案：1kg 称架成品 + 15mm 槽型模块 + 小滴壶（记录滴系数）
2026-10-22 新增 11_calib 称重标定固件
    - KEY1 定零点、KEY2 切换 100/200/500g 砝码、KEY4 自动算换算系数
    - 屏幕与串口同时输出 raw / offset / scale，可直接抄进代码
    - 编译 0 Error 0 Warning，bin 13060 B
    [gen_keil_stage.py, main.c]
2026-10-22 新增：接线原理图 + 原理图/PCB 设计要点文档
    - _工具/gen_schematic.py 用 Pillow 绘制模块级原理图（2400x1740）
    - 文档/502原理图与PCB设计要点.docx：原理图 + 网表 + 阻容清单 + 11 条布局规则 + 打板检查清单
    - 引脚与固件逐条比对一致（PA0/PB0/PB1/PB5/PB6/PB7/PB10/PB11/PB12/PA1/PA4/PA5/PA6/PC13）
2026-10-22 新增：逐器件接线总表（全引脚版）
    - 每个元器件单独一节，逐脚列出：接到哪 / 必接? / 说明与坑
    - STM32 全部 36 个 GPIO + 电源/特殊脚单独一张表（含明确'不接'的脚）
    - 新增第 14 节：项目1 已在真实硬件验证过的 6 条结论（I2C 上拉必做、蜂鸣器 3V3、ESP32 独立供电等）
    - 共 18 张表、121 行；渲染 6 页检查通过
2026-10-22 新增：STM32 逐脚接线顺序表（按板上丝印、右列上→下）
    - 38 个位置逐行列出：位置/丝印/芯片脚/接什么/必接?
    - 单列 SWD 小排针处理方式
    - 5V、GND、3V3 三处易错点单列
    - 渲染 3 页检查通过
2026-10-22 更正：STM32 逐脚顺序表 v2（按实物丝印）
    - v1 按常见 Blue Pill 图推断，漏了 R（第 4 位），导致第 4 位以后整体错位一格、Vbt 未列
    - v2 按用户实物板丝印：右排 GND GND 3V3 R B11 B10 B1 B0 A7... C15 C14 C13 Vbt；左排 B12...B9 5V GND 3V3
    - 共 40 位，逐行列出
2026-10-22 新增：网络标签总表（画原理图用）
    - 19 条网络标签：每条列出该挂的 STM32 引脚 + 模块引脚（即节点清单）
    - STM32 40 位逐行给出网络标签
    - 各模块引脚 → 标签对照（38 行）
    - TX/RX 交叉命名规则与自检方法
2026-10-22 代码：去掉浮点 printf（改整数输出）+ 新增面包板连线指南
    - 06/07/08/09/11 的 %f 全部改为整数运算输出，避免依赖 MicroLib 浮点格式化
    - 06_hx711 Code 7848→5388 字节，07_drop 7980→5348
    - 新增 文档/502面包板连线与调试指南.docx：42 根线逐根列、烧录流程、上电顺序、假故障对照
    - 全部 11 个固件重新编译：0 Error 0 Warning
    [gen_502_breadboard.py, hx711.c, hx711.h, main.c]
2026-10-22 修复：09_main 整屏刷新阻塞问题
    - oled_refresh() 整屏约 374ms，原来每 200ms 调一次会把滴速中断与网络收包饿死
    - 改为：重绘只写缓冲区（200ms 一次），屏幕按页推送（每次一页 ~46ms，40ms 间隔）
    - 二进制 0 Error 0 Warning
    [gen_502_breadboard.py, main.c]
2026-10-22 新增：PCB 布局参考图 + 布线规范；移植 501 的通用烧录工具
    - _工具/gen_pcb_layout.py：100x80mm 布局参考图（排母/按键/ISP/天线禁布区）
    - 文档/502_PCB设计与布线规范.docx：板参数、线宽表、自动布线的正确用法、布线顺序、打板检查清单、立创EDA 步骤
    - 代码/flash_any.bat + _flash_any.py：从 bishe501 移植，自动发现 11 个工程
    - 冒烟测试：能识别 Keil/fromelf/11 个工程（未插 CH340，烧录未实测）
2026-10-22 修复：烧录失败 'No module named stm32loader'
    - 原因：系统 Python 3.13 缺 stm32loader 包（握手用的是 pyserial，所以握手能过）
    - 已安装 stm32loader 0.7.1（含 progress 1.6.1）
    - 验证参数兼容：-p/-b/-e/-w/-v/-g 在 0.7.1 下均有效
    - _flash_any.py 增加依赖自检：缺包时直接提示安装命令，不再空试 4 个波特率
    [_flash_any.py]
2026-10-22 移植串口助手 + 新增 CHANGELOG（含 6 条修复记录）
    - 移植 serial.bat / _serial_mon.py / serial_log.bat / _serial_log.py
    - 修复串口助手在 GBK 控制台崩溃（U+2713 无法编码）→ 启动时强制 UTF-8
    - CHANGELOG.md：记录 stm32loader 缺失、串口编码、OLED 刷新阻塞、浮点 printf、
    滴速触发沿、中文路径更正，每条含现象/原因/修复/验证
    [_serial_log.py, _serial_mon.py]
2026-10-22 烧录工具更新 + README 补当前进度与下一步
    - _flash_any.py：DESC 换成 502 的 11 个工程描述（看的出每个是干什么的）
    - 烧录成功后可直接回车打开串口助手，省一次双击
    - README：10_selftest 标记为已上板跑通；新增「九、当前要做的事」五步清单
2026-10-22 README 调整章节顺序（八/九/十）
2026-10-22 AGENTS：更新为当前真实状态（板子可跑、下一步 5 步）
2026-10-22 新增 12_led：LED 专项测试（红/黄各亮 2 秒）
    - 自检里声光只有 120ms，肉眼看不清哪个不亮；这个每个亮 2 秒
    - 顺序：红 2s → 全灭 → 黄 2s → 全灭 → 红+黄 2s → 全灭
    - 修好 gen_keil_stage.py（上一轮 PowerShell 插入把 FILE_TPL 弄坏了）
    - 烧录工具 DESC 增加 12_led
2026-10-22 新增 13_ui：整机 UI 固件（运行界面 + 系统面板）
    - 运行界面：温度 / 重量 / 滴速 / 报警状态 / 开机时长；未接传感器显示 --
    - KEY1 切换系统面板：版本、TEMP/HX711/IR/NET 在线状态
    - KEY2 消音、KEY4 长按去皮
    - 温度两段式采集 + 分页刷屏，不阻塞滴速与收包
    - 编译 0 Error 0 Warning，Flash 20.7KB / 32KB
    [_flash_any.py, gen_keil_stage.py, main.c]
2026-10-22 修复 ESP32 上电握手时机：等 2 秒 + AT 重试 5 次
    - 原来 uart2 初始化后只等 300ms 发 AT，ESP32-C3 冷启动未就绪 → 必然失败
    - 改为等 2s，AT 重试 5 次（每次 600ms 超时）
    - 失败时打印 5 条排查项 + 是否收到过字节（波特率不对的线索）
    - 08_tcp / 09_main / 13_ui 重新编译通过
    [report_tcp.c]
2026-10-22 新增安卓 App（TCP 客户端）+ APK
    - 基于项目1 的 Android 工程模板（已验证可离线编译）
    - MainActivity：连 192.168.4.1:8080，按行解析 T/W/D/L，断线自动重连，每 2s 发心跳
    - 界面：温度/重量/滴速三块大数字 + 状态条（绿/黄/红）
    - APK 5.9MB 放在 代码/android/apk/
    - 工程源码在 代码/android/project/（构建请用 T:\\AS\\bishe502_app）
2026-10-22 App 界面重做（炫酷版）+ 新图标
    - GaugeView：自绘 270° 环形仪表盘（渐变弧 + 中心大数字），不引第三方库
    - LevelBarView：液位条（渐变填充 + 高光）
    - 布局：深色渐变背景 + 半透明卡片 + 圆角；温度用仪表盘，重量用液位条，滴速用呼吸点动画
    - 图标：自适应图标改为渐变底 + 输液袋/心电图/液滴矢量
    - 注意：增量构建没重新打包图标，clean 后 APK 从 6.14MB → 5.76MB 才对
2026-10-22 v2.0：分级告警扩展 + 四键方案 + 开机自检 + App 同步
    固件
    - alert502：新增 温度过低(<32℃) 黄灯、滴速过快(>=120) 红灯 4Hz 快闪
    - 蜂鸣器改为「进入报警响 3 秒后自停」，不再持续响
    - 13_ui 重写：开机自检页、运行/面板/设置三界面、四键含长按
    - 上报帧增加 R= 报警原因位掩码
    App
    - 解析 R，状态条显示「报警 · 温度过高」等具体原因
    文档
    - README 新增「功能说明 v2.0」：按键表、红黄灯规则表、OLED 页面、帧格式
2026-10-22 OLED 全中文界面 + 81 字字库
    - 新增 _工具/gen_cnfont.py：用 simhei.ttf 渲染 16x16 点阵，生成 cnfont_data.h（含 CN_COUNT）
    - 字库从 17 字扩到 81 字，覆盖 温度/重量/滴速/报警/面板/设置/开机自检
    - 13_ui 界面改为中文：温度/重量/报警/预警/正常/系统面板/参数设置
    - 数值放在中文行下半页，与汉字底部对齐
    - 13 个固件全部 0 Error 0 Warning
    [cnfont.c, cnfont_data.h, gen_cnfont.py, main.c]
2026-10-22 清理：boot_screen 里未使用的 buf（消掉最后一条 warning）
2026-10-22 修 4 个真 bug（显示半字 / K4 无效 / 灯闪不到 2Hz / K3 冲突）
    1. 每帧先 oled_clear()：切换界面时旧画面残留在未重写的页里，表现为「字只显示一半」
    2. KEY4 事件码写错（实际 1=短按 2=长按，原来写 e4==3）→ 设置里加数值完全没反应
    3. alert502_update 原来只在 1 秒的执行块里调用 → LED 闪烁被限速到 1Hz，蜂鸣器 3 秒计时不准；
    改为主循环每轮调用（09_main / 08_tcp / 13_ui 三处同类问题一起改）
    4. KEY3 长按复位与「进入设置」冲突，改为只在设置界面内允许长按复位
    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
    [gen_oled_preview.py, main.c]
2026-10-22 设置界面重构：加/减、光标与数值对齐、开机提示音
    - 设置里 K4 加、K2 减（K2 在设置界面里不再管静音）
    - 布局：光标 > 在最左，标签 x=12，数值右对齐 x=84，标题行右侧显示 K2-/K4+ 提示
    - 开机自检：蜂鸣器响 1.2 秒 + 红黄灯同时亮，作为上电提示
    - 13_ui 0 Error 0 Warning
    [main.c]
2026-10-22 修复：设置界面 K4 加不上去（e4==3 应为 e4==1）
    - 上一轮的字符串替换没匹配上且未做验证，导致加号分支永远不执行
    - 本次改完做了 grep 复核：e4==3 出现 0 次，e4==1 在设置分支、e4==2 在去皮分支
    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
    [main.c]
2026-10-22 K4 增加可见反馈 + 面板滴速显示「未接」
    - K4 短按在任何界面都让红黄灯同时亮 250ms 并串口打印，用来判断是按键硬件问题还是软件问题
    - 系统面板：红外未接时直接显示中文「未接」，不再显示 --（以前容易以为没显示）
    - 实测复核：grep 确认 e4==1 分支存在、set_inc 被调用
    [main.c]
2026-10-22 根因修复：key4_event() 没有调用 key4_scan()，导致 K4 完全无反应
    - key4_scan() 只被 key4_pressed() 调用；13_ui / 09_main / 04_key 都只调 key4_event()
    → 扫描从不执行 → s_key4_event 恒为 0 → 短按/长按都收不到
    - 在 key4_event() 开头补 key4_scan()，一处修复影响全部含 app502 的固件
    - 13 个固件重编 0 Error 0 Warning
    [app502.c]
2026-10-22 界面重排：主页=温度/重量/滴速，K1页=静音/网络/状态
    - 主页四行：标题(正常时输液监测，报警时显示报警原因) + 温度 + 重量 + 滴速
    - K1 页改为系统状态：静音 是/否、网络 正常/异常、状态 正常/预警/报警
    - 字库扩到 86 字（新增 行/息/是/否/异）
    - 预览图已同步；13 个固件 0 Error 0 Warning
    [cnfont.c, cnfont_data.h, gen_cnfont.py, gen_oled_preview.py, main.c]
2026-10-22 去掉 K4 亮灯反馈；开机提示音与灯延长到 3 秒
    - K4 短按只在设置界面里 +1，不再点灯（亮灯只是临时诊断手段）
    - 上电/复位：蜂鸣器响 3 秒 + 红黄灯同时亮 3 秒
    - 13_ui 0 Error 0 Warning；grep 复核 delay_ms(3000) 已在位
    [main.c]
2026-10-23 联调后优化：发送超时 1s→300ms、网络状态三分、开机提速
    - report_send 等 '>' 的超时从 1000ms 降到 300ms（实测 10~30ms 就回，1 秒会卡主循环）
    - 系统状态页网络改为 已连 / 待机 / 异常（原来只区分 正常/异常，看不出手机是否连上）
    - 开机自检页停留 2.5s → 1.5s
    - README 标注 09_main 为历史版本
    - 13 个固件 0 Error 0 Warning
    [main.c, report_tcp.c]
2026-10-23 App v3：克重为主视觉 + 趋势图 + 剩余时间估算
    - 主页信息层级改为 克重 > 液温 > 滴速
    - 新增 TrendView：最近 60 个点的重量趋势折线（带渐变填充）
    - 新增 液位百分比（按 500g 满袋）、预计剩余时间（剩余g÷滴速，20滴/ml）
    - 新增 累计滴数（按 2 秒帧间隔累加）
    - 修复：状态栏遮挡标题（Android 15+ 边到边，改用 WindowInsets）
    - 修复：按钮被 Material3 默认紫色覆盖（改 AppCompatButton）
    - 修复：仪表盘文字重叠（调整字号与位置）
    - 截图存档 文档/_图_APP界面.png
2026-10-24 标定：写入实测系数 802.0 counts/g + 记录复标待办
    - hx711.h 默认系数 1000 → 802.0（两次标定 801.990/801.920，偏差 0.009%）
    - 13_ui：帧里重量改发一位小数；上电自动去皮（50 次）；5 点滑动平均 + ±3g 死区
    - 13_ui：重量量程 500→1000g（App 同步）
    - 11_calib：修 key_any_just_pressed 重复调用导致 KEY2 失效；KEY4 长短按都接受；零点异常告警
    - README/AGENTS：记录标定值、偏小 2% 的原因与复标公式
2026-10-24 交付物打包：新增 交付说明/固件/硬件/测试记录
    - 交付说明.md：30 秒了解、目录结构、4 步复现、验证程度、硬件清单、关键约定、已知限制
    - 固件/：13 个阶段的 bin+hex（含说明.md），不装 Keil 也能烧
    - 硬件/：原理图网表 + 3 张 PCB 截图
    - 测试记录/：生成 502测试记录.docx（8 项测试、标定数据、7 个 bug 修复、未完成项）+ 串口原始记录.md
    - README 顶部加交付说明入口
    - 总大小 19.9 MB（上限 6 GB）
    [gen_502_testlog.py]
2026-10-27 v2.1 优化：报警蜂鸣改3声短促/开机滴两声/按键非阻塞扫描/滴速开机自检/称重15点去极值滤波
2026-10-27 修复 11_calib 两处遗留：W 显示未减零点(新增 hx711_set_offset)/整屏刷新阻塞改逐页，按键恢复灵敏
    [hx711.c, hx711.h, main.c]
2026-10-27 标定定稿：SCALE=742.35 counts/g（砝码三次复核，最大偏差+0.1g）；整机v2.1已烧板
2026-10-27 v2.2：K1面板待机假字修复(字库补待/慢至88字)+进阶阈值页(运行页K3长按2秒:温度下限/重量上限/滴速下限,只黄预警不红不响)
2026-10-27 进阶阈值默认值放宽：温度下限20.0℃(可调15~38)/重量上限1000g/滴速下限0=关，防误报
2026-10-27 加固：DS18B20 1-Wire 全程关中断（防红外 EXTI 干扰时序导致温度读不到）
2026-10-27 称重系数微调 742.35→741.6（复测 -0.1g 修正，W=counts/K 方向：K 减显示增）
    [hx711.h]
2026-10-27 文档定稿：CHANGELOG补10-27全节+清理乱码、README指标表达标+标定741.6+v2.2功能、交付说明同步、AGENTS会话记录、测试记录v1.1（含外部AI修复的K3条目）
2026-10-27 更正：测试记录 v1.1 重生成（上一提交的 docx 误用旧脚本，现含 10-27 全部条目）
2026-10-27 交付包客户化：新增 00_客户必读（入口引导+FAQ）与 交付素材/拍摄清单（P1~P8/V1~V5）
2026-10-28 新增《502使用说明与文件导览.docx》：按键功能×界面矩阵/参数范围/代码地图/文件夹导览；挂入客户必读/交付说明/CHANGELOG 索引
2026-10-28 清理 gen_502_userguide 的转义警告并重生成文档
2026-10-28 docs: 新增《00_客户交付说明书.docx》——面向客户的总说明书（10章/9页）；同步更新客户必读入口
2026-10-28 docs: 客户说明书文件数与大小改为约数，避免随文件增减失真
2026-11-01 chore: PCB设计文件与截图入库（Altium导出+接线/布局截图）；客户交付说明书同步更新
